OpenDAP-org/board/README.md

# Board

Main board of the OpenDAP T1: the SoC-based single board computer, its auxiliary MCUs and simulations.

## Layout

- `hardware/`
- `firmware/`
- `sim/`
- `export/`
- `docs/`

## License

This repository follows the [REUSE](https://reuse.software) layout: license texts live in `LICENSES/` and `REUSE.toml` maps each path to its license.

- Default: **Creative Commons Attribution-ShareAlike 4.0** (`CC-BY-SA-4.0`)
- `hardware/`: **CERN Open Hardware Licence v2 – Strongly Reciprocal** (`CERN-OHL-S-2.0`)
- `firmware/`: **MIT** (`MIT`)
- `sim/`: **GNU GPL v3.0 or later** (`GPL-3.0-or-later`)
- `export/`: **CERN Open Hardware Licence v2 – Weakly Reciprocal** (`CERN-OHL-W-2.0`)
- `docs/`: **Creative Commons Attribution-ShareAlike 4.0** (`CC-BY-SA-4.0`)

Copyright © 2026 The OpenDAP Project.
