OpenDAP-org/board/docs/concept-art/README.md

# Concept art

These images are screenshots of interactive 3D concept models from earlier experiments (artifacts dated 2026-10-22). They are kept here as visual inspiration only.

**They are not designs, specifications or decisions.** The captures give the general visual idea, but their parts and exploded views often have glitches and bad design decisions, because they were not based on real data or simulations. Dimensions, part choices, component placement and layouts shown in them may be wrong and must not be taken from them. This also applies to any text visible in the captures (title panels, labels, numbers): it comes from the old experiment and is not confirmed information.

The real design is built in this repository, with simulation and real structure.

## Images

- `sbc-three-quarter.png`: Three-quarter view of a dark green-black circuit board with gold edge-connector fingers at the top, large black module blocks in the centre and connectors along the bottom edge.
- `sbc-side-b.png`: Flat view of the other side of the board: mostly bare dark surface with a grid of gold dots, a long slim connector near the right edge and a few parts at the bottom.
- `sbc-exploded.png`: Exploded view: the board with its stacked modules and shields pulled apart to the left, a blue card to the right and bottom connectors floating below.
