OpenDAP-org/board/docs/specs/pcb-design-constraints.md

# Main board PCB design constraints

- **Status:** Draft v0.11 (2026-10-24: [stackup v1](stackup-v1.md) applied, its §7: board thickness, build and layer count (PCB-S-01 to S-03), the stack meets S-04 and S-12, dielectrics (S-05), new PCB-S-14 (impedance classes on L1, L3, L8, L10 only) and S-15 (delay matching across layers), the impedance-class exception to PCB-G-01, the width and gap of every impedance class (PCB-I-01 to I-09, I-12), PCB-I-07 reworded as a microstrip over a cut-out, the RF stack values and the `RF_CUTOUT` rule area (PCB-R-03); DRC rules for widths, pair gaps, layers and the RF cut-out). Was Draft v0.10 (2026-10-24: hat-standard [interface v1.1](https://github.com/opendap-project/hat-standard/blob/main/docs/specs/interface-v1.md) and its [ADR 0005](https://github.com/opendap-project/hat-standard/blob/main/docs/adr/0005-interface-v1-1-shared-extension-and-contact-reduction.md): the shared extension class `HAT_EXT_100D` (PCB-I-12), the extension switch placement (PCB-I-13), PCIe and CSI-2 rows ending at the switch, one DF40 connector; HAT power rows at the tolerance-included trips of [BOM v1.11](bom-v1.md#changes-in-v111) with a new `PWR_HAT5V` class (PCB-P-04, P-05, P-20); DRC rules for P-20 and the extension via count). Was Draft v0.9 (2026-10-24: battery interface rows PCB-L-04 to L-10 from [ADR 0020](../adr/0020-battery-connected-through-contacts.md) and its [research note](../research/2026-10-contact-battery-t1.md) §6, with DRC rules for L-04, L-05 and L-08; wording of PCB-M-07, Z-01, P-01, P-17 and L-02 for the battery contacts). Was Draft v0.8 (2026-10-24: metal-case antenna rows PCB-R-08 to R-13, BRD-061), Draft v0.7 (2026-10-24: radio rows from ADR 0018) and Draft v0.6 (2026-10-24; v0.2 applies ADR 0016, v0.3 Rockchip's layout rules, v0.4 Murata's 2EL notes and the interface standards, v0.5 the design-for-compliance constraints and RFC 0010 levels, v0.6 the DFM rule families, the industry-wisdom gaps and the craft net-class names). Task E2.1 of the [electronics plan](https://github.com/opendap-project/t1/blob/main/docs/plans/2026-10-electronics-plan.md). Nothing here is laid out or measured yet.
- **Method:** this specification applies the [PCB design constraints method](https://github.com/opendap-project/toolkit-hardware/blob/main/docs/specs/pcb-design-constraints-method.md) every OpenDAP board follows (sections, categories and IDs, columns, enforcement kinds, levels and severity).
- **Purpose:** every limit the main-board layout must respect, derived from the product requirements, the parts and the fab, in one place. Each constraint has an ID, a minimum, a target and a maximum where they apply, its source, and the mechanism that enforces it.
- **Changes in v0.6:** DFM families H, B, D, V, W and L added as constraints; industry-wisdom gaps added under new IDs (mapping in the gaps note, "IDs as integrated"); PCB-I-09 reworded (no guard traces) with the MCLK branch limit; impedance-controlled net classes renamed `<name>_<ohms>SE` / `<name>_<ohms>D`; project rules composed in `hardware/t1-main-board/`.
- **Enforced by:** `DRC` = the T1 product rules ([`hardware/rules/`](../../hardware/rules/)), composed after the PCBWay HDI fab rule set and the OpenDAP craft rule set into [`hardware/t1-main-board/t1-main-board.kicad_dru`](../../hardware/t1-main-board/) (E3.4, E3.5); a rule whose value is still **UNVERIFIED** is a DRC warning, the others are errors; `NC` = net class in [`hardware/rules/netclasses.toml`](../../hardware/rules/netclasses.toml) (E2.4); `CHK` = a script check on the layout (E4.5); `SIM` = a simulation in `sim/` (E4.4); `REV` = a review item with its checklist line, because no tool can check it.
- **Levels:** `[Qn]` after an ID is the RFC 0010 quality level at which the constraint becomes mandatory; an ID without it is Q1 until it is next reviewed.
- **Values:** a value with no source is not used. **UNVERIFIED** marks values taken from a sibling part, an assumption, or a source not yet retrieved; each one names what closes it. Arithmetic is shown as such. Rows of families H, B, D, V, W and L cite the [DFM and reliability rules](../research/2026-10-pcb-dfm-reliability-rules.md) research (`DFM §n` and its source keys); rows from the [industry wisdom gaps](../research/2026-10-industry-wisdom-t1-gaps.md) cite their gap (`G-nn`) and practice (`IW-…`).

## 0. Summary

1. **Front side under the display: parts up to 1.0 mm; the body grows to 25 mm** ([ADR 0016](../adr/0016-front-side-height-under-the-display.md)). The thickness stack gave 0.3 mm between the display and the board, while about 2,100–3,700 mm² of parts must sit under the display. The extra 1.0 mm comes from body thickness (T1-031 maximum), not from the battery, whose energy is the limit of T1-039. No thickness margin is left within 25 mm.
2. **High-speed values come from Rockchip's documents** ([RK3566 layout rules](../research/2026-10-rk3566-layout-rules.md): RK3566 Hardware Design Guide V1.1.0 and the RK3568 High Speed PCB Design Guide V1.0.0, which covers the same interface blocks). LPDDR4X is 50 Ω single-ended and 100 Ω differential; the PCIe reference clock is 100 Ω, a class of its own. Where Rockchip is looser than a standard or than the T1's need, the T1 keeps the tighter value and says why.
3. **The main board is an HDI build, without via-in-pad as a requirement.** The RK3566 has 343 core balls at 0.65 mm and a two-row ring of 222 balls at 0.4 mm. Laser microvias as dog-bones in the 0.825–0.875 mm channel between the ring and the core escape every inner-ring ball (arithmetic on the package drawing, [RK3566 layout rules](../research/2026-10-rk3566-layout-rules.md) §3); through vias do not fit there. Rockchip itself uses 4–6 layers, so the T1's 8–10 layers rest on its own density, double-sided z budget and audio partition, to be confirmed by an escape study.
4. **Copper for power is sized for the protection rating, not the typical draw** (BRD-049): the battery path carries the 5 A fuse rating continuously with ≤ 10 °C rise.
5. **Audio rules come from the CS43198 and OPA1622 datasheets** and from the decided topology (ADR 0010, 0012, 0015): split nothing, partition everything.
6. **The battery connects through six spring contacts in a window of the pocket floor** ([ADR 0020](../adr/0020-battery-connected-through-contacts.md); v0.9): two contacts per power pole, an empty position between P+ and the signals, only battery nets and GND in the contact area, and the ESD diodes at the contacts (PCB-L-04 to L-10). DRC checks the partition, the empty position and the ESD placement; heights, tolerances and pour symmetry are CHK and REV items.
7. **The HAT extension shares five pairs between PCIe and CSI-2 through two TI TMUXHS4412 switches** (hat-standard ADR 0005; v0.10). BRD-042 accepts a standard switch that keeps the full rate with margin: at the PCIe Gen2 Nyquist frequency (2.5 GHz) the switch's typical figures are −0.7 dB insertion loss, −23 dB return loss and −64 dB crosstalk; its −3 dB bandwidth (13 GHz) is 5.2× that frequency and 10.4× the 1.25 GHz Nyquist frequency of D-PHY at the RK3566's 2.5 Gb/s per lane (TI SLASEW5A §5.6, typical values only). The shared segment from the switch to the DF40 is one 100 Ω class (`HAT_EXT_100D`, PCB-I-12); PCIe AC capacitors sit on the SoC side of the switch, CSI-2 lane matching runs from the SoC ball to the DF40 through the switch, and the switch sits so the port branches are short (PCB-I-13). Signal integrity through the switch, the DF40, the flat cable and the pogo field is **UNVERIFIED** until the hat-standard coupon.
8. **The board is ten layers, HDI 2+6+2, 1.07 mm nominal** ([stackup v1](stackup-v1.md); v0.11). Four routing layers (L1, L3, L8, L10), each next to a solid ground; four ground planes; two power planes paired with ground. Impedance classes route only on the four routing layers (PCB-S-14), and each class has a width per layer (PCB-I). The stack rests on PCBWay's published data and stated assumptions until PCBWay's DFM review, so its DRC rules are warnings until then.

## 1. Outline and mechanics (inputs from the product)

The case owns its walls, bosses and keep-outs; these values are the board's inputs until the case and the t1 interface files (E4.6) publish them.

| ID | Constraint | Min | Target | Max | Source | Enforced by |
|---|---|---|---|---|---|---|
| PCB-M-01 | Body the board lives in | — | 59.5 × 94.3 × 25.0 mm | 62.5 × 95 × 25 mm (T1-031) | [t1 ADR 0003](https://github.com/opendap-project/t1/blob/main/docs/adr/0003-tentative-body-size.md), [ADR 0016](../adr/0016-front-side-height-under-the-display.md), T1-031 | REV |
| PCB-M-02 | Board outline inside the cavity | — | cavity minus 0.5 mm per side | cavity = body − 2 × wall: 56.3 × 91.1 mm with 1.6 mm walls (arithmetic) | Walls 1.6 mm per side: assumption of the battery selection §2.3, **UNVERIFIED** until the case sets them; clearance 0.5 mm per side **UNVERIFIED** (ISO 2768-m ±0.3 mm on the case plus PCBWay outline ±0.1 mm advanced [P2]) | DRC (board edge), REV |
| PCB-M-03 | Board outline tolerance | — | ±0.1 mm | ±0.2 mm | PCBWay advanced / standard [P1, P2] | fab notes |
| PCB-M-04 | Coordinate system | — | origin at the device centre, x across, y along, +z towards the faceplate | — | T1-021 (Draft) | KiCad grid origin, export (E4.9) |
| PCB-M-05 | Edge connectors on the bottom edge, left to right | — | 3.5 mm jack, 4.4 mm jack, USB-C centred, speaker on the right | — | T1-016 | REV |
| PCB-M-06 | Side buttons | — | Action, Vol+, Vol− on the left edge; Main on the right | — | T1-014, T1-015 | REV |
| PCB-M-07 | Battery contacts in a window of the pocket floor at the pocket's bottom end (v0.9; was: Micro-Fit 3.0 connector in a notch outside the pocket) | — | Six KYOCERA AVX 70-9258-001-120-006, face compression (PCB-L-04 to L-06) | — | [ADR 0020](../adr/0020-battery-connected-through-contacts.md), BOM line 47 | REV |
| PCB-M-08 | Mounting holes | 4 | 4 (two top, two bottom bosses) | — | Battery selection §2.3 (Ø 4 bosses), **UNVERIFIED** until the case | DRC (PCB-H-01 to H-06), REV |
| PCB-M-09 | Fiducials | 3 global per populated side | 3 + 2 local at the RK3566 | — | PCBWay assembly practice, **UNVERIFIED** (ask in DFM review) | DRC (PCB-D-02 to D-04), CHK (count per side), REV |

### 1.1 Mounting holes (PCB-H)

The screw is not chosen (M2 or M1.6 class). The rings are sized for the larger case, an M2 screw with an ISO 7089 washer (outer Ø 5.0 mm) in a 2.2 mm hole: (5.0 − 2.2) / 2 = 1.4 mm from the hole edge (arithmetic, [DFM and reliability rules](../research/2026-10-pcb-dfm-reliability-rules.md) §2). Every H rule is a DRC warning until the case fixes the screw (CHK-H-01).

| ID | Constraint | Min | Target | Source | Enforced by |
|---|---|---|---|---|---|
| PCB-H-01 [Q1] | No part under the screw head or washer: courtyards from the hole edge | 1.4 mm | 1.4 mm | ISO 7089 [F1], arithmetic; screw **UNVERIFIED** | DRC |
| PCB-H-02 [Q1] | No copper of another net under the head, outer layers | 1.4 mm | 1.4 mm | [F1]; Rockchip HSPCB p. 12 (no traces near mounting holes); screw **UNVERIFIED** | DRC |
| PCB-H-03 [Q2] | A plated mounting hole is on GND | — | — | Proposal (chassis and ESD path); plated or not is undecided (CHK-H-02) | DRC |
| PCB-H-04 [Q1] | Mounting hole to board edge | 1.5 mm | 1.5–2 mm | ALLPCB [AP] (secondary), **UNVERIFIED**: no primary source | DRC |
| PCB-H-05 [Q1] | MLCC (`C*`) courtyard to the hole edge | 3 mm | 3 mm | Murata "as far away from the screw holes as possible" [MU]; number **UNVERIFIED** | DRC, REV (CHK-H-03, orientation) |
| PCB-H-06 [Q2] | BGA balls to the hole edge | 5 mm | 5 mm | **UNVERIFIED** (IPC-7095 not retrieved) | DRC |

### 1.2 Board edges and panel (PCB-B)

The board is routed and held in PCBWay's panel by tabs with rails [P20]; rule areas `BREAK_TAB` mark the tabs.

| ID | Constraint | Min | Target | Source | Enforced by |
|---|---|---|---|---|---|
| PCB-B-01 [Q1] | Courtyard to board edge, except edge parts `J*` and `SW*` | 0.3 mm | 0.3 mm | PCB-G-05 applied to the body, **UNVERIFIED** | DRC, REV (CHK-B-03, overhangs) |
| PCB-B-02 [Q1] | Copper to the edge at a break tab | 0.4 mm | 0.4 mm | JLCPCB copper to a V-cut [JL]; **UNVERIFIED** for tabs (PCBWay publishes none) | DRC |
| PCB-B-03 [Q1] | MLCC courtyard to a broken edge | 5.08 mm | 5.08 mm | KYOCERA AVX quoted by DigiKey [DK] (secondary) | DRC, REV (CHK-B-01, CHK-B-02) |

## 2. Height zones (z)

Heights are above the board surface. "Front" is +z (towards the display), "back" is −z (towards the battery).

| ID | Zone | Max part height | Source | Enforced by |
|---|---|---|---|---|
| PCB-Z-01 | Back, under the battery pocket footprint (RK3566, LPDDR4X, eMMC here) | 1.5 mm, shield can and thermal pad included; exception: the battery contacts in the pocket-floor window (free height 3.3 mm, PCB-L-05) | Battery selection §2.2; ADR 0016 | CHK (3D height per zone) |
| PCB-Z-02 | Back, bottom band (jacks, USB-C, speaker) and top band (microSD, antenna feed) | 14.2 mm (arithmetic: battery layer 12.3 + 1.5 + 0.4) | Battery selection §2.2, §2.3; ADR 0016 (fixed stack 12.7 mm at 25 mm) | CHK |
| PCB-Z-03 | Front, under the display module | 1.0 mm (FH35C 0.9 ± 0.1 mm included); no shield cans; display-to-board gap 1.3 mm | ADR 0016 | CHK |
| PCB-Z-04 | Front, outside the display footprint | 6.8 mm where the faceplate frame leaves room, **UNVERIFIED** until the faceplate mechanics exist | ADR 0016 | CHK |
| PCB-Z-05 | Tallest known parts and their zone | G-Switch 4.4 mm jack 6.5 mm (bottom band), USB4105 3.31 mm (bottom band), DM3AT microSD 1.68 mm (top band), XAL4020 inductor 2.1 mm (bands only), DF40 header 1.14 mm, FH35C 0.9 mm | parts-lib sheets | CHK |

## 3. Stackup and build

No general power-plane pull-back (20-H) rule: Hubing's measurements show it increases power-bus radiation (IW-SR-05); each plane is decided in the stackup review (note under §1.1 of the [industry wisdom gaps](../research/2026-10-industry-wisdom-t1-gaps.md)).

| ID | Constraint | Min | Target | Max | Source | Enforced by |
|---|---|---|---|---|---|---|
| PCB-S-01 | Board thickness | 1.0 mm | 1.07 mm nominal (stackup v1), ±0.10 mm, ≤ 1.2 mm | 1.2 mm (z stack) | Battery selection §2.2 (1.2 mm); PCBWay HDI example 8 layers 1.0 ± 0.1 mm [P3]; [stackup v1](stackup-v1.md) §1 | fab notes, export |
| PCB-S-02 | Build | 1+N+1 | 2+N+2, stacked copper-filled microvias L1–L2–L3 and L10–L9–L8 (second level 0.125 mm laser **UNVERIFIED**), through vias, no buried vias in v1; via-in-pad only where the escape study needs it | any-layer only if the escape study needs it | [RK3566 layout rules](../research/2026-10-rk3566-layout-rules.md) §3: microvias needed for the 0.4 mm ring, not necessarily in the pad; [stackup v1](stackup-v1.md) §1 | stackup, DRC (via types) |
| PCB-S-03 | Layer count | 8 | 10 (stackup v1) | 10 (1.2 mm limit, PCBWay 10-layer HDI example is 1.3 mm [P3]) | Four routing layers each next to ground and two power planes paired with ground (PCB-S-11, S-12, I-09; [stackup v1](stackup-v1.md) §0); T1 density, double-sided z budget, audio planes; Rockchip's templates use 4–6 ([RK3566 layout rules](../research/2026-10-rk3566-layout-rules.md) §2); escape study (E4) | stackup |
| PCB-S-04 | Reference planes | — | Every high-speed and every analog-audio layer adjacent to a solid ground plane. Satisfied by stackup v1: every routing layer next to ground, L3 and L8 between two grounds, L5 and L6 each with a ground at 65 µm | — | Standard practice; CS43198 §8 (DS1156F2 p. 121); [stackup v1](stackup-v1.md) §2 | stackup v1, REV |
| PCB-S-05 | Dielectric | 50 µm (impedance) | per stackup v1: 50–120 µm | — | [P2, P12]; [stackup v1](stackup-v1.md) §2 | stackup (`odapkit stackup check`; PCBWay's DFM review confirms) |
| PCB-S-06 | Material | Tg 170 FR-4 | Tg 170, high-speed class 1–5 G if the USB 3 / PCIe loss budget needs it | — | PCBWay materials [P2, P16]; loss budget E4.5. The Dk stackup v1 uses is PCBWay's published table value (S1000-2M datasheet not retrieved, **UNVERIFIED**) | stackup |
| PCB-S-07 | Finish | — | ENIG (or ENEPIG) | — | Fine-pitch BGA and QFN flatness; PCBWay [P1] | fab notes |
| PCB-S-08 | Acceptance class | IPC Class 2 | Class 2 for prototypes | Class 3 on request | [P1, P16] | fab notes |
| PCB-S-10 [Q1] | Ground stitching via at every signal via that changes reference between ground planes, symmetric for pairs | — | ≤ 0.76 mm centre to centre; ≤ 0.64 mm for `DDR_*` | 5.08 mm | G-01; IW-SR-03: Rockchip HSPCB pp. 8, 23; TI SPRACP4A §2.4 | CHK |
| PCB-S-11 [Q1] | Layer change that swaps the reference between ground and a power plane gets a stitching capacitor; classes PCB-I-01 to I-06 and I-09 never reference a power plane. With stackup v1 no signal layer is next to a power plane; the stitching capacitor applies only to routes on L5/L6 | — | 100 nF per 3–4 signal vias | — | G-02; IW-SR-04: Rockchip HSPCB p. 26; TI SPRACP4A §2.4; [stackup v1](stackup-v1.md) rule 4.1.2 | CHK, REV |
| PCB-S-12 [Q1] | Every signal layer adjacent to a ground plane (PCB-S-04 extended); SoC core and LPDDR4X supply planes paired with an adjacent ground at the thinnest HDI dielectric, on the side nearer the front decoupling (ADR 0016) | — | dielectric per PCB-S-05. Satisfied by stackup v1 (see PCB-S-04): L5 with L4 and L6 with L7 at 65 µm | — | G-03; IW-SR-01 (Hartley, Ott), IW-SR-06 (Archambeault), IW-PI-01; [stackup v1](stackup-v1.md) §2 | stackup v1, REV (DRV-302) |
| PCB-S-13 [Q2] | Ground planes stitched by a via grid, with an edge fence | — | edge pitch ≤ 2.5 mm **UNVERIFIED** (arithmetic: λ/10 at 6 GHz in FR-4, εr ≈ 4); interior grid **UNVERIFIED** | — | G-04; IW-SR-07 (Ott, Ritchey; chapters **UNVERIFIED**) | CHK |
| PCB-S-14 [Q1] | Impedance-controlled classes (`*_<ohms>D`, `*_<ohms>SE`) route only on L1, L3, L8 and L10, never on L5/L6 nor on a ground plane; `MCLK_50SE` on L3/L8 only (PCB-I-09), `RF_50SE` on L1/L10 only (PCB-I-07). KiCad layers: L1 `F.Cu`, L3 `In2.Cu`, L5/L6 `In4.Cu`/`In5.Cu`, L8 `In7.Cu`, L10 `B.Cu` | — | as stated | — | [stackup v1](stackup-v1.md) rule 4.1.2, §3 (v0.11) | DRC (layer condition) |
| PCB-S-15 [Q1] | A matched group that changes layers is matched in delay, not in length | — | 7.09 ps/mm inner (L3, L8), 5.9–6.2 ps/mm outer (L1, L10) | — | [stackup v1](stackup-v1.md) §4.2, §5 (v0.11) | CHK |

## 4. Geometry beyond the fab rules

The fab rule set (`pcbway-hdi`, E3.1) carries PCBWay's limits. These are the T1's own, tighter values.

| ID | Constraint | Min | Target | Source | Enforced by |
|---|---|---|---|---|---|
| PCB-G-01 | Track and space, general | 0.1 / 0.1 mm | 0.1 / 0.1 mm or more | Margin over PCBWay HDI 0.065 mm [P3] and normal outer 4/5 mil [P1]; finer only in the BGA escape. **Exception** (v0.11): impedance classes use their stackup widths (PCB-I), down to 0.075 mm on L3/L8 (PCBWay HDI 3/3 mil standard order option, kicad-lib [PCBWay capabilities](https://github.com/opendap-project/kicad-lib/blob/main/docs/research/2026-10-pcbway-capabilities.md) §4.1); the general 0.1 mm stays for every other net | DRC |
| PCB-G-02 | Track and space inside the RK3566 courtyard | 0.065 / 0.065 mm | 0.075 / 0.075 mm | PCBWay HDI [P3] | DRC (area rule) |
| PCB-G-03 | Laser microvia | 0.10 mm drill | 0.10 mm drill, 0.25 mm land | PCBWay 4 mil laser [P3]; land from the 0.25 mm BGA pad (research §2.1) | DRC |
| PCB-G-04 | Mechanical via (outside the BGA) | 0.20 mm drill, 0.45 mm pad | 0.25 / 0.50 mm | PCBWay advanced normal 0.20 mm [P1, P3] | DRC |
| PCB-G-05 | Copper to board edge | 0.30 mm | 0.50 mm | PCBWay 0.20 mm milled [P1]; margin for the ±0.1 mm outline | DRC |
| PCB-G-06 | Courtyard clearance | 0 (no overlap) | 0.1 mm | IPC-7351 courtyard practice | DRC |
| PCB-G-07 | Thermal relief on plane connections of hand-reworkable parts | — | Relief on connectors and test pads; solid on power parts and exposed pads | Assembly and thermal pads (CS43198 §8.4, OPA1622 pad to V−) | DRC (zone rules) |
| PCB-G-08 | Silkscreen | 0.15 mm line, 0.8 mm text | 0.15 / 0.8 mm | PCBWay [P1] | DRC |
| PCB-G-09 [Q1] | Balanced copper on both pads of every 0201 and 0402 part; where a decoupling capacitor needs a solid connection for inductance, both pads get it the same way | — | — | G-31; IW-DF-02 (IPC-7351B, EMS guides, secondary), IW-PI-01 | REV (DRV-318) |
| PCB-G-10 [Q1] | Via treatment: a via in a pad is filled and capped (IPC-4761 type VII); exposed-pad thermal vias filled, plugged or tented per PCBWay's process | — | — | G-32; IW-DF-03, IW-TH-03; PCBWay [P11, P16] | fab notes, DRC (PCB-D-10), REV (DRV-319) |

### 4.1 Voltage spacing (PCB-V)

IPC-2221B Table 6-1 [IPC]: bare-board conductors (B1 0.05 mm internal, B2 0.1 mm external, B4 0.05 mm coated, 0–30 V) are met by PCB-G-01 and PCB-G-02; uncoated component terminations (A6) are not. Every net is in the 0–15 V row in steady state (battery and VSYS ≤ 8.8 V, USB-C PD up to 12 V); VBUS reaches the 16–30 V row in a surge (TVS2200 clamp 28.4 V). Creepage: none set until the compliance work establishes whether IEC 62368-1 asks for it in ES1 circuits (CHK-V-01).

| ID | Constraint | Min | Target | Source | Enforced by |
|---|---|---|---|---|---|
| PCB-V-01 [Q1] | Pad on an outer layer to copper of another net, pads of one footprint excepted, outside `BGA_ESCAPE` | 0.13 mm | 0.13 mm | IPC-2221B Table 6-1, A6, 0–15 V [IPC] (quoted by Altair, secondary) | DRC |
| PCB-V-02 [Q1] | VBUS pad to copper of another net | 0.25 mm | 0.25 mm | A6, 16–30 V [IPC]; voltages from the BOM (TVS2200) | DRC |

### 4.2 Routing hygiene (PCB-W)

Acute angles, 45° routing and short segments are craft rules (CRAFT-40, -41, -47 in kicad-lib `opendap-craft`), not repeated here.

| ID | Constraint | Min | Target | Source | Enforced by |
|---|---|---|---|---|---|
| PCB-W-01 [Q1] | No copper neck or sliver narrower than the narrowest track | 0.1 mm; 0.065 mm in `BGA_ESCAPE` | — | PCB-G-01; PCBWay HDI [P3] | DRC |
| PCB-W-02 [Q2] | Teardrops enabled on every via | — | — | Margin for the 0.075 mm microvia ring [P2, P3]; as a requirement **UNVERIFIED** | DRC |
| PCB-W-03 [Q2] | Vias per line: USB 3 ≤ 2, PCIe ≤ 2, MIPI ≤ 4, USB 2 ≤ 6; HAT extension (`HAT_EXT_100D`) ≤ 2, the stricter of PCIe and MIPI because the segment carries either (v0.10) | — | as listed | Rockchip HSPCB Tables 1, 2, 5, 10 ([RK3566 layout rules](../research/2026-10-rk3566-layout-rules.md); RK3568 edition) | DRC |

## 5. Signal classes

Impedance-controlled classes are named `<name>_<ohms>SE` (single-ended) or `<name>_<ohms>D` (differential), the form the craft rules exempt from their general width rules. Impedance tolerance on the board is PCBWay's ±10 % [P1]. A class whose standard allows less has to say so; those windows are **UNVERIFIED** until the standards' texts are in parts-lib or the docs.

| ID | Net class | Signals | Impedance | Length and skew | Source | Enforced by |
|---|---|---|---|---|---|---|
| PCB-I-01 | `USB2_90D` | Main USB-C D± (OTG0), HAT `USB3_D±` | 90 Ω ±10 % differential. Stackup v1 (W / gap): L1/L10 101.5 / 100 µm, L3/L8 86.0 / 150 µm | Intra-pair skew ≤ 0.15 mm (T1; Rockchip allows 0.51 mm); ≤ 152 mm; ≤ 4 vias; 2.2 Ω series at the SoC | HSPCB p. 13; HDG p. 59 ([RK3566 layout rules](../research/2026-10-rk3566-layout-rules.md)) | NC, DRC (width, pair gap minimum, layers), CHK |
| PCB-I-02 | `USB3_90D` | HAT `USB3_SSTX±`, `USB3_SSRX±` | 90 Ω ±10 % differential. Stackup v1 (W / gap): L1/L10 101.5 / 100 µm, L3/L8 86.0 / 150 µm | Intra-pair ≤ 0.30 mm; ≤ 152 mm; ≤ 2 vias; spacing ≥ 4 × W; 100 nF 0201 AC caps on SSTX | HSPCB p. 13; HDG p. 59 | NC, DRC (width, pair gap minimum, layers), CHK |
| PCB-I-03 | `PCIE_85D`, `PCIE_REFCLK_100D` | HAT `PCIE_TX±`, `PCIE_RX±`; `PCIE_REFCLK±`, from the SoC to port A of the extension switch (v0.10; beyond the switch: PCB-I-12) | 85 Ω ±10 % data; 100 Ω ±10 % reference clock. Stackup v1 (W / gap): data L1/L10 118.0 / 100 µm, L3/L8 98.5 / 150 µm; reference clock L1/L10 104.5 / 175 µm, L3/L8 75.0 / 250 µm | Intra-pair ≤ 0.30 mm; ≤ 152 mm SoC ball to DF40 pad, both segments together; ≤ 2 vias end to end; spacing ≥ 4 × W (≥ 5 × W to other signals recommended); 100 nF 0201 AC caps on TX **between the SoC and the switch**, never on the shared segment (CSI-2 is DC-coupled; hat-standard interface v1 §4.4; TI SLASEW5A Figure 7-1 option b) | HSPCB p. 15; HDG p. 89 | NC, DRC (width, pair gap minimum, layers), CHK |
| PCB-I-04 | `MIPI_100D` | Faceplate DSI; HAT CSI-2 from the SoC to port B of the extension switch (v0.10; beyond the switch: PCB-I-12) | 100 Ω ±10 % differential. Stackup v1 (W / gap): L1/L10 104.5 / 175 µm, L3/L8 75.0 / 250 µm | Intra-pair ≤ 0.1 mm (T1; Rockchip 0.30 mm); data to clock ≤ 0.91 mm (for CSI-2 measured SoC ball to DF40 pad through the switch, PCB-I-12); ≤ 152 mm; ≤ 4 vias (CSI-2: PCB-I-12 sets ≤ 2 end to end); spacing ≥ 3 × W | HSPCB pp. 18–19 | NC, DRC (width, pair gap minimum, layers), CHK |
| PCB-I-05 | `DDR_50SE`, `DDR_100D` | LPDDR4X: DQ, DM, CA single-ended; DQS, CK differential | 50 Ω ±10 % single-ended, 100 Ω ±10 % differential. Stackup v1: single-ended L1/L10 134.5 µm, L3/L8 78.5 µm; pairs (W / gap) L1/L10 104.5 / 175 µm, L3/L8 75.0 / 250 µm | DQ/DM to DQS within a byte ≤ 15.2 mm; CA to CK ≤ 12.7 mm; DQS and CK pair halves ≤ 0.30 mm; DQS to CK ≤ 30.5 mm; spacing ≥ 2 × W (≥ 3 × W around DQS and CK); no DQ or CA swapping; a layout that departs from Rockchip's template is simulated | HSPCB pp. 44–45, Table 34 | NC, DRC (width, pair gap minimum, layers), CHK, SIM |
| PCB-I-06 | `EMMC_SD_50SE` | eMMC (HS200), microSD (SDR104, BRD-051), SDIO to the radio | 50 Ω ±10 % single-ended. Stackup v1: L1/L10 134.5 µm, L3/L8 78.5 µm | Data and CMD to CLK ≤ 2 mm (T1; Rockchip 3.05 mm); ≤ 102 mm; ≤ 4 vias; 22 Ω series on CLK; SD ESD < 1 pF | HSPCB pp. 19–20; HDG pp. 26, 52, 54 | NC, DRC (width, layers), CHK |
| PCB-I-07 | `RF_50SE` | Module RF pins to U.FL | 50 Ω microstrip over the L3 (L8) ground, L2 (L9) cut out 1.6 mm, same-layer ground ≥ 0.6 mm ([stackup v1](stackup-v1.md) §4.4; v0.11, was "coplanar with ground", which conflicted with PCB-R-03). Width 391 µm on L1/L10 | Shortest; π network at the pin | U.FL-R-SMT-1 50 Ω; Murata layout guide **UNVERIFIED** | NC, DRC (width, layers, same-layer ground, `RF_CUTOUT`), REV |
| PCB-I-08 | `I2S_50SE` | SoC → CS43198 ASP (SCLK, LRCK, SDIN) | 50 Ω single-ended, series-terminated at the source. Stackup v1: L1/L10 134.5 µm, L3/L8 78.5 µm | Matched within the bus ≤ 5 mm **UNVERIFIED**; slave SCLK ≤ 24.58 MHz | CS43198 Table 3-18; test pads BRD-040 | NC, DRC (width, layers), CHK |
| PCB-I-09 [Q1] | `MCLK_50SE` | 22.5792 / 24.576 MHz oscillators → attenuator → CS43198 XTI (two DACs) | 50 Ω stripline: an inner layer between two ground planes (L3 or L8 only, PCB-S-14), no change of reference; stackup v1 width 78.5 µm. No guard traces: a guard trace only if via-stitched along its length, and never counted as the protection | Oscillator to the split and the split to each XTI ≤ 20 mm per branch (the simulated limit case; a 30 mm branch gives 44.8 % duty, outside 45–55 %); ≥ 3 × trace width from any other signal; away from FILT± | ADR 0010; CS43198 §8 (keep clocks away from FILT±); G-06, IW-SR-05 (Hubing, LearnEMC); [`sim/mclk-attenuator`](../../sim/mclk-attenuator/README.md) results 2026-10-24 (typical oscillator drive; NDK drive **UNVERIFIED**) | NC, DRC (spacing, width, layers), CHK (branch length), SIM, REV (DRV-308) |
| PCB-I-10 [Q1] | `USB2_90D`, `USB3_90D`, `PCIE_85D`, `PCIE_REFCLK_100D`, `MIPI_100D`, `HAT_EXT_100D` | SMD pads on those classes (AC capacitors, ESD parts, connector pads, the extension switch's signal pads) | Reference plane voided under the pad, 100 % of the pad, two layers deep (stackup v1: under an L1 pad the void is L2 + L3, so the pad references L4, 356 µm below; mirrored for L10, rule 4.1.4); equal via count on both members of a pair and across matched lanes | — | G-05; IW-HS-02, IW-HS-04: TI SPRACP4A §2.12–2.13; Rockchip HSPCB pp. 8–11 | DRC (keep-out on pads), CHK |
| PCB-I-11 [Q1] | Connector pin maps | Every connector carrying fast pairs (the HAT DF40C-100, pogo field, FH35C) | Each pair has adjacent ground contacts (G-S-S-G or better); input to E1.2 and E1.3 | — | G-07; IW-HS-01 (Johnson, chapter **UNVERIFIED**); module rule M3 | interface files (E4.6), REV (DRV-320) |
| PCB-I-12 [Q1] | `HAT_EXT_100D` | HAT extension `EXT0±`–`EXT4±` (hat-standard interface v1.1 §4.4): from the common port (D) of the two TMUXHS4412 to the DF40C-100 header, then on the flat cable (BOM line 102). PCIe REFCLK, TX, RX on `EXT0`–`EXT2` or CSI-2 D0, CLK, D1, D2, D3 on `EXT0`–`EXT4`, one function at a time | 100 Ω ±10 % differential; stackup v1 (W / gap) L1/L10 104.5 / 175 µm, L3/L8 75.0 / 250 µm (CSI-2 needs 100 Ω; the PCIe side changes from 85 Ω to 100 Ω at the switch, a reflection coefficient of (100 − 85) / (100 + 85) = 8 %, arithmetic; **UNVERIFIED** until the coupon) | Intra-pair ≤ 0.1 mm (the MIPI value, tighter than PCIe's); CSI-2 data to clock (`EXT0`, `EXT2`–`EXT4` against `EXT1`) ≤ 0.91 mm **SoC ball to DF40 pad**, port-B segment, switch channel and shared segment together; the switch adds 4 ps typical inter-pair skew (TI SLASEW5A §5.7), which no layout can trim, and the skew between its two packages is not specified (**UNVERIFIED**, coupon); ≤ 152 mm SoC ball to DF40 pad; ≤ 2 vias end to end (the PCIe value, stricter than MIPI's 4); spacing ≥ 4 × W; no AC capacitor and no branch on this segment | Hat-standard interface v1.1 §4.4 and [ADR 0005](https://github.com/opendap-project/hat-standard/blob/main/docs/adr/0005-interface-v1-1-shared-extension-and-contact-reduction.md); HSPCB pp. 15, 18–19; TI SLASEW5A | NC, DRC (via count, width, pair gap minimum, layers), CHK |
| PCB-I-13 [Q1] | Extension switch placement and stubs | Two TI TMUXHS4412 (BOM line 144) | Both packages side by side between the PCIe and CSI-2 escapes and the DF40 route, so the port-A and port-B segments are as short as placement allows: the unselected port's trace stays connected to the switch's open channel and loads the common node with its off-state capacitance, and its PHY sees the active link attenuated by the off isolation (−27 dB typical at 2.5 GHz, SLASEW5A §5.6); nothing branches on the common side; CSI-2 clock (`EXT1`) and lanes D0–D2 in one package, D3 (`EXT4`) in the other, so three of four lanes share the clock's package; unused channels (second package, channels 1–3, and port A of `EXT3`/`EXT4`, reserved for a second PCIe lane) left unconnected; VCC on vcc3v3_sys (3.3 V mode: common mode 0–1.8 V covers D-PHY low-power signalling, SLASEW5A §5.3) with 0.1 µF at each VCC pin; RSVD pin to GND through 4.7 kΩ; thermal pad to GND with vias; layout per SLASEW5A §7.5 (layout example Figure 7-12, and the TI application note *High-Speed Layout Guidelines for Signal Conditioners and USB Hubs* it names) | — | TI SLASEW5A §§4, 5.3, 5.6, 6.3, 7.2–7.5 | REV (DRV-320), CHK |

## 6. Power and current

Widths are the IPC-2221 external/internal formula at ΔT = 10 °C (conservative, arithmetic: I = k·ΔT^0.44·A^0.725), as provisional minimums for the net classes; sign-off uses IPC-2152 at layout (E4.5). Currents are the protection rating or the worst continuous case, whichever is higher (BRD-049).

Outer layers are taken at 35 µm finished (18 µm base plus plating, **UNVERIFIED** until the PCBWay stackup) and inner layers at 18 µm, the HDI base copper [P3].

| ID | Path | Design current | Min width, outer (35 µm) | Min width, inner (18 µm) | Source | Enforced by |
|---|---|---|---|---|---|---|
| PCB-P-01 | Battery: battery contacts → fuse → BQ25798 BAT; P− contacts → sense resistor → GND | 5.0 A (fuse) | 2.8 mm or a pour | 14.0 mm, so a pour on two or more layers | BOM lines 43, 47, 104; ADR 0014, ADR 0020 | DRC (`PWR_BAT`), CHK (copper area per net) |
| PCB-P-02 | VSYS (6.0–8.8 V) trunk | 3.2 A worst continuous | 1.5 mm or a pour | 7.6 mm or a pour | Power tree §4.7, BOM §7 item 17 | DRC (`PWR_VSYS`), CHK |
| PCB-P-03 | VBUS → TPS2121 → BQ25798 | 3.0 A (TPS2121 ILM max) | 1.4 mm | 6.9 mm or a pour | Power tree line VBUS_CHG | DRC (`PWR_VBUS`) |
| PCB-P-04 | 5.1 V source: TPS62903 output to the eFuse #A and #C inputs, eFuse #C output (USB-C source) | 1.68 A (eFuse #A/#C maximum trip with the RILM tolerance; v0.10, was 1.66 A) | 0.65 mm | 3.2 mm | Power tree §4.6 (v0.5) | DRC (`PWR_5V1`) |
| PCB-P-05 | HAT_3V3: eFuse #B output to the DF40 | 1.16 A (eFuse #B maximum trip with the RILM tolerance; v0.10, was 1.0 A, the typical setting, which BRD-049 does not allow) | 0.4 mm | 1.9 mm | Power tree §4.6 (v0.5) | DRC (`PWR_HAT3V3`) |
| PCB-P-20 [Q0] | HAT_5V: eFuse #A output, the DF40 power contacts and the TPS2121 IN2 branch (both directions: out to a class A/B HAT, in from a class F powerbank HAT) | 3.0 A (hat-standard interface fault ceiling; the T1's TPS2121 trips at 2.95 A at most, BOM line 45) | 1.4 mm | 6.9 mm or a pour | Hat-standard interface v1.1 §5; power tree §4.6 (v0.5); v0.10 (this path was in `PWR_5V1` at 1.66 A, which missed the inbound direction) | DRC (`PWR_HAT5V`) |
| PCB-P-06 | Amplifier rails ±7 V / ±6 V | 0.3 A per rail (275 mA design case) | 0.3 mm (the current needs 0.06 mm; the width keeps the rail impedance low) | 0.3 mm | Power tree §4.10.1, ADR 0015 | DRC (`PWR_AMP`) |
| PCB-P-07 | Switching loops (BQ25798, TPS62136, TPS62903 ×2, LMR33630C, TPS65131, RK809, RK860, TPS62840) | — | Input capacitor, switch node and inductor on one side, loop area per each datasheet layout example | — | Each part's datasheet layout section (parts-lib) | REV |
| PCB-P-08 | Switch-node copper | — | Smallest area that carries the current; no other net under it on the adjacent layer except ground | — | Standard practice, datasheets | REV |
| PCB-P-09 | Vias per amp of plane change | — | ≥ 1 via (0.25 mm) per 0.5 A **UNVERIFIED**; for laser microvias per the PCBWay copper fill | — | Rule of thumb, to replace with an IPC-2152 via calculation (E4.5) | CHK |
| PCB-P-10 | Decoupling | — | Smallest capacitor closest to its pin with the shortest via path; for the RK3566 and LPDDR4X, Rockchip's placement under the package on the opposite side (with ADR 0016 the SoC is on the back, so its decoupling goes on the front, under the ball field, within PCB-Z-03); values per supply from the HDG | — | CS43198 §8; HDG ([RK3566 layout rules](../research/2026-10-rk3566-layout-rules.md) §4) | REV |

Rules without a width:

| ID | Constraint | Source | Enforced by |
|---|---|---|---|
| PCB-P-12 [Q1] | A board frequency plan: every converter's frequency range and light-load mode (BQ25798, TPS62136, TPS62903 × 2, LMR33630C, TPS65131, RK809-5, RK860-0, TPS62840, TPS61160 (v0.10, BOM v1.11; was TPS61169)), the beats between any two, and the harmonics in 2.4 and 5 GHz; no beat in the audio band during playback | G-14; IW-SW-03; BOM line 116 | REV (DRV-112) |
| PCB-P-13 [Q1] | Light-load mode of every converter feeding audio. TPS65131: power-save disabled during playback if its pin allows (pin behaviour **UNVERIFIED**, SLVS493E). LMR33630C: no forced PWM, so its idle bursts are measured at the amplifier output (ADR 0015); if one falls in the audio band above the T1-048 warning, a minimum load on AUDIO_N7V0 (footprint reserved, DNP, value **UNVERIFIED**) or another part follows | G-15; IW-SW-04, IW-SW-05 | REV (DRV-113), V2 bench |
| PCB-P-14 [Q1] | The LMR33630C follows SNVA856B's inverting buck-boost layout, not the buck layout of its datasheet: the input capacitors from VIN to the −7 V IC ground form the hot loop and sit closest | G-16; IW-SW-01; TI SNVA856B (BOM line 116) | REV (DRV-207) |
| PCB-P-15 [Q0] | Insertion transients checked against the absolute maximum of every part on BAT, VSYS, VBUS and the HAT 5.1 V output, with ceramic input capacitors ringing up to twice the source voltage: battery 2 × 8.8 V = 17.6 V worst case (arithmetic), unless damped | G-17; IW-PI-04: LT AN-88 (**UNVERIFIED**, text not retrieved) | SIM, REV (DRV-109) |
| PCB-P-16 [Q0] | The 5 A board fuse's voltage rating and breaking capacity cover the 2S pack's short-circuit current, and the pack PCM's short-circuit trip acts first; pack current from the pack makers (E1.10) | G-18; IW-BA-04 (fuse makers' guides, **UNVERIFIED**); ADR 0014 | REV (DRV-110) |
| PCB-P-17 [Q0] | The six battery contacts (P+ ×2, P− ×2, mid-cell tap, NTC; ADR 0020) are safe in any mating order, a tilted pack included: series resistance or clamping on the mid-tap and NTC lines per the BQ28Z610-R1 and BQ25798 TS datasheets (**UNVERIFIED** until read) | G-19; IW-BA-03 | schematic, REV (DRV-108) |
| PCB-P-18 [Q0] | Every rail enable, amplifier enable, external-source enable and boot strap has a resistor default that keeps it off (or safe) while its driver is unpowered or in reset: `HPA_RAIL_EN`, `HPA_LDO_EN`, OPA1622 EN, `HAT5V_EN`, `USB_SRC_ON`, `HAT3V3_EN`, FP_3V3, the oscillator ST pins (extends PCB-A-13) | G-20; IW-SC-02; BOM line 35 | schematic, REV (DRV-104) |
| PCB-P-19 [Q0] | No back-powering: a table of every net crossing between separately powered domains (faceplate, HAT, DAC VL, coprocessor, radio) with the sequencing or isolation that keeps it inside the receiver's absolute maximum | G-21; IW-SC-03 | schematic, REV (DRV-105) |

### 6.1 Battery interface and heat placement (PCB-L)

Family L keeps the method's meaning, placement for safety around the battery and heat; from v0.9 it also holds the battery contact interface of [ADR 0020](../adr/0020-battery-connected-through-contacts.md) (rows L-04 to L-10, proposed in its [research note](../research/2026-10-contact-battery-t1.md) §6). Contact order along the row, at 3.5 mm pitch: P+, P+, empty position, mid-cell tap, NTC, P−, P−.

| ID | Constraint | Source | Enforced by |
|---|---|---|---|
| PCB-L-01 [Q0] | No heat source (footprint field `Thermal` = `hot`) over the battery pocket: rule area `BATTERY_POCKET` = pocket footprint + 3 mm margin (**UNVERIFIED**, no cell-maker distance retrieved) | BRD-049; DFM §7 | DRC, REV (CHK-L-01) |
| PCB-L-02 [Q0] | Only battery nets (`PWR_BAT`: P+, P−; `BAT_SENSE`: mid-cell tap, NTC) and GND tracks and vias in the battery contact area (unfused copper), rule area `BATTERY_CONNECTOR` (geometry: PCB-L-05) | BRD-049; DFM §7 (partition rule, no external source); ADR 0020 | DRC |
| PCB-L-03 [Q2] | A device-level sustained power budget: the dissipation the body can shed at a surface-temperature target, against which E4.10's per-part data and V4-03 are checked. ≈ 0.19 W/K (est.; arithmetic: h ≈ 10 W/m²·K × 0.0189 m² body surface), so 3 W → ≈ 16 K mean rise; surface target from the IEC 62368-1 touch-temperature table (**UNVERIFIED** value) | G-33; IW-TH-01: Incropera (coefficient range **UNVERIFIED**) | REV, V4-03 |
| PCB-L-04 [Q0] | Battery contact row in the pocket-floor window at the pocket's bottom end: seven positions at 3.5 mm pitch, order P+, P+, empty, mid-cell tap, NTC, P−, P−; six KYOCERA AVX 70-9258-001-120-006 on 7.00 × 2.70 mm pads; the empty position carries no copper (rule area `BATTERY_CONTACT_EMPTY`) | ADR 0020 item 2; drawing 70-9258-001-1X0-00XS Rev F sheet 2 | DRC (no copper at the empty position), CHK (pad size, pitch, order), REV |
| PCB-L-05 [Q0] | Rule area `BATTERY_CONNECTOR` is the contact window plus 1 mm; inside it only pads, tracks and vias of the battery nets and GND (pads with no net allowed); zone exception to PCB-Z-01 for the contacts (free height 3.3 mm) | PCB-L-02; ADR 0020 item 2; drawing sheet 2 | DRC (pads here, tracks and vias with PCB-L-02), CHK (3D height) |
| PCB-L-06 [Q0] | Board top to pack pad 2.1 mm nominal (1.5 mm component zone + 0.4 mm floor + 0.2 mm pad recess), inside the contact's 1.6–2.8 mm working range over the tolerance stack (± 0.3 mm assumed, **UNVERIFIED** until the case tolerance stack; input to the case: floor standoff, floor thickness, pack recess); ≥ 1.0 mm from any contact and its travel to the metal floor's window edge, which carries an insulating liner (**UNVERIFIED** distance, research estimate) | ADR 0020 item 3; ADR 0016; drawing sheet 2 | REV (3D), case |
| PCB-L-07 [Q1] | Each pole's two contacts joined in a symmetric pour: equal copper length from each contact to the fuse (P+) or to the sense resistor (P−), so the sharing factor stays near the assumed 1.25 or below; ≥ 4 vias per contact pad to the pour (count **UNVERIFIED**, to replace by the IPC-2152 via calculation of PCB-P-09) | Generic method §3.1 ([contact-based battery interfaces](https://github.com/opendap-project/toolkit-hardware/blob/main/docs/research/2026-10-contact-battery-interfaces.md)); PCB-P-01; ADR 0020 item 3 | CHK (via count per pad, length symmetry), REV |
| PCB-L-08 [Q1] | One TPD1E10B06 on each of the mid-cell tap and NTC lines, within 3 mm of the contact (**UNVERIFIED**, as PCB-E-01), ground at the pad (PCB-E-04); a TVS position on P+ at the contacts (standoff ≥ 9 V, clamp < 20 V), DNP until CB-07 and CB-10. Footprint field `ESD` = `battery` on the two diodes; rule area `BATTERY_ESD` = the contact pads grown by 3 mm | ADR 0020 item 6; BOM line 142 | DRC (warning: diode outside `BATTERY_ESD`), schematic, REV |
| PCB-L-09 [Q0] | BATP: 100 Ω in series at the pin and 47 nF to GND (SLUSDV2C pin table, Figure 8-2 note 2); test points on the pack side of the fuse and on BAT for the insertion measurement (CB-07) | ADR 0020 item 6; SLUSDV2C; PCB-P-15; BOM line 115 | schematic, REV |
| PCB-L-10 [Q2] | Cover detect (should): one input with a pull-up and a TPD1E10B06, a contact pad at the board edge for the case's actuator; the GPIO is chosen in the pinout | ADR 0020 item 7; BOM line 143 | schematic, REV |

## 7. Audio partition and grounding

| ID | Constraint | Source | Enforced by |
|---|---|---|---|
| PCB-A-01 | One ground. No split planes; the analog section is partitioned by placement, and return currents of digital and switching circuits never cross it | CS43198: GNDA, GNDCP and GNDD meet in a common ground area under the chip (DS1156F2 Table 1-1, p. 7) | REV |
| PCB-A-02 | DAC exposed pad to ground through a via array to inner ground planes | CS43198 §8.4, p. 121 | REV |
| PCB-A-03 | REFA and REFB routed independently to each headphone connector's ground pin | CS43198 §8, p. 121 | NC (separate nets), REV |
| PCB-A-04 | FILT+ capacitor short to VA, FILT− to −VA; VCP_FILT± capacitors short to GNDCP | CS43198 §8, p. 121 | REV |
| PCB-A-05 | VA and VCP from independent clean supplies; VL and VD may share the logic supply | CS43198 §8, p. 121 | schematic, REV |
| PCB-A-06 | Distance from any switch node or inductor to the DAC analog pins, FILT±, the OPA1622 inputs and the headphone traces | ≥ 5 mm target, **UNVERIFIED** until the power and audio test board (E5.2) | DRC (courtyard area rule) |
| PCB-A-07 | No digital or switching trace on any layer under the analog section's area (DAC analog side, amplifiers, output network, jack traces) | Partition rule; ADR 0012 output stage | DRC (keep-out area) |
| PCB-A-08 | OPA1622 thermal pad to V−, per TI example layout DRC0010J | OPA1622 sheet (SBOS727B pp. 34–35) | REV |
| PCB-A-09 | Paralleled OPA1622 halves: symmetric layout of the two halves and their output resistors per leg | ADR 0012 (current sharing measured 53/47 % in `sim/output-stage`) | REV, SIM |
| PCB-A-10 | Left/right and leg symmetry of the headphone paths: equal length and topology | T1-050 (identical left/right), ADR 0012 | CHK |
| PCB-A-11 | Jack detect lines kept away from the audio paths and ESD-protected at the jack | BRD-052 | REV |
| PCB-A-12 | I2S/DSD test pads on the DAC side, stub ≤ 1 mm, passive (no series parts) | BRD-040, BRD-041 | REV |
| PCB-A-14 [Q1] | Each OPA1622's rail decoupling capacitors return to the output stage's power ground point, not to the difference-amplifier reference resistors' ground (BOM line 37) and not to the CS43198 REF nets | G-08; IW-GA-04 (Self); ADR 0015 (rail current a rectified sine, 433 mA peak) | REV (DRV-208) |
| PCB-A-15 [Q1] | Amplifier rail traces and headphone load-current paths do not run parallel to, or under, the difference-amplifier input and feedback traces; separation **UNVERIFIED** (set at the M-AUD layout, checked by V2 THD+N at full output) | G-09; IW-GA-05 (Self, induction distortion) | REV (DRV-208) |
| PCB-A-16 [Q1] | One reference point per single-ended output through the whole chain: the single-ended difference amplifiers' reference resistors return to the same 3.5 mm jack ground sense as REFA/REFB (PCB-A-03), or the schematic states why not | G-10; IW-GA-06; BOM lines 19, 37 | schematic, REV (DRV-114) |
| PCB-A-17 [Q2] | Copper resistance of any return shared by both channels between the reference point and the 3.5 mm sleeve pin ≤ 5 mΩ, **UNVERIFIED** target (arithmetic: 5 mΩ / 16 Ω → −70 dB crosstalk from the board alone), to align with a T1-048 crosstalk threshold | G-11; IW-GA-06 (Self, chapter **UNVERIFIED**) | CHK (copper resistance), REV (DRV-313) |
| PCB-A-18 [Q2] | The ground current between USB-C and the headphone jacks (USB DAC mode to a computer, T1-054) runs in a defined path along the bottom edge, outside the DAC and amplifier reference region; the USB-C shield termination is decided in the schematic | G-12; IW-GA-07 (Putzeys, Ott); V4-06 | REV (DRV-214) |
| PCB-A-19 [Q2] | RF filter footprints at each headphone output near the jack: a series element (ferrite or 0 Ω) and a shunt capacitor to the jack ground, DNP by default; the OPA1622 with its 1 Ω ballast checked stable with the shunt fitted. Values **UNVERIFIED** (simulation for stability, V4-01 with the radio transmitting) | G-13; IW-GA-08: TI SBOA128; IW-ES-04 | REV (DRV-116), SIM |

## 8. RF, protection, test and assembly

| ID | Constraint | Source | Enforced by |
|---|---|---|---|
| PCB-R-01 | Radio module land, ground and keep-out per Murata's Type 2EL hardware application note E2B-09-1413 Rev. 9.0 and footprint drawing; the datasheet (supply ranges, sequencing, keep-out under the module) is still **UNVERIFIED** (Murata's link refused) | BRD-025; LBES5PL2EL-923 sheet | DRC (keep-out from the footprint), REV |
| PCB-R-02 | Both antenna paths as Murata's copy: ANT0 (pin 15) and ANT1 (pin 23), each with a U.FL in the top band near the top wall and 0603 matching positions, the 10 pF link from pin 18 to pin 23 (shared configuration, fitted) and the dedicated-configuration positions (DNP), so either configuration needs no respin | E2B-09-1413 §3.5.1; [ADR 0018](../adr/0018-antennas-and-certification-route.md) items 2, 4 | REV |
| PCB-R-03 [Q1] | RF trace: a copy of Murata's U.FL layout. 50 Ω microstrip over a solid ground 230–240 µm below it (inner-plane cut-outs in the HDI stack, never over a change of dielectric or ground), width within ±0.25 mm of Murata's, 7–25 mm long; ≥ 0.8 mm copper keep-out under the U.FL. Stackup v1: 235 µm (L1→L3, L10→L8), width 391 µm (Murata's rule W = 1.8 × H gives 423 µm, within ±0.25 mm); rule area `RF_CUTOUT` marks the L2 (L9) void and the L3 (L8) pour | E2B-09-1413 §3.5.1 p. 15; CER-0248 §2.1.6.2 pp. 31–33 | DRC (rule area `RF_CUTOUT`: no copper in the L2/L9 cut-out, only GND on the L3/L8 pour; keep-out area), REV |
| PCB-R-04 [Q2] | Antenna: Molex 146153-0050 (on Murata's FCC, ISED and Japan lists), shared by Wi-Fi and Bluetooth; prototypes may use any available antenna that fits (RFC 0011 §4); each regional variant uses its market's route (US Class II and Canada Class 4 permissive changes with SAR, EU self-declaration with EN 50566 SAR, Japan covered) | [ADR 0018](../adr/0018-antennas-and-certification-route.md); CER-0248 Tables 20, 36, 56 | REV |
| PCB-R-05 [Q2] | Antenna feeds and radiators at the board edges or in the top band, away from the body-facing surface and from HAT metal; the distance is fixed by the SAR pre-assessment | [design for compliance](https://github.com/opendap-project/t1/blob/main/docs/research/2026-10-design-for-compliance.md) §2.3 | REV |
| PCB-R-06 [Q2] | Antennas, U.FL feeds and RF traces kept away from the USB 3, PCIe and HAT extension routes, the DF40 connector and the HAT FPC; the FPC's fast pairs have ground on both sides of the flex. Distance **UNVERIFIED** (from the M-RF and M-HAT modules, V3-05, V3-07 with the radio on) | G-22; IW-RF-02: Intel USB 3 white paper | DRC (keep-out), REV (DRV-216) |
| PCB-R-07 [Q2] | Input to the case: the antenna on the inside of the top wall (≈ 56.3 × 14.2 mm area), its radiating element ≥ 5 mm from any metal (battery, metal pocket floor, microSD shell, screw inserts, display frame, HAT metal), the zone uncoated; 5 mm is **UNVERIFIED** until the prototype's measurement | [ADR 0018](../adr/0018-antennas-and-certification-route.md) items 4, 5; G-23 | case interface (E4.6), V5-01 |
| PCB-R-08 [Q1] | Every radiator, antenna feed and tuning part lives in the main body (board and case core), never in the faceplate; the faceplate interface carries no RF. Antenna zones in order of preference: the core's top wall and upper side walls, the board's top edge; the back cover only as a flagged last resort (HAT cases replace it and HAT metal detunes it) | BRD-061; [metal-case antennas](../research/2026-10-metal-case-antennas.md) §2 | REV |
| PCB-R-09 [Q1] | Case-antenna feed option on ANT0: after Murata's copied line (PCB-R-03, unchanged), one series position on a pad shared by the U.FL direction and the case-antenna branch, so the unfitted direction is an open at the pad, not a trace stub; whether Murata accepts the shared junction for the Class I documentation is **UNVERIFIED** | BRD-061, BRD-053; [metal-case antennas](../research/2026-10-metal-case-antennas.md) §4 items 1, 6 | REV |
| PCB-R-10 [Q1] | Case-antenna branch: 50 Ω line from the junction to an ENIG spring-contact feed pad at the board's top edge near the top wall, with a series DC-block position, a pi matching network of three 0603 positions, a shunt-inductor position to ground at the pad (ESD DC path and tuning) and a low-capacitance ESD diode position (≤ 0.2 pF at 2.5–6 GHz, IEC 61000-4-2 ±8 kV contact or better; for example Infineon ESD904-B1-W0201, 0.1 pF); values set on the metal-core prototype (**UNVERIFIED**) | BRD-061, BRD-007, PCB-E-01; [metal-case antennas](../research/2026-10-metal-case-antennas.md) §4 items 2, 3 | REV, CHK (ESD position at the pad) |
| PCB-R-11 [Q1] | Case-ground contact pads (ENIG, spring contacts) at both top corners and on the left and right board edges in the top band, plus the four mounting bosses on GND (PCB-H-03); each pad to the ground plane through its own vias at the pad (≥ 2, count **UNVERIFIED**), its ESD current returned locally and never through the audio reference region (PCB-E-04, PCB-E-05) | BRD-061, BRD-007; [metal-case antennas](../research/2026-10-metal-case-antennas.md) §4 item 4 | REV (DRV-316) |
| PCB-R-12 [Q1] | Antenna-path assembly variants (BRD-053): every position of PCB-R-09 to R-11 carries its variant: *polymer* (U.FL and 146153 fitted, branch DNP), *metal with end cap* (as polymer, matching retuned), *metal frame* (branch fitted, U.FL DNP); the variant data names the fitted path so Blackbird OS loads its calibration and the variant's SAR-capped TX-power table | BRD-053, BRD-061; [ADR 0018](../adr/0018-antennas-and-certification-route.md) item 6; [metal-case antennas](../research/2026-10-metal-case-antennas.md) §4 items 6, 7 | CHK (BOM variant fields) |
| PCB-R-13 [Q2] | No metal part (microSD shell, shield frame, screw insert) between the feed and ground contact pads and the top wall, and the ≥ 5 mm provisional keep-out of PCB-R-07 applied to a case antenna's radiating part; 5 mm is **UNVERIFIED** until the metal-core prototype is measured | BRD-061; [ADR 0018](../adr/0018-antennas-and-certification-route.md) item 5; [metal-case antennas](../research/2026-10-metal-case-antennas.md) §4 item 5 | REV, V5-01 |
| PCB-EMC-01 [Q1] | Common-mode filter positions (0 Ω fitted by default) on the USB-C USB 2 pair, the faceplate DSI and the HAT high-speed entry, placed per each class's signal-integrity rules | [design for compliance](https://github.com/opendap-project/t1/blob/main/docs/research/2026-10-design-for-compliance.md) §2.1; BRD-053 | REV |
| PCB-EMC-02 [Q1] | Ferrite positions on HAT_5V, HAT_3V3 and the faceplate supplies at their connectors | [design for compliance](https://github.com/opendap-project/t1/blob/main/docs/research/2026-10-design-for-compliance.md) §2.1 | REV |
| PCB-EMC-03 [Q1] | Shield-can frame footprints (DNP first) around the switching converters near the radio and around the headphone stage, besides PCB-T-06 | [design for compliance](https://github.com/opendap-project/t1/blob/main/docs/research/2026-10-design-for-compliance.md) §2.1 | REV |
| PCB-E-01 | ESD protection at every external connector (USB-C, jacks, HAT DF40, faceplate FH35C, microSD), placed between the connector and everything else, ≤ 3 mm from the connector pins **UNVERIFIED** | BRD-007; BOM ESD lines | CHK (distance), REV |
| PCB-E-02 | USB-C VBUS: TVS2200 at the connector, TPS2121 next | Power tree (VBUS surge note) | REV |
| PCB-E-03 | Each HAT rail behind its eFuse | BRD-026 | schematic |
| PCB-E-04 [Q1] | Each connector shell and each ESD diode (TVS) ground pad reaches the ground plane through its own vias directly at the pad, at least two (count **UNVERIFIED** for the TVS); no stub on the protected line; no ESD return shares a path with an audio ground return. Merges gap G-25 | [design for compliance](https://github.com/opendap-project/t1/blob/main/docs/research/2026-10-design-for-compliance.md) §2.10; G-25, IW-ES-01: TI SLVA680A | REV (DRV-316) |
| PCB-E-05 [Q2] | An ESD return region at the bottom edge: each TVS at USB-C and the jacks grounds into a locally stitched ground at the connector; no analog reference sense (REFA/REFB, gain-network references) and no clock in that region. Size **UNVERIFIED** (set at placement, checked by V4-05) | G-24; IW-ES-02 (Ott); IEC 61000-4-2 (about 30 A first peak at 8 kV contact, **UNVERIFIED** text) | DRC (keep-out area), REV (DRV-213) |
| PCB-P-11 [Q3] | HAT_5V, HAT_3V3 and the USB-C source output each have a second, independent limiter (fuse or PTC) so the available power after 3 s stays ≤ 15 W with the eFuse shorted (IEC 62368-1 PS1) | [design for compliance](https://github.com/opendap-project/t1/blob/main/docs/research/2026-10-design-for-compliance.md) §2.4 | schematic, V4-12 |
| PCB-A-13 [Q1] | Amplifier enables and the DAC reset default to off at power-up and reset (hardware pull), so no output is driven before the OS sets a level (T1-049, T1-072) | [design for compliance](https://github.com/opendap-project/t1/blob/main/docs/research/2026-10-design-for-compliance.md) §2.6 | schematic, REV |
| PCB-S-09 [Q3] | Laminate and solder mask flammability V-0, with recognition evidence from the fab | IEC 62368-1 clause 6; [design for compliance](https://github.com/opendap-project/t1/blob/main/docs/research/2026-10-design-for-compliance.md) | fab notes |
| PCB-T-07 [Q2] | Every BOM line carries its RoHS and REACH status and a supplier declaration reference (T1-082) | [design for compliance](https://github.com/opendap-project/t1/blob/main/docs/research/2026-10-design-for-compliance.md) §2.7 | CHK (BOM fields) |
| PCB-T-01 | UART test pads for BootROM / TPL / SPL | BRD-047 | REV |
| PCB-T-02 | A test pad on every regulated rail and on VSYS, VSYS_LV, VBAT | Bring-up (E8.2) | CHK (one pad per power net) |
| PCB-T-03 | SWD pads for the RP2354A | BRD-015 | REV |
| PCB-T-04 | Assembly variants: every optional part has its variant field, DNP parts keep their footprint | BRD-053, ADR 0013 | CHK (BOM fields) |
| PCB-T-05 | Every part has Manufacturer and MPN fields | `fab-package` check | CHK |
| PCB-T-06 | Shielding-can frames (DNP first) around the SoC/DDR and the radio, with a 0.5 mm frame keep-out **UNVERIFIED** | BOM line 90, §7.7 | DRC (keep-out), REV |
| PCB-T-08 [Q1] | A rail isolation link at every converter and LDO output (0201 or 0402 0 Ω, or a solder jumper), fitted on prototypes, so each rail can be brought up alone; one per regulated rail in the power tree | G-26; IW-BU-01 (Ganssle) | CHK (one link per rail), REV (DRV-119) |
| PCB-T-09 [Q1] | Test points on SoC reset, PMIC power-on, sleep and interrupt, the MaskROM window (`WINDOW_N`), boot-mode nets, the coprocessor's RUN and BOOTSEL (QSPI_SS); one spare SoC GPIO and one spare RP2354A GPIO on pads | G-27; IW-BU-02, IW-BU-04 (Ganssle) | CHK, REV (DRV-119) |
| PCB-T-10 [Q1] | Scope ground points next to each converter cluster, the audio section and the clocks, sized for a probe ground spring (pad size **UNVERIFIED**) | G-28; IW-BU-03, IW-PI-05 (AN-47) | REV (DRV-220) |
| PCB-T-11 [Q1] | Board revision in copper on an inner or outer layer, besides the EEPROM (BOM line 17) | G-29; IW-PD-05 | REV (DRV-403) |
| PCB-T-12 [Q1] | Rework keep-out around the RK3566, LPDDR4X and eMMC (distance in PCB-D-01); the decoupling under them on the opposite side (ADR 0016) recorded as an accepted rework cost | G-30; IW-DF-06: IPC-7095 (**UNVERIFIED** value) | DRC (PCB-D-01), REV (DRV-218) |

### 8.1 Assembly (PCB-D)

Objects are found by naming conventions (fiducials `FID*`, test points `TP*`, field `Rework` = `BGA`), listed in the [rules README](../../hardware/rules/README.md); CHK-D-08 checks they are followed.

| ID | Constraint | Min | Target | Max | Source | Enforced by |
|---|---|---|---|---|---|---|
| PCB-D-01 [Q1] | Rework clearance around a BGA (`Rework` = `BGA`), courtyard to courtyard | 2 mm | 2 mm | — | **UNVERIFIED** (IPC-7095 and nozzle data not retrieved) | DRC, CHK (CHK-D-04, tall parts) |
| PCB-D-02 [Q1] | Fiducial size, round | 1.0 mm | 1.0 mm | 3.0 mm | LCSC fiducial guide [LC] (secondary) | DRC |
| PCB-D-03 [Q1] | Fiducial clear area: nothing within 1.0 mm of the dot | 1.0 mm | 1.0 mm (3 mm window) | — | [LC] | DRC |
| PCB-D-04 [Q2] | Fiducial to board edge | 3.85 mm | 3.85 mm | — | [LC]; not binding on panelised builds | DRC |
| PCB-D-05 [Q2] | Silkscreen to board edge | 0.3 mm | 0.3 mm | — | **UNVERIFIED** (no fab publishes one); the craft standard's 0.5 mm (CRAFT-08, Q2) is a CHK item | DRC |
| PCB-D-06 [Q2] | Test pad size | 1.0 mm | 1.0–1.27 mm | — | JLCPCB DFT guide [JD] (secondary) | DRC |
| PCB-D-07 [Q2] | Test pad spacing (2.54 mm pitch, 1.0 mm pads, edge to edge, arithmetic) | 1.54 mm | 1.54 mm | — | [JD] | DRC |
| PCB-D-08 [Q2] | Test pad to other parts' pads | 1.0 mm | 1.0 mm | — | [JD]; to bodies: CHK-D-05 | DRC |
| PCB-D-09 [Q2] | Test pad to board edge | 3.8 mm | 3.8 mm | — | [JD] | DRC |
| PCB-D-10 [Q1] | Open via hole to an SMD pad; a filled and capped via (IPC-4761 type VII) may sit in the pad | 0.2 mm | 0.2 mm | — | PCBWay [P11, P16] (process); distance **UNVERIFIED** | DRC |

## 9. Open items

1. **Front-side height (PCB-Z-03):** decided by [ADR 0016](../adr/0016-front-side-height-under-the-display.md). Still open from its study: package heights of the RK3566, LPDDR4X and eMMC; the back bands at 104–123 % of their area with today's tall parts (4020 inductors, haptic motor, microSD socket); the microSD socket fits neither the top band nor the zone under the battery. Both go to placement (E7.1).
2. **Rockchip documents** retrieved (E1.11 part 1). Still missing: the RK3566 edition of the high-speed guide, RK3566 DDR templates, package pin lengths, a land pattern (Rockchip publishes none: the footprint is drawn from the package drawing and checked by a second reading) and IBIS models. LPDDR4X needs 1.10 V (VDD2) besides 0.60 V (VDDQ) at the SoC: check against the power tree.
3. **Murata Type 2EL:** application note, footprint and certification note retrieved ([interface standards](../research/2026-10-interface-standards-layout.md)); the datasheet is still missing. Findings for the power tree and the product: the module needs a 1.8 V power rail (AVDD18, 323–390 mA typical in Bluetooth/802.15.4 transmit, peaks above 1 A on the carrier datasheet) besides 3.3 V; the US and Canada modular approvals cover mobile use at ≥ 20 cm only, so the handheld T1 needs SAR and a permissive change through Murata; the Molex 146187 antenna is on Japan's list only (with a ≥ 50 mm cable). Plan tasks E1.12, E1.13.
4. **Standards** ([interface standards](../research/2026-10-interface-standards-layout.md)): USB 2.0 and USB 3.2 texts retrieved (USB 2.0 allows ±15 %, the board keeps PCBWay's ±10 %; USB 3 AC caps 75–265 nF); PCIe and MIPI from vendor guides only (member-only specs); the eMMC 5.1 text and SD SDR104 timing are still missing.
5. **Case inputs**: walls, bosses, clearances (PCB-M-02, PCB-M-08) through the t1 interface files (E4.6).
6. **PCBWay**: HDI stackup, microvia land, shielding frames, fiducial practice (E3.6).
7. **DFM values** ([DFM and reliability rules](../research/2026-10-pcb-dfm-reliability-rules.md) §8): the screw, washer and hole (PCB-H-01 to H-06), copper and parts at break tabs and edges (PCB-B-01, B-02), BGA rework clearance (PCB-D-01, T-12), the open-via distance (PCB-D-10), silk to edge (PCB-D-05), the battery pocket margin (PCB-L-01). The research note's CHK and REV items carry what DRC cannot check (thermal spokes and uncoupled length wait for kicad-lib's `check_drc.py` to read KiCad's unnamed messages).
8. **Industry-wisdom values:** stitching fence pitch (PCB-S-13), rail-to-input separation (PCB-A-15), shared-return resistance (PCB-A-17), headphone RF filter values (PCB-A-19), TPS65131 power-save pin and the AUDIO_N7V0 minimum load (PCB-P-13), mating-order clamping (PCB-P-17), antenna distances (PCB-R-06, R-07, R-13) and the case-antenna matching values (PCB-R-10), the ESD region (PCB-E-05) and TVS via count (PCB-E-04), probe pad size (PCB-T-10), the touch-temperature target (PCB-L-03).
9. **MCLK** (PCB-I-09): the 20 mm branch limit holds with a typical CMOS oscillator drive; with the weakest drive NDK's catalogue allows, no passive values pass ([`sim/mclk-attenuator`](../../sim/mclk-attenuator/README.md)). The NSC5083D output drive and symmetry from NDK, or a measurement on the first boards, close it.
10. **Battery contacts (v0.9, ADR 0020):** KYOCERA AVX product specification 201-01-252 (contact force, resistance, current-rating basis) before the board freezes; the case tolerance stack that holds 2.1 ± 0.3 mm (PCB-L-06) and the liner distance; the via count per contact pad (PCB-L-07); the ESD distance (PCB-L-08, with PCB-E-01); whether the P+ TVS is fitted (CB-07, CB-10); the cover-detect GPIO (PCB-L-10, pinout).
11. **HAT extension (v0.10, hat-standard ADR 0005):** the TMUXHS4412 figures are typical only (SLASEW5A gives no minimum or maximum for insertion loss, return loss, crosstalk or skew); the package-to-package skew, the switch's port isolation while PD is high (needed for the interface's "disconnected until the identity record is read"), D-PHY low-power signalling through the switch, and the 85 Ω to 100 Ω step on the PCIe side are measured on the hat-standard coupon, which also carries the DF40, the flat cable and the pogo field. The channel's loss budget end to end (SoC to HAT) is not set yet.
12. **Stackup v1 (v0.11), its debt by level** ([stackup v1](stackup-v1.md) §6, §8): PCBWay confirms the stack, pressed thicknesses, Dk at frequency, the 25 µm on L2/L9, the 0.125 mm second laser level and the thickness tolerance at 1.07–1.10 mm (Q0, DFM review HW1.4); coupons for every impedance class, measured (Q1, E5.1); the USB 3 and PCIe loss budget at these widths (Q1, E4.5; it decides PCB-S-06); resin fill and Dk over the RF cut-out, cross-section (Q2, E5.1); the U.FL keep-out depth and trace width from Murata's layout file (Q1, PCB-R-03). Until the DFM review every width and gap rule is a DRC warning. In DRC: the maximum pair gap and KiCad's `diff_pair_gap` wait for kicad-lib's `check_drc.py` to read KiCad's unnamed messages (the minimum is checked as a clearance); the fab rule set's inner track minimum is 3 mil = 0.0762 mm while PCBWay publishes 0.075 mm, so the product rules set 0.075 mm for the impedance classes (inner 100 Ω is 75.0 µm). PCB-S-14 allows no `MCLK_50SE` track on L1/L10, so the oscillator and XTI pads reach L3/L8 through a via in the pad (PCB-D-10) unless the escape study (E4) shows another way.
