OpenDAP-org/board/docs/adr/0002-hat-signals-leave-the-board-over-a-flat-cable.md

# ADR 0002: HAT signals leave the board over a flat cable

- **Status:** Accepted
- **Date:** 2026-10-21

## Context

The HAT interface sits on a separate device-side piece defined by the HAT Case Standard.

## Decision

Everything the HAT interface needs leaves the board over a flat cable to that device-side piece.
