OpenDAP-org/board/docs/adr/0005-battery-approach.md

# ADR 0005: Battery approach

- **Status:** Superseded by [ADR 0007](0007-off-the-shelf-battery.md)
- **Date:** 2026-10-22
- **Decided by:** Claude, under the maintainers' delegation, following the product rules

## Context

The battery must be a standard commercial part of at least 2,000 mAh (T1 requirements), as large as fits (T1-035), certified and user-replaceable, and available (T1-028, T1-029). No stocked pack that fits has both IEC 62133-2 and UN 38.3 reports. Research: [battery selection](../research/2026-10-battery-selection.md).

## Decision

- The board and case are designed around a **105060-class battery bay** (about 3,000–3,500 mAh), with a connector and an NTC on the board.
- **Commercial edition:** a certified 105060 pack (IEC 62133-2, UN 38.3, PCM, NTC, connector), quoted from at least two of Jauch, EEMB and Grepow; it is validated when quoted.
- **Prototypes and DIY kit:** Adafruit 328 (2,500 mAh) first, Adafruit 2011 (2,000 mAh) as second source; they fit the same bay.
