OpenDAP-org/board/docs/research/2026-10-metal-case-antennas.md

# Antennas in an anodised-aluminium T1 (2026-10)

- **Date:** 2026-10-24
- **Requirement:** BRD-061 (should, confirmed by the maintainers on 2026-10-24). Recorded against [ADR 0018](../adr/0018-antennas-and-certification-route.md) in its note of 2026-10-24.
- **Question:** which antenna strategies keep Wi-Fi 2.4 / 5 GHz and Bluetooth working when the case core is anodised aluminium (case requirement CASE-022, a later material option), what each strategy needs from the board, and what each one means for certification under the regional-variant strategy of [RFC 0011](https://github.com/opendap-project/rfcs/blob/main/text/0011-feature-blocks-and-variants.md) §4.
- **Maintainers' constraints (2026-10-24):**
  1. Every radiator, feed and tuning part lives in the main body (board and case core), **never in the faceplate**: the faceplate is a separate, interchangeable module, and any faceplate must work with any radio configuration.
  2. The preferred antenna zone is the core's frame (top wall or side walls) and the board's own edge. The **back cover is a last resort**: HATs mount on the back and a HAT case replaces the basic back cover (CASE-006), so a HAT, possibly metal, would cover or detune an antenna there. HATs keep the antenna keep-out.
- **Inputs:** [ADR 0018](../adr/0018-antennas-and-certification-route.md) and its study [antennas and RF exposure](2026-10-antennas-and-rf-exposure.md) (cited "AR §n"); [LBES5PL2EL-923](https://github.com/opendap-project/parts-lib/blob/main/Murata/LBES5PL2EL-923.md) with Murata CER-0248 Rev. 6.0 and E2B-09-1413 Rev. 9.0 (hashes in `parts-lib/manifest.toml`; both re-read for this note); [PCB design constraints](../specs/pcb-design-constraints.md) PCB-R-01 to R-07; case requirements CASE-006, CASE-020 to CASE-022, CASE-025, CASE-028 and case ADR 0001 (core, basic back cover, HAT case), read only.
- **Scope:** the electronics only. The case geometry (where cuts, caps or contact spots go, wall thickness) belongs to the case repository; this note states what the board must hold and what the case would have to provide (§7).
- **Conventions:** **UNVERIFIED** means no primary source was read in this session. "(vendor claim)" means the only source is the maker's own text. "Arithmetic" marks a value computed here.

## 0. Summary

1. **A closed aluminium core silences the antenna of ADR 0018.** The Molex 146153-0050 sits on the inside of the top wall; a metal top wall puts a conductor between it and the user. Anodising does not help: the anodic layer is an insulating oxide of 2–25 µm on a metal whose skin depth at 2.45 GHz is about 1.7 µm (§1).
2. **Two strategies fit the T1 and the maintainers' constraints:**
   - **S1, non-metallic top end cap.** The top wall (and a strip of the sides and back around it) is polymer, glass or ceramic, the rest of the core aluminium. The 146153-0050 and the board stay as they are; only the matching is retuned. Same listed antenna, same regional routes as ADR 0018. This is the lowest-risk path and the **preferred** one.
   - **S2, the frame is the antenna.** A split band or a dielectric-filled slot in the top wall or the upper side walls, fed from the board through a spring contact and grounded at defined points. The case becomes the antenna; the board feeds it through a second branch with its own matching and ESD positions. A new antenna type for Murata's certification: a permissive change in every region (§5).
3. **Excluded:** antenna in the faceplate (maintainers' constraint 1); antenna in or behind the back cover except as a flagged last resort (constraint 2); external or on-metal antennas mounted outside the body (not on Murata's lists, and against a closed handheld body); Murata's trace antenna (20 mm clearance, AR §1.2).
4. **What the board now holds (PCB-R-08 to PCB-R-13):** the main-body rule; a case-antenna feed pad on the ANT0 path selected against the U.FL by assembly variant, without a stub; a pi matching network, a DC-block, a shunt-inductor position and a ≤ 0.2 pF ESD position at that pad; case-ground contact pads at the top corners and upper side edges with their own ESD return; the variant field that ties the fitted antenna path to its calibration and TX-power table. The polymer production variant leaves all of it unpopulated.
5. **Certification:** S1 keeps ADR 0018's routes (listed antenna, Class I documentation of the retuned match). S2 is a new antenna type: FCC Class II permissive change through Murata, ISED permissive change through Murata (class **UNVERIFIED**), Japan only if Murata adds the antenna to certification 001-P02018, EU radiated tests and SAR on the metal variant. Each metal-case regional variant is verified and certified on its own (RFC 0011 rule 9).
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
