OpenDAP-org/board/docs/research/2026-10-master-clock-options.md

# Master clock options: duty cycle, load and phase noise

- **Date:** 2026-10-24
- **Task:** E1.14 of the [electronics plan](https://github.com/opendap-project/t1/blob/main/docs/plans/2026-10-electronics-plan.md)
- **Outcome:** [ADR 0019](../adr/0019-master-clock-divided-from-twice-the-frequency.md) (amends [ADR 0010](../adr/0010-audio-master-clock-source.md))
- **Simulation:** [`sim/mclk-divider/`](../../sim/mclk-divider/README.md), 20 checks, all pass

## 1. The problem
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
