OpenDAP-org/board/hardware/studies/bga-escape/plots/8l-L1.png

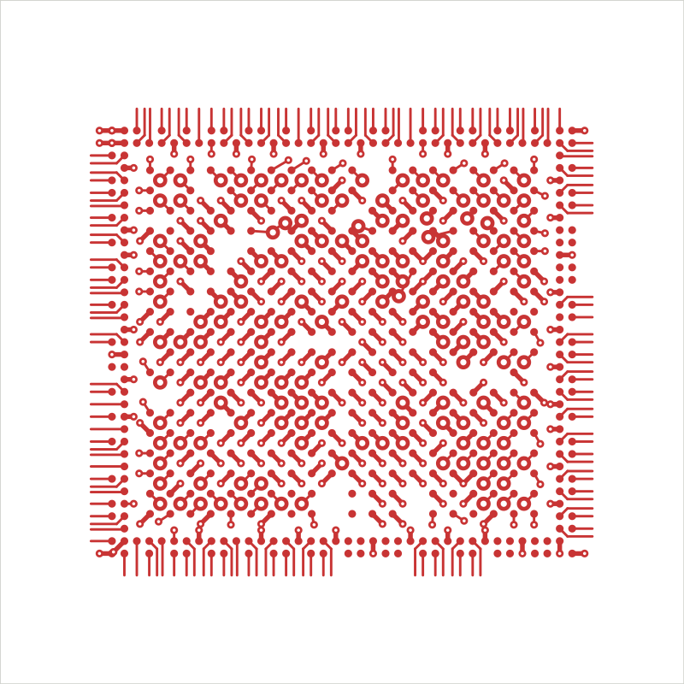
hardware/studies/bga-escape/plots/8l-L1.png
