OpenDAP-org/board/hardware/studies/bga-escape/plots/8l-L2-gnd.png

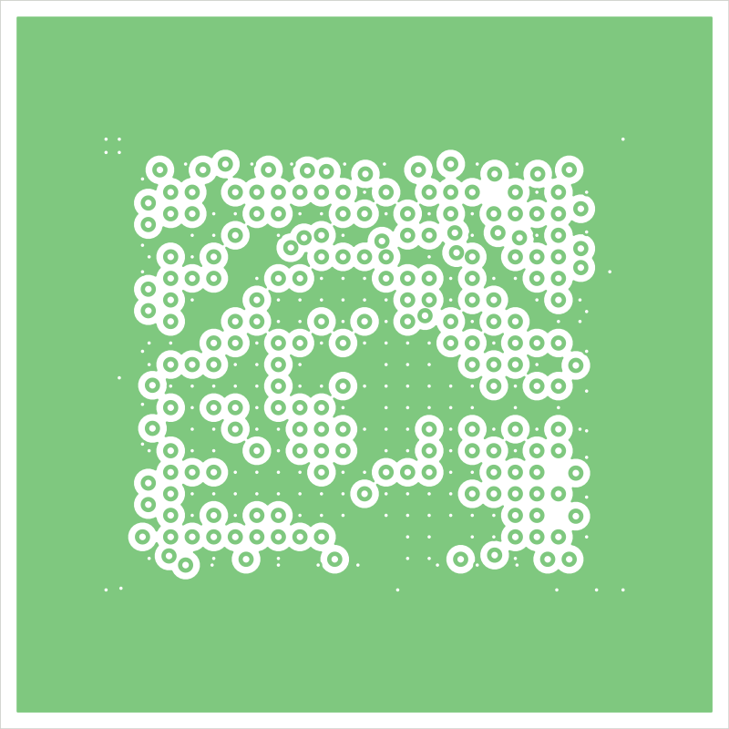
hardware/studies/bga-escape/plots/8l-L2-gnd.png
