OpenDAP-org/board/hardware/studies/bga-escape/plots/8l-L3.png

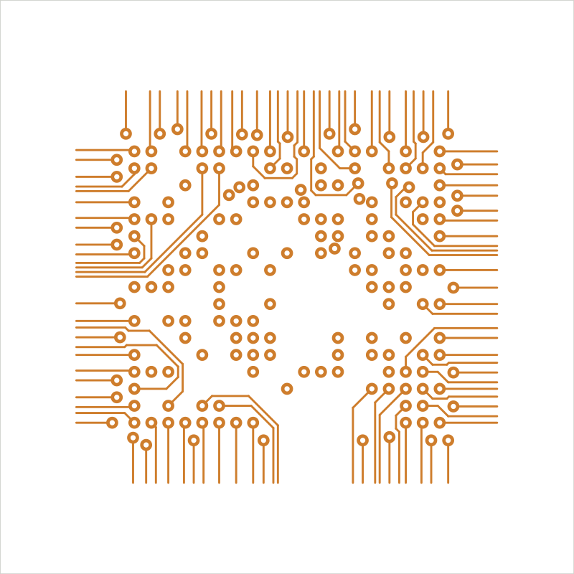
hardware/studies/bga-escape/plots/8l-L3.png
