OpenDAP-org/board/hardware/studies/bga-escape/plots/8l-L4.png

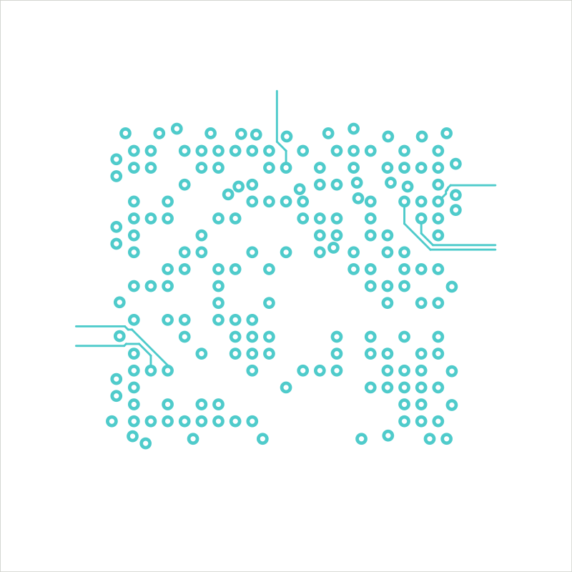
hardware/studies/bga-escape/plots/8l-L4.png
