OpenDAP-org/board/hardware/studies/bga-escape/plots/8l-L5-pwr.png

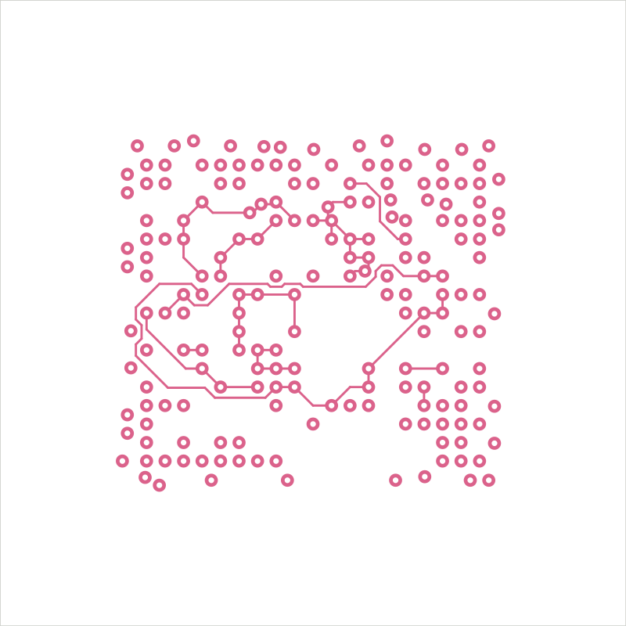
hardware/studies/bga-escape/plots/8l-L5-pwr.png
