OpenDAP-org/board/docs/specs/bom-v1.md

# BOM v1

- **Status:** BOM v1.11, cross-validated draft. v1.11 applies hat-standard [HAT interface v1.1](https://github.com/opendap-project/hat-standard/blob/main/docs/specs/interface-v1.md) and its [ADR 0005](https://github.com/opendap-project/hat-standard/blob/main/docs/adr/0005-interface-v1-1-shared-extension-and-contact-reduction.md) (one DF40C-100 per cable end, 68 pogo contacts, a PCIe/CSI-2 extension through two TMUXHS4412, line out removed, the HAT limiters checked against the new fault ceilings) and the board changes of the t1 [faceplate interface v1](https://github.com/opendap-project/t1/blob/main/docs/specs/faceplate-interface.md) §10 (current-limited faceplate rails, a backlight driver that keeps BL_LEDA below 30 V, I2C3 pull-ups for 400 kHz): [Changes in v1.11](#changes-in-v111). v1.10 applies [ADR 0020](../adr/0020-battery-connected-through-contacts.md) (battery connected through six spring contacts instead of the Micro-Fit 3.0 and the pack lead) and its [contact battery research](../research/2026-10-contact-battery-t1.md): [Changes in v1.10](#changes-in-v110). v1.9 applies [ADR 0019](../adr/0019-master-clock-divided-from-twice-the-frequency.md) (master clock divided from twice the frequency), the BOM and power-tree items B1–B16 of [pinout v1](pinout-v1.md) §9.2, and three decisions taken under the maintainers' delegation on 2026-10-24 (the radio can stay powered in suspend for item tracking, the faceplate supply is off in suspend by default, the 802.15.4 balls stay unassigned spares); the vcc3v3_sys re-sum passes 80 %, so line 6 becomes the TPS62827: [Changes in v1.9](#changes-in-v19). v1.8 adds the radio's 1.8 V power rail and moves the LPDDR4X VDD1 supply and the VDDQ LDO bias onto an always-on rail (electronics plan E1.12), applies the feature-block gaps G1–G21 (E1.15) and folds in [ADR 0017](../adr/0017-fuel-gauge-wiring-sense-resistor-and-configuration.md) (fuel-gauge wiring, 3 mΩ sense resistor) and [ADR 0018](../adr/0018-antennas-and-certification-route.md) (one Molex 146153-0050 antenna, shared configuration): [Changes in v1.8](#changes-in-v18). v1.7 adds the should parts of BRD-057 to BRD-059 (NFC, haptics, a hardware key holder). v1.6: v1.6 applies [ADR 0015](../adr/0015-amplifier-rails-from-vsys.md) (amplifier rails sized for the full-scale peak: LMR33630C −7 V inverting buck-boost from VSYS, TPS65131 boost only, paired LT3045/LT3094), ADR 0014 item 6 (BQ25798 ship FET), the MaskROM fix and two value corrections of the [boost and MaskROM simulation](../research/2026-10-boost-and-maskrom-simulation.md): [Changes in v1.6](#changes-in-v16). v1.5 applies [ADR 0014](../adr/0014-two-cell-battery.md) (Accepted: two-cell battery with a quoted pack; BQ25798 charger, TPS62136 pre-regulator to a 3.8 V VSYS_LV rail, two TPS62903 bucks, BQ28Z610-R1 gauge, 5 A fuse, Micro-Fit 3.0 battery connector) and fixes the board EEPROM address: [Changes in v1.5](#changes-in-v15). v1.4 applies the hat-standard [HAT interface v1](https://github.com/opendap-project/hat-standard/blob/main/docs/specs/interface-v1.md) (Draft; hat-standard ADR 0002 and ADR 0003: low-speed I/O over USB, one HAT USB port, compatibility levels L1–L3, the T1 at L3) to the HAT lines: [Changes in v1.4](#changes-in-v14). v1.3 applies [ADR 0012](../adr/0012-headphone-output-stage.md) (headphone output stage: six OPA1622, ±6 V rails on LT3045/LT3094, CS43198 at `+1dB_EN` = 0 with amplifier gain 1.62) and closes §9 items D27 and D30: [Changes in v1.3](#changes-in-v13). v1.2 applies the maintainers' decisions of 2026-10-22 (power safety first, BRD-049; battery path for the full output budget, BRD-050; RGB status LED, FPT-025; HAT interface by function, HCS-021, HCS-022): [Changes in v1.2](#changes-in-v12). v1.1 closes the datasheet-review items of §9 that a part, value or circuit change can close ([Changes in v1.1](#changes-in-v11)); the rest stay *Open* with their blocker. v1 supersedes the [BOM v1 draft](bom-v1-draft.md) after the [cross-validation](../research/2026-10-bom-v1-cross-validation.md). Only lines marked *Decided* are decisions (ADRs). Every *Proposed* line still needs the maintainers' confirmation; *Open* lines have no compliant pick yet; **Blocker** marks a line that cannot meet the product rules today.
- **Date:** 2026-10-24 (v1.11, v1.10, v1.9 and v1.8; v1.7 2026-10-23; v1.6 2026-10-22)
- **Updated 2026-10-24:** stale text aligned with the most recent Accepted ADRs ([ADR 0014](../adr/0014-two-cell-battery.md), [ADR 0015](../adr/0015-amplifier-rails-from-vsys.md), hat-standard [ADR 0004](https://github.com/opendap-project/hat-standard/blob/main/docs/adr/0004-pogo-part-and-field-geometry.md)): line 39 and §3 (BQ25798 binding already in linux-next), line 67 (pogo field), §7 items 3, 15, 20, 21, 22, §8 risks 6, 9, 19, §9 D20, D21 (line references), D31, D36. No decision, priority or requirement status changed.
- **Updated 2026-10-24 (electronics plan E1.4–E1.6):** §7 item 1 narrowed by the MCLK attenuator simulation; §7 item 22 narrowed from TI's BQ28Z610-R1 technical reference (lines 42, 43); §7 item 28 closed on Murata and Samsung DC-bias data (line 121). No decision, priority or requirement status changed.
- **Scope:** the T1 main board and the touch faceplate, by subsystem, including the support parts around the main ICs (regulators, switches, protection, clocks, magnetics, connectors, test access).
- **Companion:** [power tree v0](power-tree-v0.md) (updated with this BOM) holds the rails, currents, gating map, sequencing and the calculations behind the power, audio, backlight and HAT picks.
- **Sources:** [BOM v1 draft](bom-v1-draft.md), [headphone output power research](../research/2026-10-headphone-output-power.md), [cross-validation](../research/2026-10-bom-v1-cross-validation.md), [BOM v0](bom-v0.md), [pin multiplexing v0](../research/2026-10-pin-multiplexing-v0.md), [component selection](../research/2026-10-component-selection.md), [sourcing alternatives](../research/2026-10-sourcing-alternatives.md), [high-speed I/O topology](../research/2026-10-high-speed-io-topology.md), [battery selection](../research/2026-10-battery-selection.md), [2S battery study](../research/2026-10-battery-2s.md) (v1.5), [output-stage simulation](../research/2026-10-output-stage-simulation.md) and [boost and MaskROM simulation](../research/2026-10-boost-and-maskrom-simulation.md) (v1.6), touch-faceplate ADR 0001, board ADRs 0001–0015, blackbird-os ADRs 0006–0008; from v1.9 board ADR 0019 and [pinout v1](pinout-v1.md); from v1.10 board ADR 0020 and the [contact battery research](../research/2026-10-contact-battery-t1.md); from v1.11 hat-standard interface v1.1 and ADR 0005, the t1 faceplate interface v1 and t1 ADRs 0004 and 0005.
- **Product rules applied:** availability first and validated; newest compatible generation; mainline Linux drivers (DKMS or validated vendor drivers acceptable); no unusual switches or tricks (BRD-042); helper MCUs never in a data path (BRD-005); audio quality and battery life first; every block power-gated when unused (BRD-008); every bus and interface protected (BRD-007); the SoC reaches every chip directly (BRD-004).

## Conventions

- **Driver path:** *mainline + Debian* (module enabled in Debian's trixie-backports `linux-config-7.2_7.2.9-1~bpo13+1` arm64 config, re-checked 2026-10-22), *DKMS* (mainline driver Debian does not enable; blackbird-os ADR 0007), *none* (no driver needed).
- **Availability:** stock and qty-1 price captured **2026-10-22**. LCSC figures come from the JLCPCB parts API; Mouser, Newark, Arrow, Verical and TME figures from [FindChips](https://www.findchips.com/) (brokers excluded); Digi-Key figures from Digi-Key pages. Figures dated 2026-10-21 are carried over from the component-selection report.
- **UNVERIFIED** = no primary source found in this session.
- Datasheets (URL, revision, date, sha256) are in the [Datasheets](#datasheets) table at the end. No PDF is stored in the repository.

## Changes in v1.11

Two interface specifications changed on 2026-10-24 and this version applies their board changes: hat-standard [HAT interface v1.1](https://github.com/opendap-project/hat-standard/blob/main/docs/specs/interface-v1.md) with its [ADR 0005](https://github.com/opendap-project/hat-standard/blob/main/docs/adr/0005-interface-v1-1-shared-extension-and-contact-reduction.md) (Accepted; hat-standard commit `00a683f`), and the t1 [faceplate interface v1](https://github.com/opendap-project/t1/blob/main/docs/specs/faceplate-interface.md) §10 with t1 ADR 0004 (identity and HID transport) and ADR 0005 (supply classes and protection) (t1 commit `e1e18e7`). Calculations are in [power tree v0.5](power-tree-v0.md#changes-in-v05). Stock and qty-1 prices captured **2026-10-24** (LCSC through the JLCPCB parts API, Mouser and others through FindChips). The part choices below are taken by Claude under the maintainers' delegation and stay *Proposed*. Nothing here is built or measured; no requirement priority or status changes.

### HAT interface v1.1 (v1.11)

1. **Flat-cable connector (line 66): one DF40C-100 pair per cable end** carries signals and power; the DF40C-50 power pair is removed at both ends. Allocation: interface v1.1 §7.2. The four corner contacts of the DF40C-100DP header are metal fittings and must not carry signal or power (Hirose DF40 catalog, May 1, 2020, p. 10, note 3): positions 1, 2, 99 and 100. The allocation uses positions 3–98 only, **87 of the 96 usable**, 9 spare (9.4 %), none at a corner. The connector is not polarized (p. 10 note 5; receptacle p. 4 note 4): a 180° mating would put `HAT_5V` on signal contacts, so both cable ends are keyed. `HAT_DET#` at position 33 proves the single connector is mated.
2. **Power on the DF40 at 0.3 A per contact** (catalog p. 2; the rating includes the contact's own temperature rise, note 1), against BRD-049 (≤ 70 % continuous, ≤ 100 % at the protective limit):

   | Rail | Contacts | Continuous (interface rating) | At the interface fault ceiling | At the T1's own maximum trip (items 6, 7) |
   |---|---|---|---|---|
   | `HAT_5V` | 10 | 2.0 A → 0.20 A (67 %) | 3.0 A → 0.30 A (100 %) | out 1.68 A → 0.17 A (56 %); in 2.95 A → 0.295 A (98 %) |
   | `HAT_3V3` | 5 | 1.0 A → 0.20 A (67 %) | 1.5 A → 0.30 A (100 %) | 1.16 A → 0.23 A (77 %) |
   | `GND` (power return) | 15 | 3.0 A → 0.20 A (67 %) | 4.5 A → 0.30 A (100 %) | 2.95 + 1.16 = 4.11 A → 0.27 A (91 %) |

   `HAT_5V` out and in never flow together (TPS2121 OV2 interlock, line 45). Contact resistance ≤ 90 mΩ (catalog p. 2): 30 power contacts at 0.20 A dissipate ≤ 0.11 W per connector (arithmetic).
3. **Pogo field (line 67): 100 → 68 contacts** (4 × 17 at 2.54 mm, 40.64 × 7.62 mm span); spring force ≈ 60 N with the P70 (0.88 N each), ≈ 77 N with the Mill-Max 0965 second source (unchanged).
4. **ESD (lines 68, 69).** High-speed: **TPD4E05U06 × 6 → × 4** for 8 pairs (USB 3 SS × 2, USB 2, `EXT0`–`EXT4`), 16 lines on 16 channels. Low-speed: **TPD4E05U06 × 8** for 30 lines (22 low-speed and 8 reserved, all with cable positions) on 32 channels; **TPD1E10B06 × 2 → × 0**: line out leaves the interface (ADR 0005 item 5). The board never had a line-out source (no DAC output or ball was assigned to it); only its two ESD parts and the interface positions existed, and both are gone.
5. **Extension switch (new line 144): two TI TMUXHS4412IRUAR.** `EXT0`–`EXT4` (common ports) select between port A (PCIe REFCLK, TX, RX on `EXT0`–`EXT2`) and port B (CSI-2 D0, CLK, D1, D2, D3 on `EXT0`–`EXT4`). Control from the two balls freed by the dedicated SWD lines (pinout v1, changes of 2026-10-24): `HAT_EXT_SEL` and `HAT_EXT_PD`. The PCIe TX AC capacitors (line 70) sit between the SoC and port A, never on the shared path, because CSI-2 is DC-coupled. **BRD-042** (reworded 2026-10-24: a standard switch is acceptable when it keeps the full rate with margin), typical values from TI SLASEW5A §5.6–5.7 (no minimum or maximum is given):

   | | PCIe Gen2 (5 GT/s, Nyquist 2.5 GHz) | D-PHY at 2.5 Gb/s per lane (Nyquist 1.25 GHz) |
   |---|---|---|
   | −3 dB bandwidth 13 GHz | 5.2 × Nyquist | 10.4 × Nyquist |
   | Insertion loss | −0.7 dB at 2.5 GHz | between −0.4 dB (10 MHz) and −0.7 dB (2.5 GHz) |
   | Return loss | −23 dB at 2.5 GHz | between −30 dB (10 MHz) and −23 dB (2.5 GHz) |
   | Crosstalk / off isolation | −64 dB / −27 dB at 2.5 GHz | between the 10 MHz (−73 dB / −57 dB) and 2.5 GHz rows |
   | Skew, intra-pair and inter-pair | 4 ps each, 2 % of the 200 ps unit interval | 4 ps, 1 % of the 400 ps unit interval |
   | Common mode, swing | 0–1.8 V at VCC 3.3 V, ≤ 1.8 Vpp differential | covers D-PHY low-power signalling (**UNVERIFIED** against the MIPI D-PHY text, member-only) |

   The part is listed by TI for PCIe 1.0–4.0 and MIPI DSI/CSI (§7.1), so both links run at the most the RK3566 offers through it. The loss of the whole channel (switch, DF40, flat cable, pogo field) is **UNVERIFIED** until the hat-standard coupon.
6. **eFuse maximum trips (line 44)** with the RILM tolerance (BRD-049; interface v1.1 §5, "maximum trip current, tolerance included, inside the fault ceiling"): #A and #C 2.21 kΩ 1 % → 3,334 / 2,188 Ω = 1.524 A typical (SLVSFC9C Equation 7) + 10 % (§6.5, ILIM > 1 A) = **1.68 A**, 56 % of the 3.0 A `HAT_5V` ceiling (was quoted 1.66 A without the resistor tolerance); #B 3.32 kΩ 1 % → 1.150 A × 3.320 / 3.287 = **1.16 A**, 77 % of the 1.5 A `HAT_3V3` ceiling. No change of part or value.
7. **TPS2121 current limit (line 45): RILM 44.2 kΩ → 45.3 kΩ 0.1 %.** TI characterises the TPS2121 limit at five resistor values, all with a ±0.5 A spread (±0.6 A at 18.7 kΩ; SLVSEA3F §7.5). At 44.2 kΩ 1 % the maximum is 2.52 + 0.5 = **3.02 A, above the 3.0 A ceiling**. With 45.3 kΩ 0.1 %: ILM = 65.2 / R^0.861 (Equation 2) = 2.45 A typical, **2.95 A maximum (98 % of 3.0 A)**, 1.94 A minimum, taking the same ±0.5 A spread at 45.3 kΩ (**UNVERIFIED**: TI has no row at that value; measure on the first boards). Because the minimum is now below 2.0 A, the BQ25798 input limit IINDPM is set to **1.9 A** (was 2.0 A) whenever VBUS ≤ 5.5 V, so the mux never limits during normal charging: IINDPM regulates at or below its setting (1.80–1.96 A at a 2.0 A setting, SLUSDV2C §6.5, measured at 9 V), ≈ 1.86 A maximum at 1.9 A (scaled, est.), 96 % of the mux minimum. 9 V PD input stays at 1.67 A (15 W). This costs 0.5 W of 5 V charging input (10 → 9.5 W).
8. **Flat cable (line 102):** one DF40C-100 at each end; shared `EXT` pairs at 100 Ω differential, USB 3 at 90 Ω; power conductors sized for the fault ceilings (a limiter in current limit holds its current until thermal shutdown): IPC-2221 external, ΔT 10 °C, `HAT_5V` 3.0 A 1.37 mm at 35 µm (2.66 mm at 18 µm), `HAT_3V3` 1.5 A 0.53 mm (1.02 mm), `GND` 4.5 A 2.39 mm (4.65 mm) or a full ground layer, which also references the pairs (arithmetic; FPC copper and stackup **UNVERIFIED** until the FPC fab quote).
9. **Sidebands (line 135, pinout v1):** the G14 gate's output becomes `HAT_EXT_SB0` (PCIe PERST# or the sensor reset, both held asserted until HAT power is good); `HAT_EXT_SB1` and `HAT_EXT_SB2` are the PCIe CLKREQ#/WAKE# balls, used as GPIO in CSI-2 mode, with their 4.7 kΩ pull-ups. SWD to the HAT becomes a bit-banged alternate on `HAT_GPIO2` (SWCLK) and `HAT_GPIO3` (SWDIO).
10. **Cost (qty 1, est., USD):** + 2 × 2.94 (TMUXHS4412IRUAR, LCSC) and their passives ≈ +6.1; four DF40C-50 parts removed (≈ −3 to −6 at Mouser's DF40C-50DP price, the receptacle price not captured); two TPD4E05U06 and two TPD1E10B06 fewer (≈ −0.3); 32 fewer pogo pins on the device-side piece (price not captured). Roughly neutral in every variant.

### Faceplate interface v1 (v1.11)

From the t1 faceplate interface §10, BC1–BC8; contact positions unchanged.

1. **FP_3V3 (BC1; new line 145): TPS22919 → TI TPS22950YBHR**, a current-limited load switch, RILIM **3.57 kΩ 1 %**: ILIM = 1.18 × R^−1.072 (SLVSFJ2B Equation 1) = 0.30 A typical. TI gives the spread at 2.21 kΩ (0.38–0.62 A, ±24 %) and 19.2 kΩ (±32 %); interpolating on log R gives ±26 % at 3.57 kΩ (**UNVERIFIED**, measure): **0.22–0.38 A** with the resistor tolerance, the maximum 96 % of the 0.4 A ceiling and the minimum above the 200 mA budget. Auto-retry on overcurrent, reverse-current blocking, quick output discharge, 1.8–5.5 V, 62 mΩ maximum at 3.3 V (SLVSFJ2B §7.5). The SOT-23 TPS22950C is not usable: its range starts at 0.5 A (Table 5-1).
2. **FP_1V8, MIC_1V8 (BC2) and FP_VCI (BC3; new line 146): three TI TPS22945DCKR**, fixed current limit **100–200 mA** (SLVS832D §7.5, at VIN 3.3 V), 10 ms blanking and 80 ms auto-restart, active-high ON, 1.62–5.5 V: the maximum is 100 % of the 0.2 A ceiling and the minimum is at the FP_1V8 and FP_VCI budgets (100 mA) and five times the MIC_1V8 budget (20 mA). TI specifies the limit at 3.3 V only; at 1.8 V and 2.8 V it is **UNVERIFIED** (TI query, or a measurement across parts on the M-UI module). Its ON resistance is up to 1.1 Ω at 1.8 V (≈ 0.8 Ω at 2.8 V, interpolated): at the 100 mA budget FP_1V8 drops 0.11 V; the touch faceplate draws ≈ 5 mA (5.5 mV). Alternate on MIC_1V8: TPS22946 with CL low (70–120 mA characterised at 1.8 V, SLVS984B §6.5; WCSP). TPS22919 count (line 50): **9 → 6**.
3. **FP_VCI (BC3).** The RK809 datasheet (Rev 1.01) rates LDO4 at 100 mA (Table 4-1, RK809-1) or 400 mA (electrical table, `RegLDO4_MAX` = 1) and offers only `LDO4_IMAX` (0x00D2 bit 7: normal or 130 % of nominal, p. 86), with no trip value: **LDO4's limit cannot be confirmed ≤ 0.2 A**, so FP_VCI gets one of the TPS22945 of item 12 between LDO4 and contact 44, ON from `FP_IO_EN`. **Power-up state:** the RK809-1 starts LDO4 at 3.0 V in slot 5 of its sequence (Table 4-1); the RK809-5 OTP table is not public (§9 D19). With the switch, FP_VCI stays off at the contact until `FP_IO_EN` (expander P00, pulled down) goes high, whatever the OTP does.
4. **Backlight (BC4; lines 51–53): TPS61169 → TI TPS61160DRVR.** Its open-LED threshold is **25–27 V** at the SW pin (SLVS791E §6.5), so BL_LEDA stays below 30 V in every state, an open string included; the TPS61169's 36–39 V did not. A faceplate string's forward voltage stays ≤ 22 V (the 25 V minimum threshold less 3 V; faceplate interface §2.3). RSET 200 mV / 60 mA → **3.32 Ω** (60.2 mA). Inductor **10 → 22 µH**, Murata LQH3NPN220MMEL on the same 3 × 3 mm land (LCSC C703143 9,761 @ $0.20; 0.54 A rating from the LCSC listing, Murata sheet not retrieved): TI recommends 10–22 µH (§8.2.1.2.2), and with 10 µH the worst-case maximum output at VIN 3.8 V is 51 mA, below the 60 mA full scale. With 22 µH, worst case (ILIM 0.56 A minimum, 500 kHz minimum, η 0.85 est., SLVS791E Equations 3–4): **82 mA at a 16.5 V string (60 mA = 73 %)**, 75 mA at 18 V (80 %), 61 mA at 22 V (99 %); inductor peak 0.44 A at 16.5 V and 60 mA (82 % of 0.54 A). A faceplate whose string exceeds 18 V declares a full-scale current that keeps 80 %, until a driver on VSYS is studied (power tree §8). Rectifier PMEG6010CEH unchanged (60 V against 27 V); output capacitor ≥ 35 V (the 50 V part stays). New land: WSON-6 2 × 2 mm. Software unchanged: `pwm-backlight` on CTRL (PWM 5–100 kHz, §6.3).
5. **Faceplate I2C3 pull-ups (BC6):** 4.7 kΩ (the §5 3.3 V default) → **2.2 kΩ to FP_3V3**. Fast mode needs tr ≤ 300 ns; with the faceplate's 100 pF and ≈ 20 pF on the board (SoC pad, ESD channel, trace; est.) Rp ≤ 300 ns / (0.8473 × 120 pF) = 2.95 kΩ and Rp ≥ (3.3 − 0.4 V) / 3 mA = 0.97 kΩ (NXP UM10204 §7.1); 2.2 kΩ gives 224 ns (75 %). 4.7 kΩ gave 478 ns, outside fast mode.
6. **Identity controller (BC5, BC7).** The faceplate's HID-over-I2C identity device (0x2C, descriptor register 0x0001, `HID_INT#` level-low) needs no board part: the board devicetree node is in the [feature blocks](feature-blocks.md) (`blk.fp-controls`). The identity controller's BOM line belongs to faceplate-touch (BC7), not here.
7. **Naming (BC8):** "faceplate interface v0" → "faceplate interface v1" across the board specifications; no contact moves.
8. **Cost (qty 1, est., USD, LCSC):** TPS22950 0.89 + 3 × TPS22945 0.53 − 3 × TPS22919 0.12 ≈ **+2.1**; TPS61160 0.43 against TPS61169 0.32, +0.11. **Availability:** TPS22945DCKR LCSC 9,233, Mouser and Newark 0; TPS22950YBHR LCSC 2,892, Mouser 9,300; TPS61160DRVR LCSC 9,749, Mouser 0 (TPS61160DRVRG4 8,643); TMUXHS4412IRUAR LCSC 964, Mouser 970.

## Changes in v1.10

[ADR 0020](../adr/0020-battery-connected-through-contacts.md) (Accepted) and its [contact battery research](../research/2026-10-contact-battery-t1.md). Calculations are in [power tree v0.4](power-tree-v0.md#changes-in-v04) §4.7.1. Stock captured **2026-10-24** (Digi-Key pages, FindChips). Nothing here is built or measured; no requirement priority or status changes.

1. **Battery connection (line 47).** Molex Micro-Fit 3.0 43650-0400 → **six KYOCERA AVX 70-9258-001-120-006** spring contacts in a window of the pocket floor at the pocket's bottom end, face compression on the pack's pads. Order at 3.5 mm pitch: **P+, P+, empty position, mid-cell tap, NTC, P−, P−**. Two contacts per power pole; no Kelvin contacts (ADR 0020 item 4). Alternates: none on the same land; Mill-Max 0965 or 0990 pogo pins, four per pole on their own land, to qualify.
2. **Pack specification (line 46).** The 4-pin Micro-Fit 3.0 lead becomes a **terminal board with recessed hard-gold pads**: seven positions (P+, P+, no pad, mid-cell tap, NTC, P−, P−), pads ≥ 4.0 × 2.5 mm, electrolytic hard gold ≥ 0.76 µm over nickel, power pads recessed 0.2 mm and signal pads 0.4 mm, walled against a flat metal object, **keyed** by an asymmetric terminal end matching the pocket and polarity-marked; ≥ 5 A per power pad; the PCM's short-circuit threshold, delay and behaviour under the insertion pulse stated; UN 38.3 and IEC 62133-2 on the pack as shipped with exposed pads; a terminal cover for spares (ADR 0020 item 8, research §5). The acceptance criterion "lead and plug ≥ 4.6 A per pole" becomes "contact interface ≥ 4.6 A per pole" (ADR 0020 item 3). Keying moves from the Micro-Fit plug to the pack's terminal end and the pocket.
3. **Wording (lines 39, 42, 48, 104).** "Battery connector" → "battery contacts" (line 47): the gauge VC2 and VC1 and the charger TS take the pack through the contacts; the fuse sits between the battery contacts and the BQ25798 BAT pins.
4. **BATP network (line 115).** BATP 100 Ω in series (already listed) **and 47 nF to GND**, TI's recommendation for hot-plugged packs (SLUSDV2C Figure 8-2 note 2; ADR 0020 item 6). Test points on the pack side of the fuse and on BAT for the insertion measurement (CB-07, PCB-L-09) add two to line 86 (PCB-T-02).
5. **Battery-contact protection (new line 142).** One TPD1E10B06DPYR on each of the mid-cell tap and NTC contacts, within 3 mm of the contact (PCB-L-08), and an **unfitted P+ TVS footprint** (standoff ≥ 9 V, clamp < 20 V, part to choose), fitted only if the insertion and ESD measurements (CB-07, CB-10) ask for it.
6. **Cover detect (new line 143, should).** A board input that changes state when the back cover is lifted, so Blackbird OS powers down in order (the ADR 0017 item 3 sequence when no adapter is present) before the pack can be reached: a board-edge contact pad for the case's actuator, a pull-up and one TPD1E10B06DPYR; the GPIO is chosen in the pinout. It protects data, not safety (T1-086). Block `blk.cover-detect` in the [feature-block catalog](feature-blocks.md); variant field per RFC 0011: fitted in `full`, `production` and `lite` (≈ $0.05 at qty 1, est.: far below the ≈ 1 % BRD-053 threshold).
7. **BRD-049 margins of the battery path through the contacts** (power tree §4.7.1). Two contacts per pole with a sharing factor of 1.25 on the hotter contact (assumed until CB-01): worst continuous 3.2 A → 2.0 A = **33 %** of 6 A (≤ 70 % contact rule; Micro-Fit was 64 %); full budget 2.4 A → 25 %; 5 A protective limit (PCM trip upper limit, fuse rating) → 3.1 A = **52 %** (≤ 100 % trip rule); pole rating 0.8 × 2 × 6 A = 9.6 A against ADR 0014's ≥ 4.6 A per pole; one contact of a pole not touching (a fault, not a design case): 53 % at 3.2 A, 83 % at 5 A. **Heat**, with an end-of-life resistance ≤ 20 mΩ per contact (**UNVERIFIED** until KYOCERA AVX product specification 201-01-252 or CB-01): 0.08 W on the hotter contact and ≈ 0.26 W in the four power contacts at 3.2 A (80 mV in total); 0.19 W and ≈ 0.63 W at 5 A for the PCM's trip time only. Temperature rise **UNVERIFIED** (no published thermal resistance; CB-02). Path resistance ≈ 65 mΩ at end of life (est.; was ≈ 38–48 mΩ): the cell pair holds ≈ 6.8 V for VSYS = 6.6 V at 3.2 A.
8. **Pocket length (§7 item 42).** The 2.5 mm of pocket length the [battery selection](../research/2026-10-battery-selection.md) §2.3 budgets for the lead exit, bend radius and connector seating is no longer needed: it returns to the pack (about +4 % of pack length, arithmetic 2.5 / 60.5, est.) or to the case. Any re-run of the battery-selection pack-size arithmetic takes the pocket length without that allowance; the pocket floor gains the contact window (about 24.5 × 9 mm, arithmetic) with an insulating liner, and the six contact forces become an input to the back cover's foam preload.
9. **Cost (est., USD):** contacts ≈ $1.50 for six at 1,000 (≈ $2.46 at qty 1, Digi-Key) against ≈ $1.18 for the 43650-0400 header; two TPD1E10B06 ≈ 0.08 and 47 nF ≈ 0.01 (LCSC basis); cover detect ≈ 0.05. On the pack: a terminal board instead of the lead and plug (quote, **UNVERIFIED**). Area: the window takes about 24.5 × 9 mm from the zone under the pocket (RK3566, LPDDR4X, eMMC), an input to placement (PCB-L-04).

## Changes in v1.9

[ADR 0019](../adr/0019-master-clock-divided-from-twice-the-frequency.md) (Accepted), the BOM and power-tree items B1–B16 of [pinout v1](pinout-v1.md) §9.2, and three decisions taken by the main session under the maintainers' delegation on 2026-10-24. Calculations are in [power tree v0.3](power-tree-v0.md#changes-in-v03). Stock captured **2026-10-24** (Digi-Key pages, FindChips for Mouser, LCSC through the JLCPCB parts API). Nothing here is built or measured; no requirement priority or status changes.

1. **Master clock ([ADR 0019](../adr/0019-master-clock-divided-from-twice-the-frequency.md); lines 20, 21, 29, 139, 140, 112, 135; §4.3; §7 items 1, 10, 19).** The oscillators become **NDK NSC5083D-45.158M** and **NSC5083D-49.152M** (same NZ2520SDA land, MCLK_3V1 unchanged), one shared net with 33 Ω at each output and a 100 kΩ pull-down at the dividers. **One TI SN74AUC1G74DCUR per DAC** (new line 139) divides by two, so the XTI duty no longer depends on the oscillator's 40–60 % symmetry (simulated 45.08–54.35 % against 45–55 %). The dividers run from a new rail **MCLK_1V8**: a third TPS7A2018 (line 29) from AUDIO_2V2 with EN tied to DAC_DIG_1V8. The passive attenuator of §7 item 1 is removed; its values never became BOM lines. Both divider CLR̅ inputs sit on `MCLK_DIV_RUN` (100 kΩ pull-down); pinout v1 has no ball for it (§7 item 39). The HAT copy (line 112) cannot hang on the oscillator net, which has 1.3 pF left of its 15 pF rating. Power: ≈ 8.9 mA at 1.8 V (≈ 20 mW at AUDIO_2V2) for the dividers, minus the attenuator's ≈ 6.5 mW: ≈ +13 mW in playback (est., ADR 0019).
2. **Radio in suspend for item tracking (decision 2026-10-24; BRD-030 should, T1-069; lines 50, 55, 93, 103, 129; §7 item 40).** The Type 2EL can stay powered in suspend so Bluetooth item tracking keeps running. Both module power rails are switched from the always-on domain: AVDD33 (vcc3v3_wl) moves from RK809 SWOUT1 to a **ninth TPS22919** from vcc3v3_sys, ON from **expander P06 `WL_PWR_EN`** (a spare in pinout v1; the expander holds its outputs through suspend; board pull-down, so off by default); the AVDD18 buck (line 129) keeps its EN on vcc3v3_wl, so one line switches both. Default: off in suspend; on in suspend only while the listener enables tracking. BRD-049: 1.05 A peak = 70 % of the switch's 1.5 A, 0.24 A typical = 16 %; 95 mV across 90 mΩ at the peak. SWOUT1 is left unused. VIO and SD_VIO stay on vcc_1v8 (VCCIO4, as pinout v1 confirms); while tracking is enabled, vcc_1v8 also stays on in suspend (RK809 sleep configuration, no part), so no module output drives an unpowered VCCIO4 pad. Suspend draw: **UNVERIFIED** until measured on the radio module (M-RF) through links 11 and 12 (power tree §4.12). `WL_PDN` (GPIO2_B7) loses its state in Rockchip's standby (HDG p. 35): for the pinout owner (§7 item 40).
3. **Faceplate supply in suspend (decision 2026-10-24; T1-060).** FP_3V3 and FP_1V8 are off in suspend by default; the T1 wakes from the body buttons on the always-on domain (power key on RK809 PWRON, Action button on a PMUIO2 ball). `FP_IO_EN` stays on expander P00, which holds its state through suspend, so the hardware can keep FP_3V3 on for a faceplate that must wake the T1 (`FP_HID_INT_N` on its PMUIO1 wake ball, masked while FP_3V3 is off; pinout v1). FP_1V8 comes from vcc_1v8 and follows it. No part changes; pinout B5 closed.
4. **802.15.4 balls (decision 2026-10-24; T1-077).** The four 1.8 V SPI2 M0 balls (GPIO2_C1–C4) stay unassigned spares reserved for a variant: no requirement asks for 802.15.4, and T1-077 keeps it disabled while it is not wired. The module's 802.15.4 SPI (pins 4–8) stays unconnected (line 55). Pinout O6 closed.
5. **vcc3v3_sys re-sum (BRD-049; line 6, 106; §7 item 36).** Estimated peak 2.45 A: BUCK5 input 0.40, RK809 LDOs 0.30, radio AVDD33 1.05 (now through the line 50 switch, same rail), SWOUT2 0.20, eMMC 0.25, haptic driver 0.10 (line 123, missing from the v1.8 sum), the rest 0.15 A. That is 82 % of the TPS62826's 3 A, past 80 %, so line 6 becomes the pin-compatible **TI TPS62827DMQR** (4 A): **61 %**; inductor peak 2.66 A = 55 % of its 4.8 A minimum high-side limit; its 6.4 A maximum limit is 94 % of TI's 6.8 A figure for the line 106 inductor. Output capacitance ≥ 20 µF effective (SLVSEF9I p. 14): the 22 µF + 10 µF of D26 stays, checked on the maker's DC-bias curve at schematic capture. Mouser 11,779 @ $1.62; LCSC C2071448: 592 @ $1.21 (2026-10-24). The TPS62826 stays on line 129.
6. **Pinout v1 items (§9.2 B1–B16).** B1: `vccio6_1v8`, the audio IO bank on its own branch of vcc_1v8 through a 0 Ω link with a ferrite-bead option and 100 nF per supply ball (line 141; power tree §3). B2: IO-domain table in power tree §3.1. B3: `HAT3V3_EN` on expander P01 (line 38). B6: eFuse IMON #A to SARADC_VIN2, #B to VIN3, #C to a test pad (line 44). B7: no gauge alert line (line 42). B8: a fourth DMG1012T-7 drives the RP2354A BOOTSEL (line 35); PCA9306 EN/VREF2 200 kΩ to HAT_3V3; `HAT_AUD_OE_N` pull-up; 0 Ω footprints on both ST lines; the MAX98357A SD_MODE select resistor; the `USB_OTG0_VBUSDET` divider (line 141). B9, B10: pulls and series resistors (line 141, §5). B11: expander port map (line 93). B12: RK809 codec pins (line 2). B13: §4.2 replaced by the pinout v1 domain map. B14: AXC translators' B side and PCA9306 VREF2 on HAT_3V3 (lines 94, 95). B15: BOOTSEL and RUN (line 12). B16: USB PHY 3.3 V supplies on vcc3v3_sys (power tree §3, **UNVERIFIED**). Also: the faceplate low-speed ESD counted 20 lines where pinout v1 §8.2 has 21: TPD4E05U06 ×5 → ×6 (line 75); the ALS interrupt is now a 3.3 V line (line 60). §7 item 37 closed.
7. **Measurement:** one more link (36), L1 class at the MCLK_1V8 LDO input, so `blk.mclk` is attributed in full (line 137, power tree §4.12).
8. **Cost (qty 1, est., USD, LCSC basis):** dividers 0.86, third TPS7A2018 0.26, TPS62827 instead of TPS62826 +0.41, ninth TPS22919 0.12, sixth TPD4E05U06 0.08, DMG1012T-7 0.02, passives ≈ 0.15: ≈ **+1.9** in every variant. The oscillators keep their $2.94 Digi-Key price. Area ≈ +15 mm² (est.: two VSSOP-8, one SOT-23-5, one SC70-6, passives).

## Changes in v1.8

Electronics plan tasks E1.12 (radio 1.8 V rail; LPDDR4X VDD1 and VDD2 against the rail map) and E1.15 (feature-block gaps G1–G21 of the [block catalog](feature-blocks.md) §7), plus [ADR 0017](../adr/0017-fuel-gauge-wiring-sense-resistor-and-configuration.md) (fuel gauge, item 10) and [ADR 0018](../adr/0018-antennas-and-certification-route.md) (antennas, item 11), decided by Claude under the maintainers' delegation. Stock captured **2026-10-24** (LCSC through the JLCPCB parts API; Mouser, Arrow, Newark, TME, Future and Verical through FindChips). Calculations are in [power tree v0.2](power-tree-v0.md) (Changes in v0.2, §4.12, §4.13). Every new line names its block (RFC 0011) and its state per variant (`full` / `production` / `lite`, BRD-053, ADR 0013). Assumptions about IO-domain voltages are marked "to reconcile with pinout v1".

1. **Radio 1.8 V power rail (E1.12; lines 129–131): TI TPS62826DMQR** (the line 6 part) from VSYS_LV makes **vcc1v8_wl** for the Type 2EL AVDD18 pins (30, 31). AVDD18 is a power rail: 323–390 mA typical in Bluetooth and 802.15.4 transmit, 255 mA in Wi-Fi 5 GHz transmit (Murata E2B-09-1413 Tables 19–21), peaks above 1 A at start-up calibration (Embedded Artists M.2 datasheet PA4 pp. 8, 22; carrier, not module). BRD-049: 390 mA = 13 % of 3 A continuous; the 1.05 A peak puts the inductor at 1.51 A = 41 % of the 3.7 A minimum switch limit. Not on `vcc_1v8` (BUCK5): ampere-level transmit bursts would land on the rail that feeds the DAC VD, VL and VCP switch, and BUCK5 is off in suspend. EN follows vcc3v3_wl (RK809 SWOUT1), so one switch powers the module. The module's VIO and SD_VIO stay on `vcc_1v8` (VCCIO4 domain, to reconcile with pinout v1).
2. **LPDDR4X VDD1 and VDDQ bias moved to an always-on rail (E1.12; lines 9, 132).** The rail map put the memory's VDD1 (1.8 V) and the TPS7A1006 BIAS on `vcc_1v8`, which is off in suspend (power tree §3), while self-refresh needs the DRAM supplies and the 0.6 V VDDQ (Rockchip HDG 1.1 p. 35 keeps VCC_DDR on in standby). Every RK3566 reference read keeps VDD1 always on: Radxa ZERO 3W v1.12 ties VCC1V8_DDR to VCCA1V8_PMU through a 0 Ω (R123), Pine64 Quartz64-A v2.0 through 0.1 Ω (R3807), Radxa ROCK 3C v1.4 from a dedicated LDO enabled by VCC3V3_PMU with the VCCA1V8_PMU link unfitted. The T1 follows the ZERO 3W: **vcc1v8_ddr = vcca1v8_pmu through a measurement link**, with a DNP TPS7A2018 footprint for the ROCK 3C topology; BIAS moves to vcc1v8_ddr.
3. **VDD2 checked (E1.12):** `vcc_ddr` (RK809 BUCK3, external divider, VFB3 0.784 / 0.800 / 0.816 V, RK809 Rev 1.01 p. 17) at **47 kΩ / 120 kΩ 1 %** as on the ROCK 3C → 1.113 V nominal, ≈ 1.08–1.14 V worst case; the RK3566 needs 1.10 V on DDR_VDDQ with LPDDR4X (HDG 1.1 p. 23). The memory's VDD2 window and VDD1/VDD2 currents need Samsung's datasheet (NDA): **UNVERIFIED**. The TPS7A1006 headroom falls to ≈ 0.48 V at the low corner against the datasheet's VIN ≥ VOUT + 0.5 V condition (§7 item 33).
4. **DAC control-bus isolation (G2; line 133): TI SN74LVC2G66DCUR** analog switch on I2C2 SDA/SCL, VCC on vcca1v8_pmu, both controls driven by DAC_DIG_1V8 itself: the CS43198 pair joins the bus only while powered. 0 Ω bypass footprints (DNP). DAC_INT pull-up on DAC_DIG_1V8.
5. **MCLK interlock (G3) and PCIe reset gate (G14) (line 135): two SN74LVC1G57DCKR** (the line 98 family) wired as 2-input AND: the TPS7A2031 (MCLK_3V1) EN = `AUDIO_LN_EN` AND DAC_DIG_1V8, so the master clock never drives an unpowered XTI; `PCIE_PERST#` = SoC PERST# AND HAT power-good with the ≥ 100 ms RC.
6. **I2S series footprints (G2, G4, G21; line 134):** 0 Ω footprints at the DAC end of SDO0–SDO2, SCLK, LRCK, DSD clock and DSD data, and at the RP2354A tap branch. The RP2350's FT GPIOs accept up to 3.63 V with IOVDD = 0 V (absolute maximum, parts-lib RP2354A sheet), so the taps must use GPIO0–GPIO25, not the ADC pins (to reconcile with pinout v1).
7. **Always-on 1.8 V devices (G1, G5, G6, G15, G16, G19):** the IMU, TPM, NFC tag, board EEPROM, expander VCCI and the I2C2 pull-ups move to **vcca1v8_pmu** (RK809 LDO8, on in suspend), so nothing on I2C2 is unpowered while the bus is live; the PN7160 VDD(PAD) joins them. Budget: ≈ 160 mA (est.) = 39 % of LDO8's 400 mA rating, 79 % of its 200 mA low-headroom figure (power tree §4.13).
8. **PN7160 supply (G7; lines 50, 127):** VBAT and VDD(UP) from **VSYS_LV through an eighth TPS22919** (`NFC_PWR_EN`); 290 mA maximum in reader mode (PN7160 data sheet Rev. 3.4, Table 1) = 19 % of 1.5 A. VBAT 2.8–5.5 V operating, 6 V absolute (Table 1, Table 28): the 6.0–8.8 V battery path of v1.7 would have destroyed it. VEN and DWL_REQ on native 1.8 V GPIO, not the 3.3 V expander.
9. **Measurement (G10, G11, G12; lines 54, 136, 137):** one measurement link per block supply, **35 positions**, with Kelvin pads: a shunt in `full`, 0 Ω in `production` (the five ≥ 1.5 A positions keep their 5 mΩ shunt). INA236 positions defined (audio on a dedicated VSYS_LV branch, display on the TPS61169 input, VSYS, HAT) and a **fifth monitor, INA236BIDDFR at 0x48**, on the LMR33630C input (VSYS), so the audio block is attributed in full.
10. **Fuel gauge ([ADR 0017](../adr/0017-fuel-gauge-wiring-sense-resistor-and-configuration.md), Accepted; lines 42, 43, 120, §7 item 22):** PACK on the BQ25798 BAT node (switched side of the ship FET) instead of BAT+; sense resistor 5 mΩ → **3 mΩ Vishay WSL12063L000FEA** (same footprint; 31 mW at 3.2 A); storage and critical-battery power-off through gauge SHUTDOWN and the charger's shutdown mode (≈ 1 µA typical, 4.7 µA maximum board drain); golden-image fields; §7 item 22 (a)–(c) closed, (d) open.
11. **Antennas ([ADR 0018](../adr/0018-antennas-and-certification-route.md), Accepted; lines 56–58):** two Molex 146187-0050 → **one Molex 146153-0050** on ANT0 in Murata's shared configuration (on the FCC, ISED and Japan lists); the second U.FL (ANT1) is fitted in `full` only; matching in 0603 as Murata's reference, with the 10 pF pin 18–23 link and the dedicated-configuration positions DNP. One antenna instead of two (the 146187-0050 price was not recorded); the 146153-0050 is $2.27 at Digi-Key.
12. **Other gaps:** I2C3 pull-ups on FP_3V3 (G8); a strap footprint on touch INT (G9); discharge footprints on vcc3v3_wl and vcc3v3_sd (G13); `HAPTIC_EN` (G20) and `NFC_PWR_EN` on expander spare lines with pull-downs; **16 GB eMMC option Samsung KLMAG1JETD-B041** (G17, line 138). G18 (2 GB LPDDR4X and SK hynix lands) stays open.
13. **Cost and area (qty 1, est., USD):** LCSC basis ≈ +11 in `full` (TPS62826 0.80, inductor 2.35 at Mouser, INA236B 2.88, SN74LVC2G66 0.60, two SN74LVC1G57 0.38, TPS22919 0.12, shunts ≈ 4.2, passives ≈ 0.2), Mouser basis ≈ +31 (the 20 mΩ and 0.1 Ω shunts cost 1.60 and 0.44 each there); `production` ≈ 4 less (links as 0 Ω). Area ≈ 300 mm² (est.): AVDD18 stage ≈ 30 mm², gates and switch ≈ 15 mm², fifth INA236 ≈ 15 mm², links and Kelvin pads ≈ 240 mm² (pads can go on the back side). No decision, priority or requirement status changed.

## Changes in v1.7

Adds the should parts confirmed on 2026-10-23 (BRD-057 NFC, BRD-058 haptics, BRD-059 key holder), decided by Claude under the maintainers' delegation from a parts bench (primary sources, stock captured 2026-10-23). Prototypes populate every option (BRD-053).

1. **Key holder (line 122): Infineon SLB9673**, TPM 2.0 on I2C2 at 0x2E, the only I2C TPM named in mainline `tpm_tis_i2c`; ST ST33KTPM2 as second source. Secure elements (NXP SE050, Microchip ATECC608B) were not chosen: no kernel interface, vendor middleware only, whereas a TPM works with the standard Debian tooling. It backs the keystore of OS-032 (blackbird-os ADR 0013).
2. **Haptics (lines 123–124): TI DRV2605L** (mainline since v4.0 or earlier, closed loop, auto-resonance) with a **Vybronics VG1040003D** coin LRA; DRV2624/2625 have no mainline driver, CS40L50 has no stock and needs firmware outside linux-firmware.
3. **NFC (lines 125–128):** a **dynamic tag, NXP NTAG I2C plus**, for tap-to-pair: no driver, under $1, readable with the T1 off, nothing transmitting near the audio chain. The **NXP PN7160** reader is the population option for T1-to-T1 hand-off (fitted on prototypes). Mainline Linux has no NFC card emulation, so the tag is the phone path in every variant.
4. **Kernel:** Debian arm64 builds neither `TCG_TIS_I2C` nor `INPUT_DRV260X_HAPTICS`: both ship as DKMS modules or in OpenDAP's kernel configuration (OS-023) until Debian enables them; `NFC_NXP_NCI_I2C` is already `=m`.
5. **I2C2 M0 addresses** added: 0x28 (PN7160), 0x2E (TPM), 0x55 (tag), 0x5A (haptic driver); all free on that bus.
6. **Cost (qty 1, est., USD):** about +6.5 in every variant (TPM 4.55, DRV2605L 1.23, tag 0.70, plus the LRA, price not published, and the antenna); +5.5 more for the PN7160 where fitted.

## Changes in v1.6

Applies [ADR 0015](../adr/0015-amplifier-rails-from-vsys.md) (Accepted, 2026-10-22; supersedes the rail items of ADR 0012) from the [output-stage simulation](../research/2026-10-output-stage-simulation.md) §5, [ADR 0014](../adr/0014-two-cell-battery.md) item 6, and the [boost and MaskROM simulation](../research/2026-10-boost-and-maskrom-simulation.md). Stock captured 2026-10-22 (Mouser, Arrow, Newark, TME, Future, Verical through FindChips; LCSC through the JLCPCB parts API).

1. **−7 V pre-rail (new lines 116–119): TI LMR33630CRNXR** inverting buck-boost from VSYS (SNVA856B topology), with a Coilcraft XGL4020-222MEC (2.2 µH; XAL4020-222MEC second source), its capacitors and feedback, and an EN level shifter (DMG1012T-7 + DMP3099L-7, SNVA856B Figure 7-1). Simulated: 47 % of the high-side minimum limit at the full-scale peak, 55 % at the LDO current-limit case, 48 % of the voltage rating. LMR33620CRNXR is the second source.
2. **TPS65131 (lines 22–24, 111): +7 V boost only.** The inverter half is unused (ENN, PSN to GND; INN on VIN; VNEG, FBN to AGND; OUTN open; connection to confirm with TI). One DFE252012F-4R7M, one PMEG2010AEH, R3/R4, C10, CN and 4 × 4.7 µF removed. The boost runs at 56–78 % in operation and ≈ 99 % only in the positive LDOs' maximum-trip case (bench item).
3. **±6 V regulators doubled (lines 25–26, 109–110):** 2 × LT3045 and 2 × LT3094 in parallel, RSET 2 × 60.4 kΩ, CSET 2 × 0.47 µF, **RILIM 523 Ω / 13.0 kΩ** per device (pair limits 516–631 / 519–646 mA against the 457 mA peak), 20 mΩ ballast per output.
4. **Sequencing:** `HPA_RAIL_EN` enables the TPS65131 boost and, through the level shifter, the LMR33630C; `HPA_LDO_EN` follows **≥ 10 ms** later; the OPA1622 EN last (power tree §6.2).
5. **Ship FET (new line 120): TI CSD17575Q3**, the ship FET of TI's BQ25798EVM (SLUUCB5E); 27 A continuous = 6.8× the 4 A of the brief.
6. **MaskROM (lines 35, 78, 97, 98):** TPS3839G18DBZR → **TPS3808G01DBVR** on vcca1v8_pmu (280 kΩ / 100 kΩ, CT 390 nF, RESET pull-up 100 kΩ: window 1.21–3.43 s, never at resume); PWRON_N pull-up 20 kΩ → **100 kΩ**; eMMC_D0 series resistor 100 Ω → **1 kΩ**; 100 kΩ gate pull-down on the DMG1012T fitted (qty 2 → 3 with the level shifter). Consequence: MaskROM through the buttons needs a full power-off and an empty or unbootable SD slot (t1 controls spec §1.2).
7. **TPS62903 5.1 V output capacitor (new line 121):** one 22 µF with ≥ 12 µF effective at 5.1 V: Murata GRM32ER71E226KE15L (25 V X7R 1210). Phase margin at VSYS 6.0 V stays a bench item (§7 item 27).
8. **Correction, line 114:** the TPS62136 inductor peak at 2.0 A is **3.03 A** (63 % of the minimum limit, 40 % of Isat), not 2.41 A.
9. **Battery worst case (power tree §4.7):** the −7 V rail now draws from VSYS directly (2.12 W at the full-scale sine, simulated) instead of through the pre-regulator; the combined worst case falls from ≈ 20.9 W to **≈ 20.6 W, ≈ 3.1 A at VSYS 6.6 V**: the 3.2 A design point, the 5 A fuse (62 %), the 4.0 A pack criterion (78 %) and the Micro-Fit contact (62 %) all hold.
10. **§7 item 26 closed** by ADR 0015.
11. **Cost (qty 1, est., USD):** LCSC basis ≈ +24.9 (two more LDOs 15.06, LMR33630C 2.15, inductor 6.09, ship FET 1.02, the rest ≈ 1.4; removed ≈ 0.9); Mouser/Arrow basis ≈ +32.2.

## Changes in v1.5

Applies [ADR 0014](../adr/0014-two-cell-battery.md) (Accepted, 2026-10-22; supersedes ADR 0011) from the [2S battery study](../research/2026-10-battery-2s.md) §3–§4. Stock captured 2026-10-22 (Mouser, Arrow, Newark, TME and Verical through FindChips; Digi-Key from its pages; LCSC through the JLCPCB parts API). The BQ25798, BQ28Z610-R1, TPS62136 and TPS62903 figures come from their datasheets (SLUSDV2C, SLUSE07B, SLVSDV2, SLVSES3A), the inductors from Coilcraft Doc 806, 1302 and 1529, through the parts-lib spec sheets.

1. **Two-cell pack (line 46).** The T1 runs on a quoted 2S1P Li-ion pack, a T1-038 exception like the cover glass, accepted only against the ADR 0014 item 2 criteria (≥ 4.0 A continuous, PCM trip 4.0–5.0 A with balancing, lead and plug ≥ 4.6 A per pole, UN 38.3, two independent makers). The Adafruit 328 and Adafruit 2011 are removed: the Adafruit 328 is no longer a T1 pack. Bring-up uses a bench supply or a protected 2S pack on the bench.
2. **Charger (lines 39–40): BQ25895RTWR → BQ25798RQMR** (1–4S buck-boost, NVDC, 6 A continuous discharge; I2C1 at 0x6B). VSYS becomes 6.0–8.8 V. The XAL4020-102MEC stays as its 1 µH inductor (72 % of Isat at the 5 A ISW rating, ≈ 40 % at the design point). Driver: mainline `bq257xx` with the BQ25798 ID sent upstream, DKMS meanwhile (ADR 0014 item 5).
3. **Pre-regulator (new lines 113–115): TI TPS62136RGXR**, VSYS → **3.8 V VSYS_LV**, with a Coilcraft XGL4020-152MEC (1.5 µH). Every part the 1S tree fed from VSYS moves to VSYS_LV unchanged (2S study §4.2): RK809-5 VCC1–VCC4 (line 2), RK860-0 (3), TPS62826 (6), TPS65131 (22), TPS62840 (27), TPS7A2031 (29), MAX98357A (32), the DAC_VP TPS22919 (50), TPS61169 (51) and LP5521 (105). The fixed 3.8 V input removes the low-battery corner of the TPS65131 (inverter 79 % → 68 % of its minimum switch limit) and of the MCLK LDO (0.7 V headroom).
4. **HAT and USB-C 5.1 V (lines 91–92): TPS61089RNRR boost → TI TPS62903RPJR buck** (1.6 A = 53 % of 3 A), inductor XAL4020-152MEC → **Coilcraft XGL4020-102MEC**. **HAT_3V3 (lines 38, 7): TLV62569DBVR → a second TPS62903RPJR** (33 %), inductor DFE252012F-2R2M → XGL4020-102MEC. One part number for both bucks, set by a VSET resistor (5.1 V or 3.3 V).
5. **Gauge (lines 42–43, 101): MAX17055EWL+T → TI BQ28Z610DRZR-R1** (1–2S, gauge only: the pack carries protection and balancing), sense resistor RL0603FR-070R01L (10 mΩ) → **Vishay WSL12065L000FEA (5 mΩ, 0.25 W)**. Line 101 (optional MAX17055 thermistor) is removed; the board NTC (line 48) moves to the gauge TS1 and the charger TS takes the pack NTC.
6. **Battery fuse (line 104): 045102.5MRL (interim) / 0451007.MRL → Littelfuse 0451005.MRL (5 A)**, same NANO2 footprint: 3.2 A worst continuous case = 64 % (ADR 0014; a first v1.5 draft carried the 4 A 0451004.MRL, 80 % at 3.2 A).
7. **Battery connector (line 47): JST S2B-PH-SM4-TB → Molex Micro-Fit 3.0 43650-0400** (4 circuits: P+, P−, mid-cell tap, NTC; right-angle through-hole): 3.2 A worst case = 64 % of 5 A per contact (2.4 A = 48 %). The keyed plug cannot take a 1S JST-PH pack.
8. **Full output budget on battery (power tree §4.7):** 15.7 W from VSYS = **≈ 2.4 A at VSYS 6.6 V** (3.3 V per cell, the shed point), half the 1S figure; path drop ≈ 0.1 V and ≈ 0.23 W (est.). The interim output ceiling of v1.3 (power tree §4.11) is removed with a compliant pack (ADR 0014 item 3). With full-scale balanced headphones on top (≈ 3.2 A, §7 item 17) the battery path is sized for the combined worst case (ADR 0014): pack ≥ 4.0 A, PCM trip 4.0–5.0 A, lead ≥ 4.6 A per pole, 5 A fuse.
9. **Board EEPROM (line 17):** the notes said 0x57; the AT24C02D-STUM-T stays the SOT23 part at **0x50** on I2C2 (decided by the lead under delegation). The HAT ID EEPROM, also at 0x50, is on its own bus (I2C4 behind the PCA9306, line 94), so there is no conflict. This matches D1 and the §4.2 address map.
10. **Debian (§3):** `MFD_BQ257XX` and `CHARGER_BQ257XX` not set (DKMS for line 39); `BATTERY_BQ27XXX=m` but `BATTERY_BQ27XXX_I2C` not set and not overridden on arm64 (DKMS for line 42; [pre-freeze note](../research/2026-10-battery-2s-prefreeze.md)). `CHARGER_BQ25890` and `BATTERY_MAX17042` no longer apply.
11. **Cost (qty 1, est., USD):** LCSC basis: removed parts 18.26, added parts 24.27 per board, **≈ +6.0** (the removed XAL4020-152MEC is listed at 13.41 at LCSC). Mouser basis (LCSC where Mouser has no listing): removed 15.76, added 33.61, **≈ +17.9**, of which 13.60 are the three Coilcraft XGL4020 inductors at LCSC prices (no Western distributor stock found; Coilcraft direct pricing not read). The BOM carries no cost totals.

## Changes in v1.4

Applies the hat-standard [HAT interface v1](https://github.com/opendap-project/hat-standard/blob/main/docs/specs/interface-v1.md) (Draft, 2026-10-22; [ADR 0002](https://github.com/opendap-project/hat-standard/blob/main/docs/adr/0002-interface-v1-native-high-speed-management-over-usb.md), [ADR 0003](https://github.com/opendap-project/hat-standard/blob/main/docs/adr/0003-compatibility-levels.md)). The RK3566 mapping and the freed balls are in the [pin plan §4.3](../research/2026-10-pin-multiplexing-v0.md#43-mapping-to-the-hat-interface-v1). No power line changes: the HAT rails, eFuses, TVS and the DF40 power connector stay as in v1.3. No new stock was captured.

1. **HAT signal connector (line 66):** stays the 100-position DF40 pair (ADR 0002). 72 of 96 usable contacts are assigned (11 pairs + 13 grounds, 23 low-speed, 4 analog, 5 low-speed grounds, 5 reserved); 24 freed positions are spare and left unconnected.
2. **HAT pogo pins (line 67): ~128 → 96** (L3 field, 4 × 24; an L1 piece would carry 32). The P70-1000045R pad does not fit the 1.27 mm pitch the research assumed (D36).
3. **HAT high-speed ESD (line 68):** 12 → 11 pairs (the second USB 2 port is removed); still 6 TPD4E05U06, 22 of 24 channels used.
4. **HAT low-speed and analog ESD (line 69): TPD4E05U06 ×12 → ×8, TPD1E10B06 ×4 → ×2.** 29 low-speed lines (23 + `HAT_DET#` + 5 reserved) instead of 46; line in removed.
5. **HAT audio translators (line 95): 3 parts → 2.** The port runs on the DAC's clock domain with fixed directions: SN74AXC4T774 for BCLK, FS and DOUT, SN74AXC8T245 for DIN0–DIN3. **SN74AXC2T245RSWR removed** (a thin-stock part, §8 item 7).
6. **New line 112 (Open): HAT `I2S_MCLK` buffer** from the active MCLK oscillator, because the HAT clock now comes from the DAC's domain, not from a SoC I2S controller (§7 item 19).
7. **GPIO expander (line 93):** carries no HAT line any more (`GPIO5`–`GPIO7` and `CAM_RST#` removed from the interface); quantity unchanged.
8. **IO domains (§4.2):** VCCIO1 keeps HAT SWD, `HAT_RST#` and the PCIe sidebands; VCCIO7 keeps HAT I2C5; I2S2 leaves VCCIO6.

## Changes in v1.3

Applies [ADR 0012](../adr/0012-headphone-output-stage.md) (Accepted, 2026-10-22) from the [headphone output power research](../research/2026-10-headphone-output-power.md) (option A6), and closes D27 and D30 (§9). Stock captured 2026-10-22 (LCSC through the JLCPCB parts API, Western distributors through FindChips). The LT3045 and LT3094 figures now come from their datasheets (LT3045 Rev. D, LT3094 Rev. B, read through the parts-lib spec sheets).

1. **Headphone amplifiers (line 19): four → six OPA1622** (BRD-022 amended). Both halves of one package run in parallel on each balanced leg; the 3.5 mm output keeps two packages with paralleled halves. Expected (desk estimate): ≈ 240 mW SE and ≈ 640 mW balanced into 32 Ω.
2. **Gain network (lines 37, 107, 108):** one difference amplifier per half, R1 = R3 = 1.00 kΩ, R2 = R4 = 1.62 kΩ (0.1 % thin film), 100 pF C0G, gain 1.62; a 1.0 Ω ballast resistor per half outside the loop. The CS43198 runs at `+1dB_EN` = 0 (−115 dB THD+N typ instead of −105 dB).
3. **Amplifier rails (lines 22, 25, 26, 109–111): ±5.0 V → ±6.0 V.** TPS7A4901DGNR and TPS7A3001DGNR **removed** (183 % and 138 % of their ratings at the 275 mA worst continuous load); LT3045EDD#TRPBF and LT3094EDD#TRPBF at ±6.04 V (RSET 60.4 kΩ, CSET 0.47 µF, ≈ 400 mA programmed limit), 55 % of their 500 mA rating. TPS65131 pre-rails raised from ±6.0 V to ±7.0 V (R1 475 kΩ / R2 100 kΩ, R3 576 kΩ / R4 100 kΩ). This amends the rail line of ADR 0009, as ADR 0012 states.
4. **TPS65131 margin (BRD-049, power tree §4.10.1):** inverter at 72–79 % of its 1.8 A minimum switch limit (VIN 3.5–3.0 V), boost at 48–56 %. Inside the 80 % rule, at its edge at VIN 3.0 V: conditional on simulation before layout freeze (ADR 0012). New D31: the TPS65131 inductors' 2.1 A rating sits below the 2.2 A maximum switch limit.
5. **Interim battery (power tree §4.11):** the full-scale balanced 32 Ω sine draws ≈ 4.8 W from VSYS (1.61 A at 3.0 V), at the Adafruit 328's 1.6 A path budget by itself. Blackbird OS must hold the battery current at ≤ 1.6 A by limiting the headphone level while that pack is fitted (requirement for Blackbird OS).
6. **vcc3v3_sys inductor (line 106, D27): DFE252012F-R47M → Würth 744373240047** (TI-listed, 6.8 A in TI's table, IR 8.7 A and Isat 10.4 A at 10 % drop on the Würth page; Mouser 1,547, Newark 690). Line 4 keeps the DFE252012F-R47M for vdd_cpu only (qty 2 → 1).
7. **Quiescent cost:** the SE output's headphone rails draw ≈ 256 mW from VSYS at idle instead of ≈ 180 mW (+76 mW); the balanced output ≈ 464 mW (power tree §4.9). Board area ≈ +80–110 mm² (est., research §4.5).

## Changes in v1.2

Power margin rule used here (BRD-049): continuous load ≤ 80 % of the rating for converters, regulators, switches and fuses (fuses ≤ 75 %), ≤ 70 % for connector contacts with all contacts loaded; the worst-case trip of the protecting current limiter ≤ 100 % of the rating. The full check is in [power tree §4.10](power-tree-v0.md#410-power-margin-check-bom-v12). Stock captured 2026-10-22 (LCSC through the JLCPCB parts API, Western distributors through FindChips).

1. **vcc3v3_sys buck (line 6): TLV62569DBVR (2 A) → TI TPS62826DMQR (3 A)**, 2.4–5.5 V in, 100 % duty cycle, power-good output (SLVSEF9I). Peak 1.85 A (est.) is 62 % of 3 A and the inductor peak 2.25 A is 61 % of its 3.7 A minimum switch limit; v1.1 ran at 80–90 % of the TLV62569. LCSC C2073319: 17,032; Mouser 7,156. The pin- and BOM-compatible TPS62827DMQR (4 A) is the drop-in if the schematic re-sum exceeds 2.4 A. Its 0.47 µH inductor is the DFE252012F-R47M already on line 4 (TI's recommended L–C matrix); the TPS62A03 fallback is dropped (thin stock).
2. **HAT power connector (line 66): DF40C-30 → DF40C-50 pair** (46 usable contacts). At 0.3 A per contact the 30-pin could not carry `HAT_5V` and `HAT_3V3` with their returns at 70 % (HAT_3V3 sat at 96 % of four contacts at its eFuse ceiling). The allocation (HAT_5V ×12, HAT_3V3 ×6, GND ×22, HAT_DET# ×1, reserved ×5) now comes from the hat-standard [HAT interface v0](https://github.com/opendap-project/hat-standard/blob/main/docs/specs/interface-v0.md) (Draft). DF40C-50DP: Mouser 32,399; DF40C-50DS: Mouser 14,705, Future 45,000.
3. **HAT signal connector (line 66): 2 reserved contacts** (HCS-022) by dropping `CAM_PWDN` (expander line freed, line 93) and the optional HAT output on the DAC clock (one AXC bit freed, line 95). Contact positions are owned by the hat-standard spec; the board maps the RK3566 onto it ([pin plan §4.3](../research/2026-10-pin-multiplexing-v0.md#43-mapping-to-the-hat-interface-v1)).
4. **Battery (lines 46–47) and new board fuse (line 104):** [ADR 0011](../adr/0011-battery-path-rated-for-the-full-output-budget.md) (Proposed) defines the full output budget on battery (4.8 A from the cell at VSYS 3.3 V) and the pack acceptance criteria (≥ 6 A continuous, PCM trip ≥ 6 A, lead and connector ≥ 6.9 A per pole). **No stocked pack meeting them was found**, so the Adafruit 328 stays as the interim pack with the 1.6 A budget, now backed by a 2.5 A fuse; BRD-050 is not met yet (§7 item 3).
5. **Battery-path parts sized for the full budget:** BQ25895 6 A continuous discharge checked (80 %); input current limit capped at 15 W and 2.0 A (line 39); TPS2121 current limit set to 2.0–3.0 A (line 45); VSYS shunt ≥ 1 W (line 54); gauge sense resistor sized per pack (line 43).
6. **TPS61089 current limit (lines 91–92):** the datasheet allows the limit to sit 0.8 A below the calculated value (SLVSD38C §9.2.2.3), so 200 kΩ gives 4.35 A minimum, not 4.6 A; the 3.7 A peak was 85 % of it. RILIM 200 kΩ → **182 kΩ** (5.66 A typ, 4.86 A min): peak at 76 %.
7. **Status LED (lines 79, 105): RGB** (FPT-025). Everlight 19-337/R6GHBHC-A01/2T (red AlGaInP, green and blue InGaN, VF ≤ 3.8 V at 20 mA) on the faceplate, driven from the board by a **TI LP5521** I2C RGB driver whose 1.5× charge pump keeps the LED supply at ≥ 4.29 V down to VSYS = 3.0 V (0.29 V margin over the maximum VF and driver saturation at 20 mA). Mainline `leds-lp5521` (DKMS on Debian). The faceplate connector carries LED_R, LED_G, LED_B (2 spares used, 5 left, line 71). The yellow-green v1.1 part is withdrawn.
8. **HP-amp +5 V LDO (line 25): margin finding.** The worst continuous sine (balanced, 32 Ω, both channels, 122 mA) is 81 % of the TPS7A4901's 150 mA. Proposed fix: the LT3045 (500 mA) with its negative twin LT3094 (500 mA) for matched soft-start, both stocked; **pending** their datasheet review (ADI PDFs not retrieved this session) and the maintainers' confirmation, because it touches the audio stage (§7 item 13).
9. **MaskROM gate input (lines 78, 98):** the SN74LVC1G57 low threshold is guaranteed only below 0.35 V at 1.65 V; behind the BAT54 (0.24–0.32 V) the margin is 30–110 mV. The PWRON_N pull-up is set to **20 kΩ** to vcca1v8_pmu (≈ 0.09 mA), which keeps the diode current near 0.1 mA, where the 0.24–0.32 V drop applies.
10. **Debian config re-check:** `GPIO_PCA953X=y` (line 93, was **UNVERIFIED**); `LEDS_LP55XX_COMMON`, `LEDS_LP5521` not set (DKMS).

## Changes in v1.1

Evidence per item in §9. Stock captured 2026-10-22 (LCSC through the JLCPCB parts API, Western distributors through FindChips or their own pages).

1. **RK809-5 rail map re-derived (D19)** from the Radxa ROCK 3C v1.4 schematic, whose PMIC is marked RK809-5, and the mainline device trees of three RK3566 + RK809 boards. VCC5–VCC9 (LDOs, BUCK5, both switches) are fed from vcc3v3_sys, which becomes always-on (TLV62569 EN tied to VSYS, EXT_EN unused); VCC1–VCC4 (BUCK1–4) from VSYS. SWOUT1 is 1.5 A (IW612), SWOUT2 3 A (microSD). The RK809-5 OTP defaults remain unpublished.
2. **HAT/USB 5 V boost (D18): TPS61088 → TPS61089RNRR** (line 91). ti.com no longer has a TPS61088 product page or datasheet; the TPS61089 is active and stocked.
3. **MCLK supply (D5): TPS7A2033 → TPS7A2031PDBVR (3.1 V)** (line 29), inside the NSC5083D 2.97–3.63 V supply range with 0.4 V headroom at 3.5 V. ADR 0010 amended accordingly. Pull-downs on both ST pins.
4. **RP2354A supplies and clock (D6):** RP_3V3 feeds VREG_VIN, VREG_AVDD, QSPI_IOVDD, USB_OTP_VDD and ADC_AVDD; RP_IOVDD_1V8 feeds IOVDD only. The crystal (line 14) is replaced by a 1.6–3.6 V 12 MHz oscillator on RP_IOVDD_1V8 into XIN.
5. **HAT translator with OE (D8): SN74AXC2T45DCUR → SN74AXC2T245RSWR** (line 95).
6. **MaskROM gate (D10): SN74LVC1G27 → SN74LVC1G57 + SN74LVC1G58** (Schmitt-trigger inputs) (line 98); window specified as 120–350 ms.
7. **HAT 100-pin allocation (D12):** HAT_DET# moves to the 30-pin power connector; 96 of 96 usable contacts on the 100-pin, 25 of 26 on the 30-pin.
8. **Display driver (D14):** mainline has a DSI driver for this exact panel (`panel-ilitek-ili9488`, compatible `focuslcds,e35gh-i-mw800cb`) since v7.3; DKMS on Debian's 7.2. The E35GH stays.
9. **Touch connector (D15):** the Focus drawing gives the CTP tail as 6 contacts, 0.5 mm pitch, 3.50 mm wide, 0.30 mm thick, which is the FH12-6S FPC geometry.
10. **Status LED (D16):** Everlight 19-217/GHC (InGaN green, VF up to 3.7 V) → **19-217/G7C-AN1P2/6T** (AlGaInP yellow-green, VF ≤ 2.4 V) (line 79).
11. **ESD arrays (D17):** TPD6E05U06RVZR (no package drawing in its datasheet) → **TPD4E05U06DQAR** (lines 69, 73, 75); HAT line-level audio on bidirectional TPD1E10B06.
12. **Battery path derated (D24): 2.0 A → 1.6 A continuous** (est.) until JST or Adafruit confirm the PH rating with 26 AWG leads.
13. **Backlight rectifier (D25): PMEG4010CEH → PMEG6010CEH** (60 V, same SOD123F land) (line 53).
14. **HP-amp LDO soft-start (D3)** sized in lines 25–26; **TPS2121 OV1 and thermal (D21)** in line 45.

## 0. Changes from the draft

Full evidence and severity in the [cross-validation report](../research/2026-10-bom-v1-cross-validation.md) §2.

1. **MCLK oscillators (lines 20, 21): decided in [ADR 0010](../adr/0010-audio-master-clock-source.md)** (stocked 3.3 V NDK NSC5083D on a dedicated LDO, passive attenuator into the 1.8 V XTI input). The 1.8 V NSC5083A has no authorized stock, and no stocked audio-grade 1.8 V oscillator exists at 22.5792 MHz.
2. **Battery (line 46) follows ADR 0007:** Adafruit 328 primary, Adafruit 2011 second source. The quoted 105060 pack is removed (T1-038). The 2-pin JST PH connector (line 47) is the single footprint; the board NTC stays.
3. **Battery current budget:** the pack (2C max) and its JST PH lead (2 A per contact) cap the battery path at 2.0 A continuous. VSYS is no longer rated 3.5 A on battery; HAT and USB-C source power on battery are software-budgeted (power tree §4.6).
4. **New HAT/USB 5 V boost (new line 91, TPS61088):** the BQ25895 cannot run OTG while it is charging, so the draft could not power a class A/B HAT while USB-C is plugged in. HAT 5 V and USB-C source power now come from a VSYS boost behind the eFuses.
5. **TPS2121 input isolation (line 45):** both OV inputs are driven during any 5 V sourcing, otherwise the T1's own 5 V re-enters the charger through IN1 or IN2.
6. **vdd_cpu buck (line 3): RK860-2 → RK860-0**, the variant on the RK3566 reference (Radxa ZERO 3W), with better stock (LCSC 4,528).
7. **IO domains corrected to the pin plan:** PMUIO2 (I2C0/1/2) at 1.8 V, faceplate bank VCCIO5 at 3.3 V. The draft §4.2 had I2C0 at 3.3 V and the faceplate at 1.8 V, which contradicts the pin plan and the DAC's 1.8 V-only I2C on the same PMUIO2 bank.
8. **Faceplate connector: FH35C-45S → FH35C-51S** (44 used + 7 spare = 14 %, ADR 0006), stocked at Mouser.
9. **HAT flat cable (line 66) picked:** Hirose DF40 0.4 mm board-to-FPC pair, 100-pin signal + 30-pin power, stocked in thousands.
10. **Missing parts added:** GPIO expander TCA6416A, HAT ID translator PCA9306, HAT audio translators (SN74AXC8T245, SN74AXC4T774, SN74AXC2T45), MaskROM combo circuit (TPS3839 + SN74LVC1G27 + BAT54 + DMG1012T), faceplate load switch FP_3V3, panel RST/TE translators on the faceplate, 4.4 mm fallback jack as primary.
11. **ESD counts corrected:** faceplate DSI + low-speed and HAT low-speed lines were under-counted.
12. **4.4 mm jack (line 31):** the stocked G-Switch part becomes primary (T1-029); genuine Pentaconn stays a quoted upgrade.
13. **Second sources removed when incompatible:** INA226 (I2C VIH too high for a 1.8 V bus), Alps/Panasonic side switches against a top-actuated primary.
14. **Item tracking (BRD-030) has no hardware line yet:** new *Open* line 103.

## 1. What changed from v0

1. **Master clocks: 45.1584/49.152 MHz → 22.5792/24.576 MHz, 1.8 V.** The CS43198 accepts an external MCLK only at 22.5792 or 24.576 MHz (DS1156F2 Table 4-3), and its XTI/MCLK input is in the 1.8 V VL domain (VL 1.66–1.94 V). BRD-023 is corrected (Confirmed). See power tree §1.
2. **Battery line replaced** by the off-the-shelf Adafruit 328 (ADR 0007). The v0 Jauch LP705176JS fits no envelope.
3. **HAT pogo pins move to the device-side piece** (board ADR 0002, flat cable). The board now carries the flat-cable connector instead; the pogo line is kept for traceability.
4. **eFuses ×2 → ×3:** a third TPS259470 limits and protects the USB-C VBUS source path (OTG host).
5. **New support parts** around every main IC: vdd_cpu buck, LPDDR4X 0.6 V LDO, external 3.3 V buck, audio rails (TPS65131, TPS7A4901, TPS7A3001, TPS62840, TPS7A2018), 5 V boost, load switches, backlight driver, current monitors, ESD/TVS, translators, GPIO expander, crystals, inductors, connectors, buttons and test access.

## 2. Bill of materials

### 2.1 Core

| # | Subsystem | Function | Part (MPN) | Qty | Status | Driver path | Availability (best source, stock, date) | Second source | Notes |
|---|---|---|---|---|---|---|---|---|---|
| 1 | Core | SoC | Rockchip RK3566 | 1 | Decided (ADR 0003) | mainline + Debian | LCSC C2943786: 637 @ $14.60 (2026-10-22); not at Western catalog distributors | Upgrades: RK3576, i.MX 8M Plus | v0 #1 |
| 2 | Core | PMIC | Rockchip RK809-5 | 1 | Proposed | mainline + Debian (`rk8xx`, `rk808-regulator`, `rtc-rk808`, `clk-rk808`) | LCSC C2939628: 1,226 @ $2.47; RK809-5A C20417421: 631 (2026-10-22) | RK817-5 (LCSC 70) | v0 #2. v1.1 rail map from the Radxa ROCK 3C v1.4 schematic (RK809-5) and the mainline Orange Pi 3B, ROCK 3C and ODROID-M1S device trees (power tree §3): VCC1–VCC4 (BUCK1–4) from VSYS (v1.5: VSYS_LV 3.8 V, line 113; the 2.7–5.5 V input cannot take a 2S VSYS), VCC5–VCC9 (LDO1–9, BUCK5, SWOUT1, SWOUT2) from vcc3v3_sys. RK809-5 OTP defaults **UNVERIFIED** (not public). Codec and class-D unused (RK817 codec driver is Debian `=m`, an option for the speaker) v1.9 (pinout v1 B12; HDG p. 73): codec unused: MCLK, BCLK, LRCLK, SDI, PDMCLK and HP_SNS tied to ground; SDO/PDMDATA, CPn/CPp, VCC_CPVDD/CPVSS, HPL/HPR_OUT, SPK_OUTn/p and MIC1p/n may float. SWOUT1 is unused from v1.9 (radio AVDD33 moves to a TPS22919, line 50). |
| 3 | Core | vdd_cpu buck (I2C DVS) | Rockchip RK860-0 | 1 | Proposed (changed: was RK860-2) | mainline + Debian (`fan53555`, `rockchip,rk8600`, `REGULATOR_FAN53555=m`) | LCSC C19188628: 4,528 (2026-10-22) | RK860-2 (LCSC C5156489: 2,999; `rockchip,rk8602`, different OTP default and register map, **UNVERIFIED** for RK3566); Silergy SYR827PKC (Orange Pi 3B, same driver, LCSC 852) | RK860-0 is the RK3566 reference part (Radxa ZERO 3W). On I2C0 (1.8 V) at 0x40 (**UNVERIFIED**, datasheet not public). OTP boot voltage must match the RK3566 vdd_cpu default v1.5: VIN from VSYS_LV 3.8 V (line 113), inside the 3.5–4.4 V range the T1 uses for it (device rating **UNVERIFIED**). |
| 4 | Core | vdd_cpu inductor | Murata DFE252012F-R47M (0.47 µH) | 1 | Proposed (v1.3: qty 2 → 1; the TPS62826 inductor moves to line 106, D27) | none | LCSC C703140: 1,283; Arrow 4,460 (2026-10-22) | TDK TFM252012ALMAR47MTAA, Changjiang FPA252012D-R47MT0 (LCSC 2,671) | vdd_cpu: value and saturation current to confirm against the RK860 datasheet (**UNVERIFIED**). v1.2 also used it on vcc3v3_sys; it is rated 4.9 A (ΔT 40 °C), below the TPS62826's 5.0 A maximum switch limit, and is not on TI's list (D27) |
| 5 | Core | PMIC buck inductors (BUCK1–5) | Murata DFE252012F-R47M (0.47 µH) | 5 | Proposed | none | as line 4 | as line 4 | RK809 datasheet application circuit: 0.47 µH, 4 A (BUCK1, 2, 5) and 3 A (BUCK3, 4). Murata saturation rating against 4 A **UNVERIFIED** |
| 6 | Core | 3.3 V system buck (vcc3v3_sys, always on: RK809 VCC5–VCC9, eMMC, RP2354A, FP_3V3, radio AVDD33 switch) | TI TPS62827DMQR (4 A, VSON-HR 1.5 × 1.5 mm) | 1 | Proposed (v1.2: TLV62569DBVR → TPS62826DMQR; v1.9: TPS62826DMQR → TPS62827DMQR, re-sum past 80 %) | none | Mouser 11,779 @ $1.62; LCSC C2071448: 592 @ $1.21 (2026-10-24) | TI TPS62826DMQR (3 A, same land and pins; only while the summed peak stays ≤ 2.4 A) | v1.9 (BRD-049, power tree §4.10): estimated peak **2.45 A** (BUCK5 input 0.40, RK809 LDOs 0.30, radio AVDD33 1.05, SWOUT2 0.20, eMMC 0.25, haptic driver 0.10, rest 0.15) = 82 % of the TPS62826's 3 A, **61 %** of 4 A. Inductor peak 2.45 + 0.21 A (half the 0.42 A ripple at VIN 3.8 V, 0.47 µH, 2.2 MHz; SLVSEF9I Eq. 6) = 2.66 A = 55 % of the 4.8 A minimum high-side limit (SLVSEF9I p. 6); the 6.4 A maximum limit is 94 % of TI's 6.8 A figure for the line 106 inductor (≤ 100 % limiter rule). TPS62827 differences (SLVSEF9I pp. 4–6, 13–14): VIN ≥ 2.5 V (VSYS_LV is 3.8 V); soft start 1.75 ms instead of 1.25 ms (first power-up only); COUT ≥ 20 µF effective: the 22 µF + 10 µF of D26 stays, effective value at 3.3 V on the maker's curve at schematic capture (**UNVERIFIED**). 100 % mode holds 3.3 V at 2.45 A down to VIN = 3.3 + 2.45 × (26 + 14) mΩ = 3.40 V (Eq. 3, 14 mΩ maximum inductor DCR, D34), below VSYS_LV. 4 µA Iq, PG output. EN tied to VSYS_LV (always on). Inductor on line 106. Playback load ≈ 0.15 A (est.). Before v1.9: TPS62826DMQR (v1.2–v1.8) at an estimated 1.85 A (v1.2) and 2.35 A (v1.8) peak |
| 7 | Core | HAT 3.3 V buck inductor (line 38) | Coilcraft XGL4020-102MEC (1.0 µH, 4.0 × 4.0 × 2.1 mm) | 1 | Proposed (v1.5: DFE252012F-2R2M → XGL4020-102MEC, follows line 38) | none | LCSC C5357696: 1,146 @ $4.07; Digi-Key 0 (2026-10-22) | Coilcraft XAL4020-102MEC (same value and land pattern, Isat 8.7 A at 30 % drop; the line 40 part) | v1.5. TPS62903 nominal inductor 1 µH; the XGL4020-102ME is in TI's list (SLVSES3A §8.2.2.4, Table 8-4). Coilcraft Doc 1529-1: DCR 8.2 / 9.0 mΩ (typ / max), Isat 3.8 / 6.3 / 8.8 A at 10 / 20 / 30 % drop, Irms 8.8 A (20 °C rise). Peak at the 1.15 A eFuse ceiling, VIN 8.8 V, L −20 %, 2.5 MHz: 1.15 + 0.52 = 1.67 A = 19 % of 8.8 A. The 5.5 A maximum high-side limit plus the 50 ns propagation overshoot (SLVSES3A Eq. 2, ≈ 5.7 A at VIN 8.8 V) is 65 % of 8.8 A, so a short does not saturate it |
| 8 | Core | LPDDR4X 4 GB | Samsung K4UBE3D4AB-MGCL | 1 | Proposed | none (rkbin DDR blob ≥ v1.26) | LCSC C5827966: 236 @ $82.09 (2026-10-22) | SK hynix H9HCNNNCPMMLXR-NEE. **Risk:** broker prices, low stock | v0 #3 |
| 9 | Core | LPDDR4X VDDQ 0.6 V LDO | TI TPS7A1006PDSER | 1 | Proposed | none | LCSC C2863706: 1,030 @ $0.48; Mouser 5,135 (DSE) / 11,485 (PDQNR) (2026-10-22) | TI TPS7A1006PDQNR (X2SON) | VIN = vcc_ddr 1.1 V, BIAS = vcc_1v8. Need from Radxa ZERO 3W v1.12 DDR table (LPDDR4X VDDQL 0.60 V); current **UNVERIFIED** v1.8 (E1.12): **BIAS moves from vcc_1v8 to vcc1v8_ddr** (= vcca1v8_pmu, line 132): vcc_1v8 is off in suspend, and without BIAS the 0.6 V VDDQ would drop during self-refresh (power tree §4.8). BIAS needs ≥ VOUT + 1.05 V = 1.65 V for full regulation (SBVS314B §9): met at 1.8 V. EN stays tied to vcc_ddr. Measurement link 20 mΩ (line 137). Block `blk.lpddr4x`; fitted in every variant |
| 10 | Core | eMMC 32 GB | Samsung KLMBG2JETD-B041 | 1 | Proposed | none | LCSC C5821038: 270 @ $40.33; C2803245: 490 @ $45.04 (2026-10-22) | Micron, Kioxia, Longsys FORESEE. **Risk:** one stocked brand | v0 #4 v1.8: 16 GB option on line 138 (G17) |
| 11 | Core | microSD socket | Hirose DM3AT-SF-PEJM5 | 1 | Proposed | none | LCSC C114218: 15,961 @ $1.39; Digi-Key 77,167 (2026-10-21) | Molex 104031-0811 | v0 #5. VDD from RK809 SWOUT2 (3 A switch, VCC8 = vcc3v3_sys), signalling from LDO5 (1.8/3.3 V) |
| 12 | Core | Coprocessor | Raspberry Pi RP2354A (RP2350 with flash) | 1 | Decided family (ADR 0004); part Proposed | none (flashed from Blackbird OS) | LCSC C41378174: 8,021 @ $1.26 (2026-10-22) | RP2350A + QSPI flash | v0 #6. IOVDD at 1.8 V (RP_IOVDD_1V8) so it can tap the 1.8 V I2S lines without translators. v1.1: QSPI_IOVDD (internal flash), USB_OTP_VDD, VREG_VIN with VREG_AVDD (ramp together), and ADC_AVDD on RP_3V3 (DS Table 1688, §6.1.8). Firmware sets bank-0 VOLTAGE_SELECT = 1 at boot (DS §6.1.1) v1.9 (pinout v1 C6, C20, B15): BOOTSEL is the QSPI chip select, powered from QSPI_IOVDD = RP_3V3; the SoC pulls it low through an N-FET (DMG1012T-7, line 35) whose gate is `RP_BOOTSEL_DRV` (GPIO3_C6, 1.8 V), so no 3.3 V reaches a 1.8 V ball. RUN has a 4.7 kΩ pull-up to RP_IOVDD_1V8 and the SoC pulls it low (GPIO4_C1, open drain). UART0 and `RP_IRQ` use FT GPIO0–25. |
| 13 | Core | RP2350 core-regulator inductor | Abracon AOTA-B201610S3R3-101-T (3.3 µH) | 1 | Proposed | none | LCSC C42411119: 634; Newark 17,400; Verical 87,000 (2026-10-22) | none (Raspberry Pi requires this polarity-marked part) | Hardware design with RP2350, §"Core voltage regulator" |
| 14 | Core | RP2350 12 MHz clock (oscillator into XIN) | ECS ECS-2016MV-120-BN-TR (2016, 12 MHz, ±50 ppm, 1.6–3.6 V) | 1 | Proposed (changed: was the ABM8-272-T3 crystal) | none | Mouser 1,063 (-TR) + 561 (-TR3); Verical 6,000 (-TR3); LCSC C17414649: 7 (2026-10-22) | ABM8-272-T3 crystal with a re-tuned XOUT resistor, after qualification over temperature (HDG §4) | v1.1 (D6): the Raspberry Pi crystal circuit is tuned for IOVDD = 3.3 V only (HDG §4.1). The XO runs from RP_IOVDD_1V8 and drives XIN (1–50 MHz square wave allowed, DS Table 1686); XOUT open; tri-state pin open (active) |
| 15 | Core | SoC 24 MHz crystal | YXC X322524MOB4SI (3225, 24 MHz) | 1 | Proposed | none | LCSC C70590: 45,538 @ $0.09 (2026-10-22) | YXC XL2EL89COI-111YLC-24M (LCSC 14,700) | Load capacitance per the RK3566 hardware design guide (**UNVERIFIED**, guide not retrieved) |
| 16 | Core | RTC 32.768 kHz crystal (RK809) | Seiko SC-32S 32.768 kHz 20 ppm, 7 pF | 1 | Proposed | none | LCSC C97604: 133,710 @ $0.19 (2026-10-22) | SC-32S 12.5 pF (LCSC 103,834); Epson FC-135 (LCSC 0) | Load capacitance to match the RK809 oscillator (**UNVERIFIED**) |
| 17 | Core | Board-ID / calibration EEPROM (2 kbit) | Microchip AT24C02D-STUM-T | 1 | Proposed | mainline + Debian (`at24`, `EEPROM_AT24=m`) | Mouser 23,696; LCSC C79996: 8,212 (2026-10-22) | ST M24C02-RMN6TP (SO-8, different footprint) | On I2C2 (1.8 V; AT24C02D runs 1.7–3.6 V) at **0x50**: the SOT23 part has no A0–A2 pins and answers only at 0x50 (D1). v1.5: kept in SOT23 at 0x50, because the HAT ID EEPROM (also 0x50) sits on its own bus, I2C4 behind the PCA9306 (line 94), so the two never share a bus. Board revision, serial, headphone-output trim; not used for faceplate ID (T1-020) v1.8 (G19): VCC from vcca1v8_pmu (always on, like the I2C2 pull-ups), so the EEPROM is never unpowered on a live bus |

### 2.2 Audio

| # | Subsystem | Function | Part (MPN) | Qty | Status | Driver path | Availability (best source, stock, date) | Second source | Notes |
|---|---|---|---|---|---|---|---|---|---|
| 18 | Audio | DAC ×2 (dual mono) | Cirrus Logic CS43198-CNZR | 2 | Decided family (ADR 0001); part Proposed | DKMS (`SND_SOC_CS43130` off in Debian) | LCSC C1554755: 346 @ $5.38 (2026-10-22); Digi-Key 471 @ $18.19 (2026-10-21) | None. DSD128 cap in the driver (blackbird-os ADR 0006) | v0 #7. Rails: VA, VCP, VD, VL 1.8 V; VP 3.0–5.25 V; 26.1 mW each in playback |
| 19 | Audio | Headphone amp ×6 | TI OPA1622IDRCR | 6 | Proposed (v1.3: 4 → 6, ADR 0012) | none | LCSC C2876559: 673 @ $3.03; Mouser 1,952 @ $4.14 (2026-10-22); Digi-Key 4,558 (2026-10-21) | None | v0 #8. ADR 0012 (BRD-022 amended): every package runs both halves in parallel, each half its own difference amplifier (line 37) driving the output through a 1.0 Ω ballast resistor outside the loop (line 107). 4.4 mm: one package per leg (L+, L−, R+, R−), 4 packages; 3.5 mm: one package per channel, 2 packages. EN per output: 8 halves enabled for balanced, 4 for SE; a disabled package's outputs are not high-impedance (SBOS727B §7.4.1). Expected (desk estimate, research §5.2): ≈ 240 mW SE and ≈ 640 mW balanced (490–760 mW) into 32 Ω. Current sharing between paralleled halves and stability with the ballast resistors **UNVERIFIED** until simulated and measured (research §6). 673 at LCSC covers ≈ 110 boards; Western stock is the volume source |
| 20 | Audio | MCLK 44.1 kHz family: 45.1584 MHz, divided by two to 22.5792 MHz (line 139) | NDK NSC5083D-45.158M (NZ2520SDA, 3.3 V), [ADR 0019](../adr/0019-master-clock-divided-from-twice-the-frequency.md) | 1 | Decided (ADR 0019; amends ADR 0010) | none | Digi-Key 2,741 @ $2.94; LCSC C17523715: 0 (2026-10-24, ADR 0019) | A 3.3 V CMOS tri-state oscillator at 45.1584 MHz meeting the §4.3 criteria (none qualified) | v1.9: replaces NSC5083D-22.5792M (ADR 0010, v1–v1.8). On MCLK_3V1 (3.1 V). Both oscillators share one net, 33 Ω in series at each output, 100 kΩ pull-down at the dividers (line 140); one runs at a time, ST pulled down so both are tri-stated from power-up. Net load 13.7 pF against the 15 pF rating ([`sim/mclk-divider`](../../sim/mclk-divider/README.md)). The 40–60 % symmetry no longer reaches the DAC: the divider sets the duty. NDK catalogues phase noise at 49.152 MHz, not at 45.1584 MHz, and the exact 45.1584 MHz value is shown by Digi-Key ("45.158 MHz"), not by an NDK document (**UNVERIFIED**, ADR 0019). **Stock:** Digi-Key only |
| 21 | Audio | MCLK 48 kHz family: 49.152 MHz, divided by two to 24.576 MHz (line 139) | NDK NSC5083D-49.152M (NZ2520SDA, 3.3 V; −158 dBc/Hz at 1 kHz, −172 dBc/Hz at 100 kHz, 43 fs 12 kHz–20 MHz), [ADR 0019](../adr/0019-master-clock-divided-from-twice-the-frequency.md) | 1 | Decided (ADR 0019; amends ADR 0010) | none | Digi-Key 3,404 @ $2.94; LCSC C17466132: 31 @ $5.77 (2026-10-24, ADR 0019) | As line 20 | v1.9: replaces NSC5083D-24.576M. Same 2520 land and net as line 20. After an ideal division by two: −164 / −178 dBc/Hz at 1 kHz / 100 kHz (ADR 0019, `sim/mclk-divider/budget.py`). **Stock:** thin at LCSC |
| 22 | Audio | HP-amp +7.0 V pre-rail (boost half only; v1.6) | TI TPS65131RGER | 1 | Proposed (v1.3: ±6.0 → ±7.0 V, ADR 0012; v1.6: boost half only, [ADR 0015](../adr/0015-amplifier-rails-from-vsys.md)) | none | LCSC C87663: 2,826 @ $2.88; Mouser 2,182; Arrow 2,175 (2026-10-22) | No pin-compatible part | v1.6 (ADR 0015): makes **AUDIO_P7V0 only**, from VSYS_LV (3.8 V, line 113); −7 V comes from the LMR33630C (line 116). Boost: 1 µA shutdown, PSP power-save; divider and output capacitors on line 111. The full-scale sine makes each rail draw a full-wave rectified current with a **433 mA peak** (≈ 288 mA average), not the 275 mA average of v1.3 ([output-stage simulation](../research/2026-10-output-stage-simulation.md) §2–§3). Boost switch at **56–78 %** of the 1.8 A minimum limit in operation; ≈ 99 % (worst-case parameters) only when the positive LDO pair trips at its maximum limit (0.65 A), inside the ≤ 100 % rule for a limiting case: bench confirmation before freeze (ADR 0015). **Inverter half unused** ([output-stage simulation](../research/2026-10-output-stage-simulation.md) §5.5): ENN and PSN to GND (PMOS off, no DC path, SLVS493E §7.3.4), INN on VIN with its input capacitor, VNEG and FBN to AGND, OUTN open; L2, D2, its output capacitors, R3/R4, C10 and CN not fitted. SLVS493E gives no single-output connection: **UNVERIFIED**, confirm with TI before layout. v1.3–v1.5 inverter figures (72–79 %, then 68 %) are superseded: the simulation found 1.82 A peak = 101 % at full-scale peaks |
| 23 | Audio | TPS65131 boost inductor | Murata DFE252012F-4R7M (4.7 µH) | 1 | Proposed (v1.6: qty 2 → 1, inverter half unused, ADR 0015) | none | LCSC C668313: 5,837; Mouser 11,601 (2026-10-22) | TDK VLS/TFM 4.7 µH 2520 | Datasheet example uses 4.7 µH. Boost only from v1.6. The 2.2 A maximum switch limit exceeds the 2.1 A (−30 %) rating (D31): at the boost's limiting case (≈ 99 % of the 1.8 A minimum, line 22) the inductor runs near −30 % inductance; bench item with line 22 |
| 24 | Audio | TPS65131 boost rectifier | Nexperia PMEG2010AEH (20 V, 1 A) | 1 | Proposed (v1.6: qty 2 → 1, inverter half unused, ADR 0015) | none | LCSC C110921: 12,200 (2026-10-22) | onsemi MBRM120LT1G (datasheet example, LCSC 15,827) | v1.6: 288 mA average (full-scale sine, [output-stage simulation](../research/2026-10-output-stage-simulation.md)) = 29 % of 1 A; the boost diode sees ≤ 7 V reverse. Ratings from the MPN and listing (datasheet not downloaded, HTTP 403) |
| 25 | Audio | +6.0 V HP-amp LDOs (HPA_P6V0), two in parallel | ADI LT3045EDD#TRPBF (500 mA, DFN-10 3 × 3 mm) | 2 | Proposed (v1.3: TPS7A4901DGNR → LT3045EDD#TRPBF, ADR 0012, D30; v1.6: qty 1 → 2, ADR 0015) | none | LCSC C514420: 3,143 @ $7.41; Arrow 7 (2026-10-22). Two per board: LCSC covers ≈ 1,570 boards | None with authorized stock in the same footprint. Removed: TI TPS7A4901DGNR | LT3045 Rev. D, paralleled as the datasheet describes (p. 21, Figure 7): SET pins tied, RSET 2 × 60.4 kΩ (200 µA × 30.2 kΩ = 6.04 V), CSET 2 × 0.47 µF (tSS ≈ 65 ms, unchanged), IN tied, each OUT through a **20 mΩ ballast** (PCB trace, per the datasheet; better than 20 % sharing at full load). **RILIM 523 Ω per device** → 287 mA nominal, 258–315 mA (est. ±10 %); pair limit **516–631 mA** against the 457 mA design peak (OPA1622 clip point, +13 %) ([output-stage simulation](../research/2026-10-output-stage-simulation.md) §5.3, lines 109–110). Per device: 165 mA continuous (33 % of 500 mA), 315 mA at the maximum trip (63 %). Headroom at the peak, worst corner: 0.50 V against ≤ 350 mV maximum dropout (+0.15 V, §5.4). ≈ 0.20–0.25 W per device → +7 to +9 °C (θJA 34 °C/W). Noise falls by √2. Exposed pad = GND. EN/UV 1.24 V threshold, driven by `HPA_LDO_EN` |
| 26 | Audio | −6.0 V HP-amp LDOs (HPA_N6V0), two in parallel | ADI LT3094EDD#TRPBF (−500 mA, DFN-12 3 × 3 mm) | 2 | Proposed (v1.3: TPS7A3001DGNR → LT3094EDD#TRPBF, ADR 0012, D30; v1.6: qty 1 → 2, ADR 0015) | none | LCSC C670493: 1,417 @ $7.65; LT3094EDD#PBF: LCSC C670492: 533, Mouser 3,665 @ $9.66 (2026-10-22) | LT3094EDD#PBF (same part, tube). Removed: TI TPS7A3001DGNR | LT3094 Rev. B, paralleled as the datasheet describes (p. 25, Figure 15): SET tied, RSET 2 × 60.4 kΩ → −6.04 V, CSET 2 × 0.47 µF, IN tied, each OUT through a **20 mΩ ballast**. **RILIM 13.0 kΩ per device** → 288 mA nominal, 260–323 mA (−10 / +12 %, est.); pair limit **519–646 mA** (+14 % over 457 mA); ILIM must not float. Per device: 165 mA continuous (33 %), 323 mA at the maximum trip (65 %). Headroom at the peak, worst corner 0.65 V against ≈ 350 mV dropout (+0.30 V, [output-stage simulation](../research/2026-10-output-stage-simulation.md) §5.4). PSRR ≈ 68 dB at the LMR33630C's 1.8–2.4 MHz (curve G47). **Exposed pad is IN (−7 V)**, not ground. Positive EN/UV threshold 1.26 V, so `HPA_LDO_EN` drives it directly. VIOC floated. Same tSS law as line 25 |
| 27 | Audio | Audio 2.2 V pre-buck | TI TPS62840DLCR | 1 | Proposed | none | LCSC C2071859: 6,365; YBGR C2071139: 3,798 (2026-10-22) | TI TPS62A01 (LCSC 48,310) | 60 nA Iq; saves ~42 mW vs. LDOs from VSYS (power tree §4.3) v1.5: input on VSYS_LV 3.8 V (line 113); its 1.8–6.5 V input range cannot take a 2S VSYS. |
| 28 | Audio | TPS62840 inductor | Murata DFE201610E-2R2M (2.2 µH) | 1 | Proposed | none | LCSC C337891: 855 (2026-10-22) | DFE201610E-1R0M (LCSC 21,995) if the datasheet allows 1 µH | — |
| 29 | Audio | Low-noise LDOs: DAC1 VA and DAC2 VA (1.8 V), MCLK_1V8 (1.8 V, MCLK dividers; v1.9), MCLK_3V1 (3.1 V from VSYS_LV) | TI TPS7A2018PDBVR ×3, TI TPS7A2031PDBVR ×1 | 4 | Proposed (v1.1: TPS7A2033 → TPS7A2031; v1.9: TPS7A2018 ×2 → ×3, ADR 0019) | none | TPS7A2018: LCSC C963430: 13,236 @ $0.26; Mouser 3,163. TPS7A2031PDBVR: LCSC C2877858: 5,925 (2026-10-22) | TPS7A2018PDQNR (X2SON); TI LP5907-1.8 (LCSC 29,195); TPS7A2033PDBVR (LCSC C2862740: 157,199) only if VSYS stays ≥ 3.6 V | 7 µVrms, 95 dB PSRR at 1 kHz, 6.5 µA Iq; noise budget in power tree §4.3. Pre-buck at 2.2 V for the VA LDOs (D4). MCLK_3V1 (ADR 0010's MCLK_3V3): 3.1 V ±1.5 % sits in the NSC5083D 2.97–3.63 V range and keeps the recommended 0.3 V headroom down to VSYS = 3.4 V (SBVS338H §7.3); NDK phase noise is characterised at 3.3 V, so the 3.1 V figure is **UNVERIFIED** until measured v1.5: the input is VSYS_LV, a fixed 3.8 V (line 113): 0.7 V headroom on MCLK_3V1, and the 1.6–6.0 V input range is respected. v1.9 (ADR 0019): the third TPS7A2018 makes **MCLK_1V8** for the two dividers (line 139) from AUDIO_2V2, **EN tied to DAC_DIG_1V8**, so the dividers run only while the DACs' VL is up; ≈ 8.9 mA typical (Cpd 44 pF, SCES537D p. 5) = 3 % of 300 mA, from 2.2 V in (0.4 V headroom). Measurement link 36 at its input (line 137). |
| 30 | Audio | 3.5 mm jack | Same Sky SJ2-35954D-SMT-TR | 1 | Proposed | none | Mouser 4,528 (2026-10-22, sourcing report); LCSC C4992270: 71 | SJ2-35894D-SMT-TR | v0 #11. Detect switch through the TCA6416A expander (pin plan §2.1); `gpio-keys`/`simple-audio-card` jack via the expander's GPIO |
| 31 | Audio | 4.4 mm balanced jack | G-Switch GT-3321667P-01 (primary, stocked); genuine Pentaconn (NDICS) as quoted upgrade on a shared land if the drawings match | 1 | Proposed (changed primary) | none | G-Switch: LCSC C2762984: 730 @ $7.30 (2026-10-22). Pentaconn: quote only | Pentaconn (NDICS Hong Kong/Shenzhen) | v0 #12. T1-029: the stocked part is primary. G-Switch drawing, contact plating and detect switch **UNVERIFIED**; confirm 5-pole JEITA RC-8141C before layout |
| 32 | Audio | Speaker amp | ADI MAX98357AETE+T | 1 | Proposed | mainline + Debian | LCSC C910544: 18,910 @ $1.32 (2026-10-22) | MAX98360A (same driver) | v0 #13. VDD = VSYS_LV 3.8 V (v1.5, line 113; 2.5–5.5 V supply range); gated by SD_MODE. Limit gain: speaker is 0.7 W |
| 33 | Audio | Speaker | Same Sky CMS-151125-078S-67 | 1 | Proposed | none | Digi-Key 719 (2026-10-21); LCSC C3310572: 0 | PUI AS01508MR-6-R | v0 #14. Spring contacts on gold pads; no connector. MAX98357A gain and Blackbird OS limiter must keep it at its 0.7 W rating |
| 34 | Audio | Microphones ×2 (main on faceplate, ambient-noise on the body) | Infineon IM73D122V01XTMA1 (PDM) | 2 | Proposed | mainline + Debian | LCSC C5563886: 5,352 @ $2.88 (2026-10-22); Mouser 15,038 | Infineon IM72D128 | v0 #15. VDD 1.62–3.6 V on gated MIC_1V8 |
| 35 | Audio | Mic power switch + privacy-LED gate | Diodes DMG1012T-7 (N-MOSFET, VGS(th) ≤ 1.0 V) | 4 | Proposed (v1.9: 3 → 4, RP2354A BOOTSEL driver, pinout v1 C6; qty 1 → 2: one more in the MaskROM circuit, line 97; v1.6: 2 → 3, LMR33630C EN level shifter, line 119) | none | LCSC C20512: 125,601; Newark 1,042,692 (2026-10-22) | Nexperia/onsemi logic-level SOT-523 FET | Gate = MIC_1V8, so the LED cannot light without mic power (BRD-027). LED anode from FP_3V3, not 1.8 V (a red LED needs ≈ 2 V) v1.6 (MaskROM, [boost and MaskROM simulation](../research/2026-10-boost-and-maskrom-simulation.md) §5.6): the MaskROM FET drives eMMC_D0 through **1 kΩ** (was 100 Ω), placed on the D0 trace with a stub ≤ 3 mm (HS200 margin loss 0.18 → 0.04 V; D0 still forced to ≤ 0.32 V against a 4.7 kΩ pull-up), and its gate has a **100 kΩ pull-down** to GND (fitted: holds it off while vcca1v8_pmu is down). v1.9: the fourth FET pulls the RP2354A QSPI_SS (BOOTSEL) low (line 12); gate from `RP_BOOTSEL_DRV` (1.8 V ball, VGS(th) ≤ 1.0 V) with a board pull-down (line 141). |
| 36 | Audio | Headphone output ESD (L±, R± on 4.4 mm; L, R on 3.5 mm; 2 detect lines) | TI TPD1E10B06DPYR (bidirectional, 12 pF, ±5.5 V) | 8 | Proposed | none | LCSC C48260: 303,333 @ $0.04; Newark 61,842 (2026-10-22) | onsemi ESD9B5.0ST5G (LCSC 237,799) | Bidirectional because outputs swing both ways: ≈ ±4.1 V at full scale on the ±6 V rails, ±5.2 V at most with no load (0.8 V headroom, SBOS727B §6.5), below the ±5.5 V working voltage (v1.3); leakage at 5.2 V **UNVERIFIED**. Capacitance is voltage-dependent: place after the OPA1622 feedback node so the loop corrects it. Clone parts not allowed in the Commercial edition |
| 37 | Audio | HP-amp difference-amplifier resistors (12 networks, one per OPA1622 half): R1 = R3 = 1.00 kΩ, R2 = R4 = 1.62 kΩ, gain 1.62 (+4.2 dB) | Yageo RT0603BRD071KL (1.00 kΩ) ×24, Yageo RT0603BRD071K62L (1.62 kΩ) ×24 (0603, 0.1 %, 25 ppm/°C, thin film) | 48 | Proposed (v1.3: values set, ADR 0012) | none | RT0603BRD071KL: LCSC C110776: 1,697,209; RT0603BRD071K62L: LCSC C705742: 12,548 (2026-10-22) | Panasonic ERA-3AEB102V (LCSC C190613: 11,424) / ERA-3AEB1621V (LCSC 0); Susumu RG1608 | ADR 0012 and research §4.5: CS43198 at `+1dB_EN` = 0 (1.73 Vrms full scale, −115 dB THD+N typ, DS1156F2 Table 3-4) and the level from the amplifier gain. Values doubled against the TI network so two networks in parallel load each DAC pin as one TI network. Both outputs' networks hang on the same DAC pins; the DAC loading with SE and balanced connected is **UNVERIFIED** (simulation, research §6). Caps on line 108, ballast on line 107 |

### 2.3 Power

| # | Subsystem | Function | Part (MPN) | Qty | Status | Driver path | Availability (best source, stock, date) | Second source | Notes |
|---|---|---|---|---|---|---|---|---|---|
| 38 | Power | HAT 3.3 V buck (HAT_3V3, from VSYS) | TI TPS62903RPJR (3 A, 3–17 V in, VQFN-HR-9 1.5 × 2 mm) | 1 | Decided (ADR 0014; v1.5: TLV62569DBVR → TPS62903RPJR) | none | Mouser 2,589 @ $2.02; LCSC C2866502: 1,264 @ $1.18 (2026-10-22) | TI TPS62902 (2 A, same family, 2S study §4.2; stock **UNVERIFIED**) | v1.5, SLVSES3A (March 2021). VIN 3–17 V (18 V absolute maximum) from VSYS 6.0–8.8 V; the TLV62569 (5.5 V maximum) cannot sit on a 2S VSYS. FB/VSET open (≥ 249 kΩ) → 3.3 V (Table 7-2); MODE/S-CONF 26.1 kΩ → VSET, 2.5 MHz, auto PFM/PWM with AEE, output discharge on (Table 7-1). Feeds eFuse #B. BRD-049: 1.0 A design = 33 % of 3 A; 1.15 A eFuse ceiling = 38 %; high-side current limit 4.0 / 4.6 / 5.5 A (§6.5). IQ 4 µA, shutdown 0.27 µA typ. CIN 10 µF 25 V, COUT 22 µF (Table 8-3: 1 µH with 22 µF is the 2.5 MHz standard); inductor on line 7. Same part number as line 91 (one TPS62903 for both rails, ADR 0014). Linux: `regulator-fixed` with an enable GPIO (`HAT3V3_EN`). v1.9 (pinout v1 B3): `HAT3V3_EN` is expander P01, not a SoC GPIO: GPIO1–GPIO4 lose their state in Rockchip's standby (HDG p. 35), and a HAT that wakes the T1 through `HAT_INT#` must stay powered |
| 39 | Power | Charger / power path (2S, NVDC) | TI BQ25798RQMR (1–4S buck-boost, VQFN-HR-29 4 × 4 mm) | 1 | Decided (ADR 0014; v1.5: BQ25895RTWR → BQ25798RQMR) | DKMS: mainline `bq257xx` (MFD and charger) binds `ti,bq25703a` and `ti,bq25792`; the BQ25798 matches the BQ25792 for every register the driver uses and takes `compatible = "ti,bq25798", "ti,bq25792"`, a binding already in linux-next (`c3746b35b050`, not yet in master), so no driver ID is needed ([pre-freeze checks](../research/2026-10-battery-2s-prefreeze.md) §1, ADR 0014 item 5; updated 2026-10-24). `MFD_BQ257XX` not set in Debian: DKMS until Debian enables it (OS-023) | Mouser 9,488 @ $5.27; LCSC C2876593: 5,018 @ $2.82 (2026-10-22) | TI BQ25792RQMR (mainline-supported, same family without MPPT and backup mode; Mouser 34: thin, 2S study §3.1) | v1.5, SLUSDV2C (June 2026). VBUS 3.6–24 V, IVBUS ≤ 3.3 A, ISW ≤ 5 A, charge ≤ 5 A, battery discharge 6 A RMS continuous and 10 A for ≤ 1 s (§6.3); IBAT_OCP 9.3 A min, BATFET 11 mΩ (§6.5). I2C1 (1.8 V) at 0x6B (§7.5); VIH_SDA 1.3 V with a 1.8 V pull-up (§6.5). 2S: VREG 8.40 V for 4.2 V cells, 10 mV steps up to 2 × 4.40 V for LiHV (ADR 0008); VSYS 6.0–8.8 V on battery. 1.5 MHz with the 1 µH inductor (line 40); the PROG resistor sets the power-on defaults. Charge current per pack (0.5C of the quoted pack, est.). **OTG not used** (cannot run while charging; the HAT/USB-C source is line 91). VAC1 and VAC2 tied to VBUS and ACDRV1/2 to GND: no input FETs, the TPS2121 stays the input mux (line 45). BC1.2 detection on D+/D− disabled so it does not disturb USB 2 enumeration (register mapping **UNVERIFIED**). BRD-049: 2.4 A battery discharge at the full output budget = 40 % of 6 A; IINLIM ≤ 2.0 A = 61 % of 3.3 A (TPS2121 ILM 3.0 A maximum = 91 %); VBUS × IINLIM ≤ 15 W, so ISW ≤ 15 W × 0.9 / 6.0 V = 2.25 A on adapter (45 % of 5 A). TS to the pack NTC on the battery contacts (line 47; v1.10, ADR 0020). Battery-only quiescent 17 µA typ, 24 µA max (BATFET on, ADC off); 11 µA in ship mode. Passives on line 115 |
| 40 | Power | Charger inductor (1 µH at 1.5 MHz) | Coilcraft XAL4020-102MEC | 1 | Proposed (v1.5: kept, now for the BQ25798) | none | LCSC C4555951: 7,672 @ $4.32; Mouser 0 (2026-10-22) | Coilcraft XGL4020-102MEC (line 7: Isat 8.8 A at 30 % drop, same land pattern); Würth 74438357010 (LCSC 0) | v1.5. SLUSDV2C §8.2.2.2: 1.5 MHz works only with 1 µH (750 kHz only with 2.2 µH); Isat must exceed the maximum converter current plus half the ripple, and be at least 2 A for PFM pulses. TI's EVM uses a TDK SPM6530T-1R0M120. Worst case at the 5 A ISW rating: ripple at D = 0.5 (VBUS 12.6 V, the TPS2121 OV1 maximum; VSYS 6.3 V; L −20 %) = 6.3 V × 0.5 / (0.8 µH × 1.5 MHz) = 2.6 A, so the peak is 5 + 1.3 = 6.3 A = 72 % of the 8.7 A Isat (30 % drop, Coilcraft Doc 806). At the T1 design point (IINLIM 2.0 A, ≤ 15 W) the peak is ≈ 3.5 A (40 %, est.). Irms 6.7 A (20 °C rise) against ≤ 5 A |
| 41 | Power | USB-PD controller | onsemi FUSB302BMPX | 1 | Proposed | mainline + Debian | LCSC C132291: 1,635 @ $0.84 (2026-10-22); Digi-Key 5,545 (2026-10-21) | Richtek RT1715 | v0 #17. VDD from vcc3v3_pmu (always on); I2C1 (1.8 V pull-ups) 0x22, INT to 0_C4. 1.8 V I2C thresholds **UNVERIFIED** (datasheet HTTP 403). Source role on battery per power tree §4.6 (v1.5: 1.5 A advertised with a compliant 2S pack while HAT_5V is idle) |
| 42 | Power | Fuel gauge (2S; gauge only, the pack carries primary protection and balancing) | TI BQ28Z610DRZR-R1 (1–2S Impedance Track, VSON-12 2.5 × 4 mm) | 1 | Decided (ADR 0014; v1.5: MAX17055EWL+T → BQ28Z610DRZR-R1) | mainline `bq27xxx_battery` (compatible `ti,bq28z610`); `BATTERY_BQ27XXX=m`, but `BATTERY_BQ27XXX_I2C` is explicitly not set in Debian's config and arm64 does not override it ([pre-freeze note](../research/2026-10-battery-2s-prefreeze.md)): DKMS (ADR 0014, OS-023) | Mouser 5,765 @ $4.56; LCSC C2876556: 219 @ $2.85 (2026-10-22) | TI BQ40Z50-R2 (1–4S, `sbs-battery`, Debian `=m`; Mouser 8,465; datasheet not read, 2S study §3.3) | v1.5, SLUSE07B (January 2022). Supply (VC2, PBI) 2.2–26 V. VC2 to BAT+ and VC1 to the mid-cell tap through the battery contacts (line 47; v1.10, ADR 0020) for per-cell voltage; SRP/SRN across the sense resistor (line 43; coulomb counter ±100 mV, §7.11); TS1 to the board NTC (line 48). I2C1 (1.8 V): VIH = 0.7 × VREG, with the internal LDO at 1.6–2.0 V: 1.12–1.40 V (§7.9, §7.26), met by a 1.8 V pull-up with ≥ 0.4 V margin; 7-bit address 0x55 (TRM SLUUC81 §12.1, p. 57). 250 µA normal, 100 µA sleep, 0.5–2 µA shutdown (§7.5). Gauge only (updated 2026-10-24, SLUUC81 January 2020; §7 item 22): Mfg Status init 0x0008 (GAUGE_EN = 1, FET_EN = 0, PF_EN = 0; gauging is off by default), I2C Configuration 0x00 (the default BCAST = 1 would broadcast as a bus master), Balancing Configuration 0x00, DA Configuration 0x11 (2S, sleep on), firmware protections and PF disabled, CC Gain calibrated per board; full table in the parts-lib sheet. CHG and DSG open, PBI 2.2 µF to VSS. **v1.8, [ADR 0017](../adr/0017-fuel-gauge-wiring-sense-resistor-and-configuration.md) (Accepted):** VC2 and PBI on the pack side of the ship FET (line 120), after the 5 A fuse; VC1 to the mid-cell tap, both through the SLUSE07B Figure 9-1 RC filters; **PACK on the BQ25798 BAT node** (the switched side of the ship FET), through the Figure 9-1 PACK network, not on BAT+: when the ship FET opens, PACK falls below the 3.0 V Charger Present Threshold and the gauge can shut down. Storage and critical-battery power-off (Blackbird OS, no adapter present): gauge MAC 0x0010 twice, then BQ25798 SDRV_CTRL = 01 (shutdown mode, wake on adapter): board drain ≈ 1 µA typical, 4.7 µA maximum (ADR 0017 item 3). Golden image adds (ADR 0017 item 5): the three conflicting TRM fields set explicitly after a read-back check (Enabled Protections C with PTO and CTO cleared, AFE Protection Control RSNS = 0 with RSTRIM as read, IT Gauging Configuration functional bits 0x14CE), DA Configuration 0x19, Power Configuration 0x00, Charger Present Threshold 3000 mV, Shutdown Voltage 2300 mV / 10 s, Ship FET Off Time 10 s and Delay 20 s, Sleep Current 10 mA, Bus Timeout 5 s, AOLD Threshold 0xF4 (6.5 A at 3 mΩ). Chemistry ID and design capacity per quoted pack (golden image, production step) v1.9 (pinout v1 C25, B7): no alert line to the expander: the BQ28Z610-R1 has no alert pin (SLUSE07B p. 3, Figure 6-1); the gauge is read over I2C1 and charger events arrive on `CHG_INT_N`. |
| 43 | Power | Gauge sense resistor 3 mΩ 1 % (v1.8; 5 mΩ until v1.7) | Vishay WSL12063L000FEA (1206 metal strip, 0.25 W) | 1 | Decided ([ADR 0017](../adr/0017-fuel-gauge-wiring-sense-resistor-and-configuration.md); v1.5: RL0603FR-070R01L → WSL12065L000FEA; v1.8: → WSL12063L000FEA) | none | TTI 84,000; Avnet 24,000; Mouser 5,901 @ $0.593 (100); Arrow 4,000 + 3,526; Verical 4,000; LCSC C4264731: 10 (2026-10-24, ADR 0017 §2) | Vishay WSL12063L000FEA18 (Mouser 11,084) | v1.8, ADR 0017 §2 and Vishay doc 30100 (Rev. 23-Nov-2023): same family, package and pad table (0.002–0.0059 Ω row) as the v1.5 part, so the footprint does not change. 3 mΩ is the largest value inside the 1–3 mΩ SLUSE07B recommends (§8.4.2.3 p. 22, §11.1 p. 27, Figure 9-1). 3.2 A worst case → 9.6 mV, **31 mW (12 %** of 0.25 W); 5 A fuse rating → 75 mW (30 %); full scale ±33 A (±100 mV coulomb counter, §7.11); maximum offset 2.6 mA. Component TCR ±150 ppm/°C, above TI's 50 ppm/°C guidance, accepted (ADR 0017 §2: ±0.38 % over 25 K, below the uncalibrated gain error; CC Gain and Capacity Gain calibrated per board at 1–2 A). AOLD at the default setting moves to 6.5 A, above the 5 A fuse, so load peaks no longer block SLEEP. Low side, in the P− return: SRP/SRN within ±0.2 V of the gauge VSS (SLUSE07B §7.3). Kelvin traces to SRP/SRN (doc 30100 p. 2). Cost ≈ +$0.52 a board on the LCSC basis, ≈ −$0.34 Western (ADR 0017). Was (v1.5–v1.7): WSL12065L000FEA 5 mΩ, outside TI's range |
| 44 | Power | eFuse ×3 (HAT 5 V out, HAT 3.3 V out, USB-C VBUS out) | TI TPS259470ARPWR | 3 | Proposed | none | LCSC C3662799: 3,761 @ $1.29 (2026-10-22); Digi-Key 76,492 (2026-10-21) | TPS259472A / TPS259474L | v0 #19 (was ×2). Fed from the TPS62903 5.1 V buck (line 91) for #A and #C and the TPS62903 3.3 V buck (line 38) for #B (v1.5). ILIM 1.5 / 1.0 / 1.5 A hardware ceilings (2.21 kΩ: ±10 % above 1 A → 1.66 A max; 3.32 kΩ: 0.85–1.15 A, SLVSFC9C §6.5), 5.5 A continuous switch rating: ≤ 30 %. On battery Blackbird OS budgets the sum (power tree §4.6). IMON to SoC SARADC. v1.9 (pinout v1 C10, B6): the RK3566 has four SARADC inputs and Vol+ and Vol− take two: #A → SARADC_VIN2, #B → SARADC_VIN3, #C → a test pad; the INA236 HAT channel at the 5.1 V buck input sees #A and #C together **v1.11 (hat-standard interface v1.1 §5, BRD-049):** maximum trips with the 1 % RILM tolerance: #A and #C 2.21 kΩ → 1.524 A typical + 10 % = **1.68 A** (56 % of the 3.0 A `HAT_5V` ceiling); #B 3.32 kΩ → **1.16 A** (77 % of the 1.5 A `HAT_3V3` ceiling). ITIMER open on #A and #B, so current above ILIM passes only for the device's minimum response (SLVSFC9C §7.3.5); the 2 × ILIM scalable fast trip bounds that transient |
| 45 | Power | Power mux (USB-C IN1 priority, powerbank HAT IN2) | TI TPS2121RUXR | 1 | Proposed | none | LCSC C485916: 25,546 @ $0.92; Mouser 18,252 (2026-10-22) | — | v0 #20. v1.1: OV1 divider R1 1.02 MΩ / R2 100 kΩ (1 %) → 11.9 V typ, 11.1–12.6 V over VREF 1.01–1.1 V; one value in both documents (power tree §4.7). Worst-case RON 100 mΩ → 0.40 W at 2 A, +29 °C at RθJA 72.2 °C/W. v1.2: RILM 44.2 kΩ → ILM 2.0 / 2.5 / 3.0 A (SLVSEA3F §7.5): above the 2.0 A IINLIM (line 39), at most 67 % of the 4.5 A rating, and ≤ 0.25 A per HAT_5V contact for a class F HAT (line 66). OV1 also forced high by `USB_SRC_ON` while the T1 sources USB-C VBUS; OV2 forced high by `HAT_SRC_ON` while it sources HAT_5V (hardware OR from the 5.1 V buck and eFuse enables, not software order) **v1.11 (hat-standard ADR 0005, `HAT_5V` fault ceiling 3.0 A):** at 44.2 kΩ 1 % the maximum reached 3.02 A (TI's ±0.5 A spread, SLVSEA3F §7.5). **RILM → 45.3 kΩ 0.1 %**: 2.45 A typical (Equation 2), **2.95 A maximum (98 %)**, 1.94 A minimum (spread at 45.3 kΩ assumed equal to TI's rows, **UNVERIFIED**); 0.295 A per `HAT_5V` DF40 contact (98 %). The BQ25798 IINDPM becomes 1.9 A at VBUS ≤ 5.5 V so the mux never limits in normal charging (Changes in v1.11 item 7). Fast trip ≈ 2.4 × ILM for ≤ 1 µs (§9.3.3) |
| 46 | Power | Battery | **Quoted 2S1P Li-ion pack** (two catalog pouch cells; PCM with over-charge, over-discharge, over-current 4.0–5.0 A and short-circuit protection, and cell balancing; terminal board with recessed hard-gold pads, v1.10, ADR 0020 item 8; 4-pin Micro-Fit 3.0 lead until v1.9); maker not chosen | 1 | Decided (ADR 0014, supersedes ADR 0011; the pack is a T1-038 exception; terminal board: ADR 0020 item 8); pack **Open** (quotes pending) | none (charge voltage per pack in DT; gauge chemistry and capacity per pack) | quote only: at least two independent pack makers to the same specification (ADR 0014 item 2) | A stocked, off-the-shelf pack meeting the same criteria replaces the quoted one (ADR 0014 item 2) | v1.5. Replaces the Adafruit 328 interim pack and the Adafruit 2011 second source (ADR 0007): the Adafruit 328 is no longer a T1 pack (ADR 0014 item 4). Acceptance criteria (ADR 0014 item 2): continuous discharge ≥ 4.0 A (3.2 A at 80 %); PCM trip 4.0–5.0 A; contact interface ≥ 4.6 A per pole (3.2 A at 70 %; ADR 0020 item 3, was "lead and plug"); sized for the worst continuous case, ≈ 3.2 A at VSYS 6.6 V (§7 item 17); the largest energy that fits the battery pocket of t1 ADR 0003 (10.9 × 50.5 × 63.8 mm for the tentative body, two ≈ 5 mm cells stacked; 2S study §1); UN 38.3, and IEC 62133-2 for the Commercial edition; 4.2 V or LiHV cells (ADR 0008). No stocked 2S pack meets them (2S study §2). Bring-up uses a bench supply or a protected 2S pack on the bench (ADR 0014 item 4). BRD-050 is met once a compliant pack is fitted. **v1.10 ([ADR 0020](../adr/0020-battery-connected-through-contacts.md) item 8):** in place of the lead and plug, a terminal board at the PCM end: seven positions at 3.5 mm pitch (P+, P+, no pad, mid-cell tap, NTC, P−, P−); pads ≥ 4.0 × 2.5 mm (the contact's mating pad, drawing 70-9258-001-1X0-00XS sheet 2), lengthened by the pack's position tolerance, gaps ≥ 1.0 mm; electrolytic hard gold ≥ 0.76 µm over nickel, no ENIG or immersion gold in the contact area (nickel thickness **UNVERIFIED**); power pads recessed 0.2 mm and signal pads 0.4 mm, walled so a flat metal object cannot touch two pads; keyed by an asymmetric terminal end matching the pocket and polarity-marked (IEC 62133-2 clause 5.5); each power pad and its copper ≥ 5 A continuous; the PCM's short-circuit threshold and delay stated, and a pulse of ≈ 63 A for ≈ 2 µs (est., the adapter-present insertion) shown not to trip it, or its behaviour stated; UN 38.3 (T.5 at the pads) and IEC 62133-2 (7.3.2) on the pack as shipped with exposed pads; a terminal cover or separating packaging for spares; Art. 13 and WEEE marks, polarity at the pads and the specification identifier (T1-080); the full specification published (T1-079). The pocket's 2.5 mm lead-exit allowance is freed (§7 item 42). Full list: [contact battery research](../research/2026-10-contact-battery-t1.md) §5 |
| 47 | Power | Battery contacts (P+ ×2, P− ×2, mid-cell tap, NTC; face compression through a window of the pocket floor at the pocket's bottom end) | KYOCERA AVX 70-9258-001-120-006 (spring-finger contact, 6 A, working height 1.6–2.8 mm, 0.4 µm gold over nickel, 2,500 cycles, SMT) | 6 | Decided ([ADR 0020](../adr/0020-battery-connected-through-contacts.md); v1.10: Molex 43650-0400 → 6 × 70-9258-001-120-006) | none | Digi-Key 1,384 @ $0.41 (1) / $0.25 (1,000); Mouser 3,495; Newark 3,930; Future 4,000 (2026-10-24) | None on the same land. Mill-Max 0965-0-15-20-80-14-11-0 (Digi-Key 41,785; Mouser 290,264) or 0990-0-15-20-76-14-11-0 (stock not found) pogo pins, 2 A each, four per pole on their own land, to qualify (research §3) | v1.10, TDS-BTB-0026 Rev 1 and drawing 70-9258-001-1X0-00XS Rev F (parts-lib manifest). Order at 3.5 mm pitch: P+, P+, empty position (no copper, PCB-L-04), mid-cell tap, NTC, P−, P−: a pack displaced by one pitch joins P+ only to the empty position, the tap only to the NTC (≤ 4.45 V into TS, under its 6 V absolute maximum) and the NTC only to P− (research §2.2). Pads 7.00 × 2.70 mm (drawing sheet 2). Working height 2.1 mm nominal (1.5 mm component zone + 0.4 mm floor + 0.2 mm pad recess), ± 0.3 mm assumed until the case tolerance stack: 1.8–2.4 mm. **BRD-049** (power tree §4.7.1): two contacts per pole, sharing factor 1.25 assumed until CB-01: 3.2 A worst continuous → 2.0 A on the hotter contact = **33 %** of 6 A (≤ 70 % contact rule); 2.4 A full budget → 25 %; 5 A protective limit → 3.1 A = 52 % (≤ 100 % trip rule); pole rating 9.6 A against ADR 0014's ≥ 4.6 A per pole. End-of-life resistance ≤ 20 mΩ per contact **UNVERIFIED**: 80 mV and ≈ 0.26 W in total at 3.2 A, 0.08 W on the hotter contact; 0.19 W at 5 A for the PCM's trip time; temperature rise **UNVERIFIED** (CB-02). Contact force, resistance and the rating's basis are in KYOCERA AVX product specification 201-01-252, not obtained (§7 item 42). No Kelvin contacts: the coulomb counter is on line 43, outside the contacts; cell voltages read ≤ 40 mV low per cell at 3.2 A, zero at rest (ADR 0020 item 4). Gold on both sides; the part's tin is on its solder base only (drawing note 2). Keying is the pack's terminal end and the pocket (case input), no longer a keyed plug. Board copper unchanged: P+ through the fuse (line 104) to the BQ25798 BAT pins, P− through the sense resistor (line 43) to ground, sized for the 5 A fuse; each pole's two contacts in a symmetric pour (PCB-L-07). Pack-side mating parts 43645-0400 and 43030-0001 leave the pack specification. Was (v1.5–v1.9): Molex Micro-Fit 3.0 43650-0400, right-angle header in a notch outside the pocket, 3.2 A = 64 % of 5 A per contact |
| 48 | Power | Board-side battery NTC 10 kΩ | Murata NCP15XH103F03RC | 1 | Proposed | none | LCSC C77131: 273,958; Arrow 280,000 (2026-10-22) | — | Pressed against the pocket floor. v1.5: to the BQ28Z610-R1 TS1 (line 42) for the gauge; the charger TS takes the pack NTC through the battery contacts (line 47; v1.10, ADR 0020). B = 3380 K. The charge window follows the pack specification (ADR 0014 item 2); BQ25798 TS thresholds for the pack NTC **UNVERIFIED** until the pack NTC type is fixed |
| 49 | Power | vdd_npu, vdd_gpu, vdd_logic, vcc_ddr, vcc_1v8, LDO1–9, RTC | (inside RK809-5, line 2) | — | Proposed | — | — | — | Rail map in power tree §3 |
| 50 | Power | Load switches (DAC_VP, DAC_DIG_1V8, RP_3V3, RP_IOVDD_1V8, NFC_VBAT, vcc3v3_wl; v1.11: FP_3V3, FP_1V8 and MIC_1V8 move to current-limited switches, lines 145, 146) | TI TPS22919DCKR | 6 | Proposed (6 → 7: FP_3V3 added; v1.8: 7 → 8, NFC_VBAT for the PN7160, G7; v1.9: 8 → 9, vcc3v3_wl for the radio AVDD33; v1.11: 9 → 6, faceplate interface v1 ADR 0005) | none | LCSC C2149796: 42,715 @ $0.12; Mouser 21,679 (2026-10-22) | TI TPS22916CYFPR (LCSC 2,674) | 1.5 A, 90 mΩ, QOD, 2 nA off. Enables from the TCA6416A or SoC GPIO (power tree §5). SiP32431 dropped as second source (pinout **UNVERIFIED**) v1.5: the DAC_VP switch input is VSYS_LV 3.8 V (line 113; 1.6–5.5 V rating, CS43198 VP 3.0–5.25 V). v1.8 (G7): an eighth switch makes **NFC_VBAT** from VSYS_LV for the PN7160 VBAT and VDD(UP) (line 127), ON from the expander line `NFC_PWR_EN` (smart ON pull-down, SLVSEN5B p. 1): 290 mA maximum in reader mode = 19 % of 1.5 A, 26 mV across 90 mΩ. Block `blk.nfc-reader`: fitted in `full`, follows the PN7160 (`open` in `production`, DNP in `lite`) v1.9 (decision 2026-10-24, radio in suspend): a ninth switch makes **vcc3v3_wl** (Type 2EL AVDD33, line 55) from vcc3v3_sys instead of RK809 SWOUT1, ON from expander P06 `WL_PWR_EN` (holds through suspend; pull-down: off). 1.05 A peak = 70 % of 1.5 A, 0.24 A typical = 16 %; 95 mV across 90 mΩ at the peak (AVDD33 range **UNVERIFIED**, line 55). Quick output discharge empties the rail at switch-off (G13). Block `blk.radio`: fit in every variant. |
| 51 | Power | Backlight LED driver | TI TPS61160DRVR (WSON-6 2 × 2 mm; v1.11, was TPS61169DCKR) | 1 | Proposed | mainline + Debian (`pwm-backlight` on CTRL, `BACKLIGHT_PWM=m`) | LCSC C165143: 9,749 @ $0.43; Mouser 0, TPS61160DRVRG4 8,643 @ $1.75; ComSIT, Sensible Micro (brokers) (2026-10-24) | None with an open-LED threshold ≤ 30 V found yet; the TPS61169DCKR (36–39 V) no longer qualifies | On the main board: BL_LEDA/BL_LEDK cross the faceplate FPC. **v1.11 (t1 faceplate interface v1 §2.3, t1 ADR 0005, BC4):** BL_LEDA ≤ 30 V in every state. Open-LED threshold 25 / 26 / 27 V at SW (SLVS791E §6.5), so an open string holds ≤ 27 V on contact 46; strings ≤ 22 V at their maximum current. VIN = VSYS_LV 3.8 V (2.7–18 V rating). RSET 3.32 Ω for 60.2 mA (VREF 196–204 mV). Switch limit 0.56–0.84 A at Dmax; worst-case maximum output with 22 µH (line 52) 82 mA at a 16.5 V string (73 % at 60 mA), 75 mA at 18 V (80 %), 61 mA at 22 V (99 %): a faceplate with a string above 18 V declares a lower full-scale current (Changes in v1.11, faceplate item 4). Was (v1.1–v1.10): TPS61169DCKR, 37.5 V OVP, RSET 3.40 Ω |
| 52 | Power | Backlight inductor 22 µH (v1.11; 10 µH until v1.10) | Murata LQH3NPN220MMEL (3 × 3 mm, the land of the 10 µH part) | 1 | Proposed | none | LCSC C703143: 9,761 @ $0.20 (2026-10-24) | Murata LQH3NPN220MJRL (LCSC C110302: 4,659; 0.52 A) | TI recommends 10–22 µH for the TPS61160 (SLVS791E §8.2.1.2.2); with 10 µH the worst-case maximum output at 3.8 V is 51 mA, below 60 mA. Peak 0.44 A at a 16.5 V string and 60 mA = 82 % of the 0.54 A rating (LCSC listing; Murata sheet not retrieved, **UNVERIFIED**). The switch limit (0.84 A max) is above the rating, as in TI's own recommended inductors (510–750 mA, §8.2.1.2.2 Table 4): saturation only at start-up into a fault. Was: LQH3NPN100MJRL 10 µH |
| 53 | Power | Backlight rectifier 60 V 1 A | Nexperia PMEG6010CEH,115 (SOD123F) | 1 | Proposed (v1.1: PMEG4010CEH → PMEG6010CEH) | none | LCSC C110797: 7,626; Newark 18,084 (2026-10-22) | Nexperia PMEG6010CEJ,115 (SOD323F, LCSC C406049: 66,599) | VR 60 V, IF 1 A, VF ≤ 660 mV at 1 A (datasheet Rev 02). The TPS61169 OVP reaches 39 V max (SNVSA40B), which left 1 V on the 40 V part. Same SOD123F land as before. Pin genuine Nexperia C-codes (clones listed under the same name) v1.11: with the TPS61160 the rectifier sees ≤ 27 V (45 % of 60 V); kept |
| 54 | Power | Current monitors (VSYS, audio block, display block, HAT) | TI INA236AIDDFR | 4 | Proposed | mainline + Debian (IIO `ina2xx-adc`, `ti,ina236`, `INA2XX_ADC=m`) | LCSC C5443912: 1,938 @ $2.16; Mouser 111 (2026-10-22) | TI INA238 (1.2 V I2C, hwmon, DKMS). INA226 removed: VIH = 0.7 × VS cannot meet a 1.8 V bus | On I2C1 (1.8 V) at 0x40–0x43. Shunts 10 / 100 / 100 / 20 mΩ (§5). v1.2: VSYS shunt 10 mΩ ≥ 1 W (2512): 0.36 W at the 6 A BATFET rating (36 %), 0.23 W at 4.8 A; HAT shunt 20 mΩ ≥ 0.5 W (0.19 W at the 3.1 A boost input, 0.06 W at the 1.66 A eFuse ceiling). v1.5 (2S): the VSYS shunt carries 2.4 A at the full budget (58 mW, 6 %), still 0.36 W at the BQ25798's 6 A continuous rating; the HAT shunt sits at the 5.1 V buck input, ≈ 1.3 A at 6.6 V (est.), 35 mW. Bus voltage up to 8.8 V is inside the INA236 range. For T1-026 instrumentation. **Thin Western stock** v1.8 (G11): positions fixed (power tree §4.12): VSYS 10 mΩ (unchanged); **audio** on a dedicated VSYS_LV branch feeding the TPS65131, TPS62840, TPS7A2031 and the DAC_VP switch, shunt **100 → 20 mΩ** WSL1206R0200FEA (the boost draws ≈ 1.5 A at the positive LDO pair's maximum trip, beyond the 0.82 A full scale of 100 mΩ; 20 mΩ gives 4.1 A); **display** on the TPS61169 VIN, 100 mΩ (0.33 A max = 40 % of full scale); HAT 20 mΩ at the 5.1 V buck input. The LMR33630C input (VSYS) gets a fifth monitor (line 136). Fitted in every variant (ADR 0013) v1.11: the display shunt sits on the TPS61160 VIN (line 51) |

### 2.4 Connectivity and sensors

| # | Subsystem | Function | Part (MPN) | Qty | Status | Driver path | Availability (best source, stock, date) | Second source | Notes |
|---|---|---|---|---|---|---|---|---|---|
| 55 | Connectivity | Wi-Fi 6 + BT 5.4 (pre-certified) | Murata LBES5PL2EL-923 (Type 2EL, NXP IW612) | 1 | Proposed | DKMS (`nxpwifi` arrives in 7.3; `BT_NXPUART` off) | Digi-Key 938 @ $20.30 (2026-10-21); Mouser 2,820; LCSC C23572665: 0 (2026-10-22) | u-blox MAYA-W271-00B (same chip) | v0 #22. VBAT on RK809 SWOUT1 (1.5 A switch, VCC9 = vcc3v3_sys; module supply range **UNVERIFIED**), VIO 1.8 V (VCCIO4), SDIO 3.0 on `sdmmc1`, BT on UART1 M0 with RTS/CTS. BT audio over HCI (ADR 0006) v1.8 (E1.12): supplies by pin (E2B-09-1413 Figure 5): **AVDD33** (pins 12–13) on vcc3v3_wl (SWOUT1), ≈ 240 mA typical transmit, peaks above 1 A (EA M.2 PA4, carrier); **AVDD18** (pins 30–31) on **vcc1v8_wl** from its own buck (lines 129–131), 390 mA typical; **VIO** (54) and **SD_VIO** (40) on vcc_1v8, the VCCIO4 domain (pinout v1 confirms it). Module supply ranges and sequencing between the rails **UNVERIFIED** (datasheet not obtained). One measurement link per rail (line 137). Block `blk.radio`: fitted in every variant v1.9 (decision 2026-10-24; BRD-030, T1-069): the module can stay powered in suspend for Bluetooth item tracking. AVDD33 comes from the line 50 switch on expander P06 `WL_PWR_EN` (no longer SWOUT1), AVDD18 from line 129, which follows it. Default off in suspend; on only while the listener enables tracking, and then vcc_1v8 (VIO, SD_VIO, the VCCIO4 bank) stays on in suspend too. Suspend draw **UNVERIFIED** until measured on M-RF; `WL_PDN` hold through suspend is §7 item 40. The 802.15.4 SPI (pins 4–8) stays unconnected: the SPI2 M0 balls are unassigned spares reserved for a variant (T1-077 keeps 802.15.4 disabled while not wired). |
| 56 | Connectivity | Antenna connector (ANT0 pin 15, ANT1 pin 23) | Hirose U.FL-R-SMT-1(10) | 2 (ANT0 fitted; ANT1 fitted in `full` only) | Proposed (v1.8: [ADR 0018](../adr/0018-antennas-and-certification-route.md)) | none | LCSC C88373: 9,801; Mouser 160,436 (2026-10-22) | Hirose U.FL-R-SMT-1(80) (LCSC 123,360) | v1.8 ([ADR 0018](../adr/0018-antennas-and-certification-route.md), Accepted): ANT0 pin 15, ANT1 pin 23 (E2B-54-1953 Table 3). ANT0 carries the shared Wi-Fi/Bluetooth antenna (line 57). The ANT1 footprint is kept: **variant field (RFC 0011):** `full` fits it for the dedicated-configuration experiment; `production` and `lite` DNP unless ADR 0018 decision 2 changes (coexistence gate). Both in the top band near the top wall, ≥ 0.8 mm keep-out under each (E2B-09-1413 Figure 13). Block `blk.antennas` |
| 57 | Connectivity | Antenna (Wi-Fi 2.4/5 GHz and Bluetooth, shared configuration on ANT0) | Molex 146153-0050 (flexible dipole, 34.9 × 9.0 mm, U.FL, 50 mm class) | 1 | Decided ([ADR 0018](../adr/0018-antennas-and-certification-route.md); v1.8: 146187-0050 × 2 → 146153-0050 × 1) | none | Digi-Key 15,886 @ $2.27; Mouser 21,613; Newark 6,592; TME 1,068; LCSC C916292: 113 @ $2.49 (2026-10-24, ADR 0018) | Molex 219611-0050 (listed for FCC, ISED and Japan; needs 15.4 mm of wall height); Japan only: Molex 146187-0050 | v1.8, ADR 0018: on Murata's FCC (CER-0248 Table 20) and ISED (Table 36) lists and Japan Table 56; the 146187 was on Japan's list only. Mounted inside the top wall, long axis along the width, away from the microSD corner; radiating element ≥ 5 mm from metal (provisional, **UNVERIFIED** until measured). Shared configuration (10 pF pin 18–pin 23, line 58). A second antenna only under the dedicated option (prototype experiment: Inventek W24P-U, 2.4 GHz, listed in all three). Regional routes and TX-power tables per variant: ADR 0018 decision 3. Block `blk.antennas`. Variant: fit in every variant |
| 58 | Connectivity | RF matching network (ANT0 and ANT1 paths, Murata's copy) | 0603 positions as Murata's reference (LQP03 / GRM03 class, E2B-09-1413 Figures 9–10): 0 Ω series fitted, shunts DNP; **10 pF C0G link pin 18–pin 23** (fitted for the shared configuration); dedicated-configuration positions (BT_15.4_IN termination per Figure 10, ANT1 path) DNP | 3 per path + 1 link + dedicated set | Proposed (v1.8: 0402 → 0603, [ADR 0018](../adr/0018-antennas-and-certification-route.md)) | none | jellybean | — | Tuned on the final enclosure. v1.8: Murata's reference uses 0603 parts, not 0402; the layout holds both configurations without a respin (ADR 0018 decision 4). Dedicated-configuration values transcribed from a drawing: **UNVERIFIED**. Variant: shared set fitted in every variant; dedicated set fitted only if ADR 0018 decision 2 switches |
| 59 | Sensors | IMU | ST LSM6DSV16XTR | 1 | Proposed | mainline + Debian | LCSC C5267406: 7,746 @ $3.36 (2026-10-22); Mouser 4,510 (2026-10-21) | LSM6DSOXTR (same driver and footprint) | v0 #23. On vcc_1v8 (VDDIO 1.8 V), I2C2 at 0x6A (v1.5: the BQ25798 is at 0x6B on I2C1, no clash), INT1 to 0_C5 for wake-on-motion v1.8 (G1): VDD and VDDIO move to **vcca1v8_pmu** (always on, also in suspend) through a 10 Ω measurement link (line 137): 0.65 mA maximum mode → 6.5 mV; Vdd 1.71–3.6 V (DS13510 Table 4). vcc_1v8 was off in suspend, while the IMU is the wake-on-motion source |
| 60 | Sensors | Ambient light sensor (on the faceplate) | Vishay VEML6030 | 1 | Proposed | mainline + Debian | LCSC C132182: 10,967 @ $0.72 (2026-10-22) | LTR-303ALS-01 | v0 #24. VDD 2.5–3.6 V from FP_3V3; I2C3 at 3.3 V (VCCIO5) at 0x10; INT open-drain to 0_C6 (1.8 V pull-up, open-drain so no level conflict) v1.9 (pinout v1 C4): the interrupt is `FP_ALS_INT_N` on GPIO3_B2 (VCCIO5, 3.3 V) with a 4.7 kΩ pull-up on FP_3V3, not 0_C6; not a standby wake source. |

### 2.5 Connectors, protection and interfaces

| # | Subsystem | Function | Part (MPN) | Qty | Status | Driver path | Availability (best source, stock, date) | Second source | Notes |
|---|---|---|---|---|---|---|---|---|---|
| 61 | Interfaces | Main USB-C (USB 2.0 OTG + PD) | GCT USB4105-GF-A | 1 | Proposed | none | Digi-Key 91,262 (2026-10-21); LCSC variants -120: 2,890, -060: 1,133 (2026-10-22) | Amphenol 12402012E212A. IP67 option for the Commercial edition: GCT USB4730-GF-A | v0 #25 |
| 62 | Protection | USB ESD (D+/D−) | TI TPD4E05U06DQAR | 1 | Proposed | none | LCSC C138714: 211,256 @ $0.08; Newark 35,363 (2026-10-22) | Tech Public, MSKSEMI | v0 #26. 0.42–0.5 pF |
| 63 | Protection | CC/SBU protection | TI TPD8S300ARUKR | 1 | Proposed | none | LCSC C2649824: 60; Mouser 2,800 (2026-10-21) | TI TPD4S311A (LCSC 7) | v0 #27. **Low LCSC stock**. Dead-battery Rd included |
| 64 | Protection | USB-C VBUS TVS (22 V flat clamp) | TI TVS2200DRVR | 1 | Proposed | none | Mouser 5,672; LCSC C523793: 504 (TI) / C55616459: 2,360 (Maxinmicro) (2026-10-22) | Littelfuse/MDD SMBJ24A (LCSC 58,577; softer clamp) | Clamp coordination is a risk (power tree §4.7) |
| 65 | Protection | HAT 5 V and 3.3 V rail TVS (5 V flat clamp) | TI TVS0500DRVR | 2 | Proposed | none | Mouser 70,452; LCSC C609571: 3,693 (2026-10-22) | MDD SMF5.0A (LCSC 551,604) | At the HAT flat-cable connector |
| 66 | Interfaces | HAT flat-cable connector (board side and device-side piece), signals and power | Hirose DF40C-100DP-0.4V(51) header + DF40C-100DS-0.4V(51) receptacle | 1 + 1 per end (v1.11; 2 + 2 per end until v1.10) | Proposed (picked, ADR 0009; v1.2: power pair 30 → 50 contacts; v1.11: power pair removed, hat-standard ADR 0005) | none | DF40C-100DS: Digi-Key 169,419 @ $2.39; DF40C-100DP: Mouser 10,937, Digi-Key 0 (5,000 due 2027-01-05) (2026-10-22) | FH35C-61S rejected (0 authorized stock); micro-coax assemblies rejected (made to order, T1-038) | ADR 0002, BRD-013. **Contact allocation: hat-standard [HAT interface v1.1](https://github.com/opendap-project/hat-standard/blob/main/docs/specs/interface-v1.md) §7.2** (Draft; ADR 0005). The four corner contacts of the header are metal fittings, not signal or power (DF40 catalog 2020, p. 10, note 3): positions 1, 2, 99, 100; **87 of the 96 usable positions** (3–98) are assigned, 9 spare (9.4 %). Power at 0.3 A per contact (catalog p. 2): `HAT_5V` × 10, `HAT_3V3` × 5, `GND` × 15 at 67 % continuous (2.0 / 1.0 / 3.0 A) and 100 % at the interface fault ceilings (3.0 / 1.5 / 4.5 A); at the T1's own trips `HAT_5V` 56 % out (eFuse #A 1.68 A) and 98 % in (TPS2121 2.95 A), `HAT_3V3` 77 % (1.16 A), `GND` 91 % (4.11 A). `HAT_DET#` at position 33 proves the single connector mated. Not polarized (p. 10 note 5): both cable ends keyed. 5 Gb/s rating of DF40 **UNVERIFIED** (catalog gives no figure): the hat-standard coupon before freeze. The FPC itself is a fabricated board like the PCB (line 102). Was (v1.4–v1.10): DF40C-100 for signals (72 of 96) and DF40C-50 for power (46 of 46) |
| 67 | Interfaces | HAT pogo pins (68, 4 × 17 field at 2.54 mm, L3) | Harwin P70-1000045R | 68 | Proposed (device-side piece; v1.4: ~128 → 96; 96 → 100 and second source per hat-standard ADR 0004; v1.11: 100 → 68 per hat-standard ADR 0005) | none | Digi-Key 5,006 (2026-10-21); LCSC C17702549: 0 (2026-10-22) | Mill-Max 0965-0-15-20-80-14-11-0 on the same pads (hat-standard ADR 0004; Digi-Key 41,785 on 2026-10-22) | v0 #28. On the device-side piece (ADR 0002, hat-standard scope); kept here for traceability. **v1.11:** a 4 × 17 field at 2.54 mm (40.64 × 7.62 mm span), L1 29, L2 45, L3 68 contacts cumulative (interface v1.1 §7.1); spring force ≈ 60 N with the P70 (0.88 N each), ≈ 77 N with the 0965 (hat-standard ADR 0005). The Ø 2.20 mm recommended pad fits the 2.54 mm pitch (D36, closed). Was (v1.4 to v1.10): 100 pins in a 4 × 25 field, ≈ 88 N |
| 68 | Protection | HAT high-speed ESD (USB 3 SS × 2 pairs, its USB 2 pair, extension `EXT0`–`EXT4`: 8 pairs) | TI TPD4E05U06DQAR | 4 | Proposed (v1.4: 12 → 11 pairs, quantity unchanged; v1.11: 11 → 8 pairs, 6 → 4 parts) | none | as line 62 | TI TPD1E04U04DPYR per line (0.5 pF; Mouser 7,608, LCSC 10,280) | 16 lines on 16 channels. 0.42–0.5 pF meets the 5 Gb/s budget (§4.1). At the user-touchable pogo field (device-side piece); no second ESD on the board side of the FPC (it would double the capacitance). 5.5 V working voltage covers every extension signal (PCIe, HCSL REFCLK, D-PHY high-speed and low-power) |
| 69 | Protection | HAT low-speed ESD (22 low-speed lines and 8 reserved contacts) | TI TPD4E05U06DQAR | 8 | Proposed (v1.1: TPD6E05U06RVZR ×9 → TPD4E05U06 ×12 + TPD1E10B06 ×4; v1.4: ×12 → ×8 and ×4 → ×2; v1.11: TPD1E10B06 ×2 → ×0, line out removed) | none | as line 62 | TPD1E04U04DPYR per line | v1.11 (interface v1.1, hat-standard ADR 0005): 32 channels for 30 lines (22 low-speed, including `HAT_DET#`, and the 8 reserved contacts, all of which have cable positions). At the pogo field. Line out and its two `AGND` contacts leave the interface, so the bidirectional TPD1E10B06 pair goes. The TPD6E05U06 RVZ package has no drawing in its datasheet (D17) |
| 70 | Interfaces | HAT high-speed AC-coupling caps (USB 3 SSTX, PCIe TX) | 100 nF X7R 0201 | 4 | Proposed | none | jellybean | — | 75–265 nF window (USB 3), 75–200 nF (PCIe Gen2) v1.11 (hat-standard interface v1.1 §4.4): the two PCIe TX capacitors sit between the SoC and port A of the extension switch (line 144), never on the shared `EXT1` path, because CSI-2 is DC-coupled (TI SLASEW5A Figure 7-1, option b; PCB-I-03) |
| 71 | Interfaces | Faceplate FPC connector | Hirose FH35C-51S-0.3SHW(50) | 1 | Proposed (45 → 51 contacts; v1.2: 46 used + 5 spare) | none | Mouser 8,070 @ $2.04; Newark 2,312 (2026-10-22) | FH35C-51S-0.3SHW(99) (Mouser 475, Arrow 169); FH26W 51-pin **UNVERIFIED** | v0 #29. v1.2: 46 used + 5 spare (9.8 %, at the ADR 0006 "about 10 %" floor): the RGB status LED takes LED_R, LED_G, LED_B instead of one PWM line. Carries DSI ×4 lanes, I2C, SPI/DBI, INT/RST, TE, status LED (3), PDM, detect, BL_LEDA/LEDK, FP_3V3 ×2, FP_1V8, FP_VCI, MIC_1V8 (cross-validation §5). 0.2 A per contact, 0.14 A with all contacts loaded (FH35C catalog p. 2): FP_VCI 0.1 A on one contact = 71 % of the derated figure, the LED lines ≤ 20 mA v1.9: contact positions in pinout v1 §8 (RFC 0001 group order) and in the t1 faceplate interface spec. |
| 72 | Protection | Faceplate DSI ESD (CLK, D0–D3: 10 lines) | TI TPD4E05U06DQAR | 3 | Proposed (2 → 3) | none | as line 62 | Tech Public / BORN clones (not in the Commercial edition) | 12 channels for 10 lines; faceplate is service-replaceable |
| 73 | Protection | microSD ESD (CLK, CMD, D0–D3) | TI TPD4E05U06DQAR | 2 | Proposed (v1.1: TPD6E05U06 ×1 → TPD4E05U06 ×2) | none | as line 62 | TPD1E04U04DPYR per line | UHS-I at 1.8 V: 0.5 pF keeps SDR104 edges. 8 channels for 6 lines |
| 74 | Protection | Button ESD (Power, Action, Vol+, Vol−) | TI TPD1E10B06DPYR | 4 | Proposed | none | as line 36 | onsemi ESD9B5.0ST5G | — |
| 75 | Interfaces | Faceplate low-speed ESD (I2C, SPI/DBI, INT/RST, TE, LED, PDM, detect, spares) | TI TPD4E05U06DQAR | 6 | Proposed (v1.1: TPD6E05U06 ×3 → TPD4E05U06 ×5; v1.9: ×5 → ×6) | none | as line 62 | TPD1E04U04DPYR per line | v1.9: 24 channels for **21** lines (pinout v1 §8.2: I2C 2, SPI/DBI 5, touch 2, panel 2, interrupts 2, LED 3, PDM 2, detect 1, spare GPIO 2); the v1.2 count below missed one. Before: 20 channels for the 20 lines (v1.2: LED_R, LED_G, LED_B replace the status LED PWM line; LED outputs ≤ 4.55 V, below the 5.5 V VRWM, SLVSBO7O p. 7). The faceplate bank is 3.3 V (VCCIO5), so the LSF0204 escape footprints are dropped: faceplates translate on their own side (pin plan §5.1) |
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
