OpenDAP-org/board/(commit log)

2026-10-22 BOM v1 after cross-validation; ADR 0010 audio master clock source
    Cross-validated BOM v1 and report; power tree updated (HAT 5 V boost,
    2 A battery budget, mux interlock). MCLK decided as NDK NSC5083A
    (ADR 0010). Pin plan and ADR 0009 references corrected; BOM v0 and
    the v1 draft superseded.
    Claude-Session: https://claude.ai/code/session_011s9nL16Tn8V3eU39F8coPP
2026-10-22 MCLK on stocked 3.3 V NSC5083D through a passive attenuator (ADR 0010 revised)
    No dependence on the unstocked 1.8 V NSC5083A. Dedicated MCLK_3V3 LDO
    from VSYS; ST pins at 3.3 V logic; ADR 0009 clock line revised.
    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
2026-10-22 BOM v1: datasheet review findings (25 items, resolved and open)
    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
2026-10-22 BOM v1.1: close the datasheet-review findings
    TPS61088 (no longer on ti.com) -> TPS61089; MCLK LDO 3.1 V (ADR 0010
    amended); HAT translator with OE; Schmitt-input MaskROM logic; DF40
    re-allocation; RK809-5 rail map from the ROCK 3C schematic; battery
    path derated to 1.6 A; display driver path confirmed (mainline 7.3,
    DKMS until then). Remaining open points listed in sections 7 and 9.
    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
2026-10-22 BOM v1.2: safe power margins, RGB status LED, HAT pinout from hat-standard
    TPS62826 3 A buck for vcc3v3_sys; HAT power connector 30 -> 50 contacts;
    LP5521 RGB LED driver; battery path sized for the full output budget
    (ADR 0011, supersedes ADR 0007; interim pack Adafruit 328); pin plan
    maps the RK3566 onto the hat-standard interface spec.
    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
2026-10-22 Pin plan: faceplate pinout now owned by the t1 interface spec (RFC 0001)
    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
2026-10-22 BOM v1.2: review of the new parts' datasheets (D26-D30)
    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
2026-10-22 ADR 0012: headphone output stage to the segment's power (six OPA1622, ±6 V)
    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
2026-10-22 Research: high-current battery search for ADR 0011 (no stocked 1S pack meets it)
    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
2026-10-22 Research: 2S battery architecture; ADR 0011 branch status
    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
2026-10-22 BOM v1.3: ADR 0012 output stage, TPS62826 inductor, margins
    Six OPA1622 with paralleled halves and gain 1.62; LT3045/LT3094 at
    ±6.04 V from ±7.0 V TPS65131 pre-rails (TPS7A4901/TPS7A3001 removed);
    Würth 744373240047 inductor for the TPS62826 (D27); margin table and
    OpenDAP OS output ceiling with the interim pack (power tree §4.10.1,
    §4.11). ADR 0012 autonomy note corrected with the power-tree range.
    Open: TPS65131 simulation (conditional margin), its inductor (D31).
    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
2026-10-22 BOM v1.3: findings from the new parts' datasheets (D32-D35)
    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
2026-10-22 BRD-053: assembly variants (full prototypes, depopulated production)
    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
2026-10-22 Requirements: HDI and advanced build-up, prototyped through PCBWay services
    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
2026-10-22 BRD-055: flat cables included explicitly
    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
2026-10-22 Scope of BRD-004/005: the main board; HATs follow HCS-013
    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
2026-10-22 BOM v1.4 and pin plan: HAT interface v1 (fewer native lines, freed SoC pins)
    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
2026-10-22 Board: 2S battery, amplifier rails and simulations (BOM v1.6)
    - ADR 0014: two-cell battery with a quoted pack (T1-038 exception),
    BQ25798 charger, TPS62136 3.8 V pre-regulator, TPS62903 bucks,
    BQ28Z610-R1 gauge, 5 A fuse, Micro-Fit connector, ship FET.
    Supersedes ADR 0011.
    - ADR 0015: -7 V pre-rail from an LMR33630C inverting buck-boost and
    paralleled LT3045/LT3094 pairs, after the output-stage simulation
    found the TPS65131 inverter at 101 % of its limit at full-scale peaks.
    - MaskROM window fix (TPS3808G01), EEPROM at 0x50, 5.1 V output cap.
    - Research: output-stage, bucks and MaskROM simulations (ngspice
    netlists in sim/), 2S pre-freeze checks.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
2026-10-23 BOM v1.7: key holder, haptics and NFC (lines 122-128)
    Claude-Session: https://claude.ai/code/session_017LPKL9zXVgjjDnR5HkMuUL
2026-10-24 Align board docs with ADR 0014, ADR 0015 and hat-standard ADR 0004
    Electronics plan task E0.1. Stale text only; no decision, requirement
    priority or status changes.
    - BOM v1: BQ25798 binding already in linux-next (line 39, section 3,
    open questions 21-22, risks 6 and 19); TPS65131 inverter items
    superseded by ADR 0015 (open question 15, risk 9, D31); ADR 0011
    status in open question 3; pogo field per hat-standard ADR 0004
    (line 67: 4 x 25 = 100 at 2.54 mm, Mill-Max 0965 second source;
    open question 20 and D36 closed); D20 and D21 line references.
    - Power tree v0: simulated studies in the status line; inverter,
    BQ25798 and Debian driver items updated.
    - ADRs 0007, 0008, 0009, 001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
2026-10-24 PCB design constraints v0.1 (BRD-060)
    Claude-Session: https://claude.ai/code/session_014BJ4LyBAxLcpVCphpLCysj
2026-10-24 Main board product rules, net classes and rule test board; kicad-lib submodule
    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
    [t1-main-board-rules-test.kicad_pcb]
2026-10-24 Simulation regression checks for the three board studies (odapkit sim)
    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
2026-10-24 Hooks v0.4.0 with kicad-dru-composed
    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
2026-10-24 ADR 0016: front-side height under the display (E2.5)
    Area study from BOM v1.7: the board needs both sides and about
    2,100-3,700 mm2 of parts under the display. Front zone 1.0 mm, gap
    1.3 mm, taken from body thickness (24 -> 25 mm); battery pocket
    unchanged.
    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
2026-10-24 Research: RK3566 layout rules from Rockchip's documents (E1.11)
    Transcribes with page cites what the RK3566 datasheet and hardware
    design guide and the RK3568 high-speed PCB guide say for PCB-I-01..09,
    PCB-S-01..06, PCB-G-02/03 and PCB-P-10, and what each UNVERIFIED value
    in the constraints spec now resolves to. LPDDR4X is 50/100 ohm per
    Rockchip; the 0.4 mm ring escapes with dog-bone microvias, without
    via-in-pad, by arithmetic on the package drawing.
    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
2026-10-24 PCB design constraints v0.2: height zones from ADR 0016
    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
2026-10-24 PCB design constraints v0.3: signal classes and escape from Rockchip's documents
    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
2026-10-24 Research: interface standards' layout windows (E1.11)
    USB 2.0 and USB 3.2 from the USB-IF specifications; PCIe Gen 2, MIPI
    D-PHY, SDR104 and HS200 from the Rockchip RK3568 high-speed PCB guide
    and RK3566 hardware design guide, with TI, Qualcomm and Microchip
    guides as comparison (secondary, since PCI-SIG, MIPI and JEDEC texts
    are member-only). Proposes values for PCB-I-01 to PCB-I-04 and
    PCB-I-06 without editing the constraints.
    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
2026-10-24 PCB design constraints v0.4: radio from Murata's 2EL notes, interface standards
    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
2026-10-24 PCB design constraints v0.5: compliance constraints with RFC 0010 levels; RF trace per Murata
    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
2026-10-24 Research: industry wisdom gaps for the T1 main board
    33 proposed constraints (PCB-S-09 to S-12, I-10, I-11, I-09 rewording,
    A-13 to A-18, P-11 to P-18, R-04, R-05, E-04, E-05, T-07 to T-11,
    G-09, G-10, H-01) and 11 plan proposals, each with its RFC 0010 level.
    Constraints, plan and rules are not edited.
    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
2026-10-24 MCLK attenuator study; gauge-only BQ28Z610; 5.1 V capacitor; sim JSON
    Electronics plan E1.4, E1.5, E1.6 and E4.12.
    - sim/mclk-attenuator: new ngspice study of ADR 0010's clock path (two
    NSC5083D, compensated attenuator, two CS43198 XTI pins, 50 ohm traces)
    with run.py (--json) and checks.toml. Proposed 820 ohm || 27 pF at
    each oscillator, 47 ohm + 2.0 kohm || 2.2 pF at each XTI pin: every
    XTI limit passes with a typical oscillator output; with the weakest
    drive the NDK catalogue allows, two 10 pF pins exceed the oscillator's
    15 pF rating (xo-load fails). BOM §7 item 1 narrowed.
    - BOM §7 item 22 narrowed (lines 42, 43) from TI SLUUC81; item 28
    closed (line 121) on Murata SimS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
2026-10-24 PCB design constraints: point to the shared constraints method
    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
2026-10-24 Feature blocks: T1 block catalog and variant files (E10.1, E10.2)
    - docs/specs/feature-blocks.md: 49 blocks covering BOM v1.7 per
    RFC 0011 (amended: bound by, boundaries for the largest swap), with
    interface, power domain and switch, measurement point, absent state,
    swap classes, alternates and software per block; the variant format
    opendap.board-variant/v1; KiCad 10.0.7 variant support tested; a
    sketch of odapkit variant and its absent-state check; 21 gaps for the
    schematic (switches, shunts, isolation).
    - hardware/variants: full, production and lite (proposal).
    Claude-Session: https://claude.ai/code/session_014BJ4LyBAxLcp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
2026-10-24 DFM and reliability DRC rules: holes, edges, assembly, spacing, routing, battery
    Thirty product rules from new desk research
    (docs/research/2026-10-pcb-dfm-reliability-rules.md): mounting holes
    (PCB-H), board edges and panel tabs (PCB-B), assembly (PCB-D), IPC-2221B
    termination spacing (PCB-V), copper necks, teardrops and via counts
    (PCB-W), battery and heat placement (PCB-L). Every rule name carries its
    RFC 0010 quality level, and the existing rules are retagged. Naming
    conventions the rules rely on are in hardware/rules/README.md. The test
    board fires every rule once in the FAIL column and nothing in PASS.
    Claude-Session: https://cla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
    [t1-main-board-rules-test.kicad_pcb]
2026-10-24 PCB design constraints v0.6: DFM families, industry-wisdom gaps, craft net classes
    - Constraints: mounting holes (H), edges and panel (B), assembly (D),
    voltage spacing (V), routing hygiene (W) and battery and heat (L) as
    constraint rows with levels; the industry-wisdom gaps under new IDs
    (mapping appended to the gaps note); PCB-I-09 reworded (no guard traces,
    MCLK branch <= 20 mm from sim/mclk-attenuator); PCB-E-04 merges gap G-25.
    - Net classes follow the craft convention: MCLK_50SE, I2S_50SE,
    EMMC_SD_50SE, RF_50SE, DDR_50SE, DDR_100D, PCIE_REFCLK_100D.
    - hardware/t1-main-board: rule manifest and composed rules (pcbway-hdi,
    opendap-craft, product rules), craft check configurati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
    [t1-main-board-rules-test.kicad_pcb]
2026-10-24 Product rules: H-01, H-02 marked UNVERIFIED, L-02 an error; kicad-lib checker update; recomposed project rules
    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
2026-10-24 ADR 0017: fuel gauge wiring, 3 mΩ sense resistor, production configuration
    Closes BOM §7 item 22 (a)-(c), task E1.4: the BQ28Z610-R1 stays; PACK
    moves to the switched side of the ship FET so a stored T1 drains about
    1 µA (4.7 µA maximum, target 5 µA) instead of at least 111 µA; the sense
    resistor becomes 3 mΩ (WSL12063L000FEA); the three conflicting TRM
    defaults are set explicitly. BOM and power-tree changes listed in the
    consequences.
    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
2026-10-24 ADR 0018: Molex 146153-0050 antenna, shared configuration, regional routes
    Research for E1.13: Murata's FCC, ISED and Japan antenna lists, fit in the
    T1's top band, certification route per regional variant and the RF exposure
    path (FCC 1.1307 thresholds, RSS-102 Issue 6, EN 50566). One Molex
    146153-0050 on the top wall in Murata's shared configuration; the layout
    keeps the dedicated configuration open. BOM line changes listed in the ADR.
    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
2026-10-24 PCB design constraints v0.7: antenna rows from ADR 0018
    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
2026-10-24 BOM v1.8 and power tree v0.2: radio 1.8 V rail, DDR supplies, feature-block gaps
    E1.12: vcc1v8_wl (TPS62826 from VSYS_LV, EN on SWOUT1) for the Type 2EL
    AVDD18; LPDDR4X VDD1 and the VDDQ LDO bias moved from vcc_1v8 (off in
    suspend) to vcca1v8_pmu as on the ZERO 3W and Quartz64; vcc_ddr divider
    checked (1.113 V).
    E1.15: G1-G21 applied: always-on 1.8 V group on vcca1v8_pmu, DAC I2C
    isolation switch, MCLK and PERST# AND gates, PN7160 on VSYS_LV through a
    load switch, 35 block measurement links, fifth INA236, 16 GB eMMC option.
    Gaps table statuses updated in feature-blocks.md.
    Folds in ADR 0017 (gauge PACK wiring, 3 mOhm sense, storage drain) and
    ADR 0018 (one Molex 146153-0050, shared configu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
2026-10-24 Master clock divided from twice the frequency (ADR 0019, E1.14)
    The NSC5083D symmetry (40-60 %) cannot meet the CS43198's 45-55 % and two
    XTI pins overload the oscillator behind the passive attenuator. Compared
    a 45-55 % oscillator, a buffer per DAC and a divide-by-two: NSC5083D at
    45.1584 / 49.152 MHz, one SN74AUC1G74 per DAC on a new MCLK_1V8 rail
    (TPS7A2018, EN from DAC_DIG_1V8). Duty 50 +/- 1.7 % from the datasheet;
    sim/mclk-divider: 20 checks pass (XTI duty 45.08-54.35 %, oscillator net
    13.7 pF, 43-56 dB under the phase-noise mask). Amends ADR 0010; BOM line
    changes listed in the ADR for the BOM owner.
    Claude-Session: https://clau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
2026-10-24 Pinout v1: RK3566 ball map, IO domains, faceplate contact positions (E1.1, E1.2)
    Every RK3566 ball checked against the RK3566 datasheet Rev 1.1 and the
    hardware design guide V1.1.0: domain, mux, reset pull and ring position.
    Wake lines on PMU balls, nothing relayed by the coprocessor; 28 v0
    conflicts with their resolution; FH35C-51S contact order proposal; BOM
    and power-tree change list reconciled with BOM v1.8 and power tree v0.2.
    Machine-readable copy in hardware/pinout/pinout-v1.csv for the schematic
    check.
    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
    [pinout-v1.csv]
2026-10-24 BRD-061: antennas compatible with an anodised-aluminium case
    Research note on metal-case antennas: a non-metallic top end cap with
    the listed Molex 146153-0050 (preferred) or the aluminium frame as
    antenna fed through a spring contact; faceplate excluded, back cover
    last resort. Constraints PCB-R-08 to R-13 (stub-free case-antenna
    branch, matching, ESD, case-ground contacts, variants), ADR 0018 note.
    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
2026-10-24 ADR 0018 note: radio performance aim, dedicated Bluetooth antenna as target
    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
2026-10-24 BOM v1.9 and power tree v0.3: divided master clock, pinout v1 items, suspend decisions
    - ADR 0019: NSC5083D-45.158M / -49.152M, one SN74AUC1G74 per DAC on a
    new MCLK_1V8 rail (third TPS7A2018, EN = DAC_DIG_1V8), divider
    passives; attenuator removed; HAT MCLK copy constraint (line 112).
    - Pinout v1 B1-B16: vccio6_1v8 link, IO-domain rail table, HAT3V3_EN
    on expander P01, BOOTSEL FET, PCA9306 EN network, VBUS divider,
    pulls and series parts, expander port map, RK809 codec pins,
    faceplate ESD for 21 lines; items marked closed in pinout v1.
    - Decisions of 2026-10-24 under the maintainers' delegation: radio
    rails switched from expander P06 (TPS22919 for AVDD33), off in
    suspend unles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
    [pinout-v1.csv]
2026-10-24 Pinout v1: MCLK_DIV_RUN, radio power and PDn hold through suspend (BOM items 39, 40)
    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
    [pinout-v1.csv]
2026-10-24 ADR 0020: battery connected through contacts
    The 2S pack connects through six KYOCERA AVX 70-9258-001-120-006
    spring-finger contacts in a window of the pocket floor, pressing on
    recessed hard-gold pads of the pack's terminal board: two 6 A contacts
    per power pole (3.2 A worst continuous at 33 % of one contact),
    2.1 mm working height inside 1.6-2.8 mm, no Kelvin sense, the ship
    FET as insertion soft start, BATP RC and ESD at the contacts, cover
    detect as a should. Amends ADR 0014 items 1 and 2. Research note
    with the pack specification additions and PCB-L-04 to PCB-L-10
    proposals; BOM line changes listed in the ADR consequences.
    Claude-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
2026-10-24 BOM v1.10, power tree v0.4, PCB constraints v0.9: battery through contacts (ADR 0020)
    - BOM line 47: Micro-Fit 3.0 -> six KYOCERA AVX 70-9258-001-120-006
    (P+, P+, empty, mid-cell tap, NTC, P-, P-); line 46 pack terminal board
    with recessed hard-gold pads and keying; lines 39, 42, 48, 104 wording;
    line 115 BATP 47 nF; new lines 142 (contact ESD, DNP P+ TVS) and 143
    (cover detect, should); freed 2.5 mm lead allowance noted.
    - Power tree §4.7.1: BRD-049 margins through the contacts (33 % at 3.2 A,
    52 % at 5 A on the hotter contact), contact resistance and heat.
    - PCB constraints: PCB-L-04 to L-10 merged; DRC rules for L-04, L-05,
    L-08 (warning, UNVERIFIED distance); BAT_SENSE net c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
    [t1-main-board-rules-test.kicad_pcb]
2026-10-24 BOM v1.11, power tree v0.5, constraints v0.10: HAT interface v1.1, faceplate interface v1
    Applies hat-standard interface v1.1 and its ADR 0005 to the board:
    - One DF40C-100 pair per cable end (87 of 96 usable, corners are metal
    fittings per the DF40 catalog p. 10 note 3); DF40C-50 pair removed.
    - 68 pogo pins; HAT ESD TPD4E05U06 x4 + x8, TPD1E10B06 x0 (line out gone).
    - New line 144: two TMUXHS4412IRUAR share EXT0-EXT4 between PCIe and
    CSI-2; BRD-042 figures recorded (13 GHz BW, -0.7 dB IL and -23 dB RL at
    2.5 GHz, typical). PCIe TX caps on the SoC side of the switch.
    - Limiters against the new fault ceilings, tolerance included: eFuse #A
    1.68 A, eFuse #B 1.16 A; TPS2121 RILM 44.2 ->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
    [pinout-v1.csv, t1-main-board-rules-test.kicad_pcb]
2026-10-24 HAT flat-cable specification (E1.8) and the flex impedance study
    Spec for the board-to-device-side-piece flat cable (BRD-013) on HAT
    interface v1.1: conductor map, PCBWay 4-layer 0.268 mm stack-up, pairs as
    L2 striplines (EXT 100 ohm, USB 90 ohm, I2S 50 ohm), power widths for the
    3.0/1.5/4.5 A fault ceilings, shielding, steel stiffeners, bend, length
    assumptions, coupon members and the inputs the case must give. Hirose
    recommends the DF40 header on the FPC, so BOM line 66 swaps genders
    (listed for the board owner with the other changes).
    sim/flex-impedance: 2D field solver used for both flat cables until
    odapkit stackup exists.
    Claude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
2026-10-24 Stackup v1: 10-layer HDI 2+6+2, 1.07 mm, geometry of every impedance class
    Decided by Claude under the maintainers' delegation; to be confirmed by
    PCBWay's DFM (stack-up request deferred). Four routing layers each next
    to ground (L3, L8 striplines between grounds), four ground planes, two
    power planes paired with ground at 65 µm; L1->L3 and L10->L8 at 235 µm
    for Murata's RF microstrip with an L2/L9 cut-out. Widths and gaps per
    class from odapkit stackup (toolkit-hardware), with fab corners. Lists
    the net-class and constraint changes to apply.
    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
2026-10-24 HAT flat cable: stack-up file, impedance from odapkit stackup
    hardware/hat-flat-cable/stackup-v0.toml records the PCBWay 4-layer FPC
    stack-up and the three impedance classes; odapkit stackup check passes
    (D100 62.5/150 um 100.1 ohm, D90 72.5/100 um 89.9 ohm, S50 66 um
    50.0 ohm, fab corners reported). The spec takes its widths and corners
    from it; sim/flex-impedance stays as the cross-check and for loss,
    coupling, the film comparison and power sizing.
    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
2026-10-24 Constraints v0.11 and DRC for stackup v1 impedance classes
    Applies stackup v1 §7: net classes carry the stackup, outer and inner
    width and gap, and their layers; constraints v0.11 updates PCB-S-01 to
    S-06, S-11, S-12, adds S-14 (impedance classes on L1, L3, L8, L10 only)
    and S-15 (delay matching across layers), the impedance-class exception
    to PCB-G-01, widths and gaps in PCB-I-01 to I-09 and I-12, PCB-I-07 as a
    microstrip over a cut-out, the RF stack values and RF_CUTOUT (PCB-R-03),
    the I-10 pad-void note and the stackup debt in §9.
    Product rules for the 10-layer board: per-layer width bands per class
    (computed width -5 %/+5 %, floor 0.075 mm), pair-gap minimums as
    clearances between the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
    [t1-main-board-rules-test.kicad_pcb]
2026-10-24 RK3566 BGA escape study: three signal layers, no via-in-pad
    escape.py places the escape vias and routes the escape of every used
    ball of pinout v1 on 8- and 10-layer 1+N+1 boards (L2, L7 ground,
    assumed: no stackup spec yet), with the composed T1 rules. Result on
    both: 149 signals out on L1, 105 on L3, 6 on L4, none deeper; no via in
    any pad; DRC 0 errors. The planes under the core break up (25
    unconnected power and ground items): the 9 mil inner hole-to-copper
    value clears more than the 0.65 mm pitch around each mechanical via.
    The boards are generated, not committed, because of those unconnected
    items; results, plots and the research note are.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
2026-10-24 kicad-lib at 878c769: library parts for the T1; recomposed project rules
    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
